JoshChomps/7_DOF_Arm/hardware/bom_order1.csv

board | qty | refs | value | footprint | mpn | lcsc | fit
A | 4 | C1 C2 C6 C7 | 100nF | C_0603_1608Metric | AM03B104K500NT | C20616238 | PCBA
A | 3 | C10 C11 C12 | 47uF | C_1210_3225Metric | HGC1210R5476M250NSVK | C7432791 | PCBA
A | 1 | C3 | 1000uF 35V | CP_Radial_D12.5mm_P5.00mm |  |  | hand
A | 2 | C4 C5 | 4.7uF | C_1206_3216Metric | HHV1206R7475K101NSPJ | C22367839 | PCBA
A | 1 | C8 | 4.7nF | C_0603_1608Metric | CGA0603X7R472K500JT | C7503499 | PCBA
A | 1 | C9 | 47pF | C_0603_1608Metric | CSA0603C0G470J500JT | C18220914 | PCBA
A | 1 | D1 | BZT52C15 15V | D_SOD-123 |  |  | PCBA
A | 2 | D2 D5 | SMCJ26CA | D_SMC |  |  | PCBA
A | 1 | D3 | S1M flyback | D_SMA |  |  | PCBA
A | 1 | D4 | COIL ON yellow | LED_0603_1608Metric | YLED0603Y | C19273152 | PCBA
A | 1 | D6 | MOTOR PWR red | LED_0603_1608Metric | XL-1608SURC-06FJ | C7371900 | PCBA
A | 1 | D7 | B560C | D_SMC |  |  | PCBA
A | 1 | D8 | +5V green | LED_0603_1608Metric | F.0603.00025/P2-0603G1TS2-06T-002 | C7496818 | PCBA
A | 1 | F1 | 2A logic | Fuse_1812_4532Metric |  |  | PCBA
A | 1 | F2 | 1A coil | Fuse_1206_3216Metric |  |  | PCBA
A | 1 | F3 | J1+J2 blade | Fuseholder_Blade_Mini_Keystone_3568 |  |  | hand
A | 1 | F4 | J3+J4 blade | Fuseholder_Blade_Mini_Keystone_3568 |  |  | hand
A | 1 | F5 | J5-J7 blade | Fuseholder_Blade_Mini_Keystone_3568 |  |  | hand
A | 1 | F6 | AUX/tool blade | Fuseholder_Blade_Mini_Keystone_3568 |  |  | hand
A | 1 | J1 | 24V IN XT30 male | AMASS_XT30UPB-M_1x02_P5.0mm_Vertical |  |  | hand
A | 1 | J10 | 5V AUX | JST_XH_B2B-XH-A_1x02_P2.50mm_Vertical |  |  | hand
A | 1 | J2 | E-STOP NC loop | TerminalBlock_Phoenix_MKDS-1,5-2-5.08_1x02_P5.08mm_Horizontal |  |  | hand
A | 1 | J3 | CONTACTOR COIL 24V | TerminalBlock_Phoenix_MKDS-1,5-2-5.08_1x02_P5.08mm_Horizontal |  |  | hand
A | 1 | J4 | CONTACTOR MAIN 1=line 2=load | TerminalBlock_Phoenix_MKDS-3-2-5.08_1x02_P5.08mm_Horizontal |  |  | hand
A | 1 | J5 | MOT J1+J2 XT30 female | AMASS_XT30UPB-F_1x02_P5.0mm_Vertical |  |  | hand
A | 1 | J6 | MOT J3+J4 XT30 female | AMASS_XT30UPB-F_1x02_P5.0mm_Vertical |  |  | hand
A | 1 | J7 | MOT J5-J7 XT30 female | AMASS_XT30UPB-F_1x02_P5.0mm_Vertical |  |  | hand
A | 1 | J8 | AUX/tool XT30 female | AMASS_XT30UPB-F_1x02_P5.0mm_Vertical |  |  | hand
A | 1 | J9 | TO BOARD B | JST_XH_B8B-XH-A_1x08_P2.50mm_Vertical |  |  | hand
A | 1 | L1 | 6.8uH | L_7.3x7.3_H4.5 | ZEMS0730-6R8M | C41415571 | PCBA
A | 2 | Q1 Q2 | AOD4185 | TO-252-2 |  |  | PCBA
A | 1 | Q3 | DMN6075S | SOT-23 |  |  | PCBA
A | 2 | R1 R2 | 10k | R_0603_1608Metric |  |  | PCBA
A | 1 | R10 | 90.9k | R_0603_1608Metric |  |  | PCBA
A | 1 | R11 | 200k | R_0603_1608Metric | ABD03K2003FT | C43720265 | PCBA
A | 1 | R12 | 16.9k | R_0603_1608Metric |  |  | PCBA
A | 1 | R13 | 53.6k | R_0603_1608Metric |  |  | PCBA
A | 1 | R14 | 10.2k | R_0603_1608Metric |  |  | PCBA
A | 1 | R15 | 1k | R_0603_1608Metric |  |  | PCBA
A | 1 | R3 | 100 | R_0603_1608Metric |  |  | PCBA
A | 1 | R4 | 100k | R_0603_1608Metric |  |  | PCBA
A | 1 | R5 | 0R bypass, fitted | R_1206_3216Metric |  |  | PCBA
A | 2 | R6 R8 | 10k | R_1206_3216Metric |  |  | PCBA
A | 1 | R7 | 2m | R_2512_6332Metric |  |  | PCBA
A | 1 | R9 | 442k | R_0603_1608Metric |  |  | PCBA
A | 1 | TP1 | 24V_IN | TestPoint_Pad_D1.5mm |  |  | pad only
A | 1 | TP2 | 24V_PROT | TestPoint_Pad_D1.5mm |  |  | pad only
A | 1 | TP3 | MOTOR_RAIL | TestPoint_Pad_D1.5mm |  |  | pad only
A | 1 | TP4 | +5V | TestPoint_Pad_D1.5mm |  |  | pad only
A | 1 | TP5 | COIL_LOW | TestPoint_Pad_D1.5mm |  |  | pad only
A | 1 | TP6 | GND | TestPoint_Pad_D1.5mm |  |  | pad only
A | 1 | TP7 | 24V_LOGIC | TestPoint_Pad_D1.5mm |  |  | pad only
A | 1 | U1 | TPS54560BDDA | Texas_R-PDSO-G8_EP2.95x4.9mm_Mask2.4x3.1mm_ThermalVias | TPS54560BDDAR |  | PCBA
A | 1 | U2 | INA226 | TSSOP-10_3x3mm_P0.5mm |  |  | PCBA
B | 1 | C3 | 1uF | C_0603_1608Metric | HGC0603R7105K250NTHJ | C33546005 | PCBA
B | 3 | C1 C4 C5 | 10uF | C_0805_2012Metric | HGC0805R5106K250NSLJ | C19103847 | PCBA
B | 4 | C2 C6 C7 C8 | 100nF | C_0603_1608Metric | AM03B104K500NT | C20616238 | PCBA
B | 1 | D1 | WS2812B-2020 status | LED_WS2812B-2020_PLCC4_2.0x2.0mm |  |  | PCBA
B | 2 | D2 D3 | SS14 | D_SMA |  |  | PCBA
B | 1 | D4 | 3V3 green | LED_0603_1608Metric | F.0603.00025/P2-0603G1TS2-06T-002 | C7496818 | PCBA
B | 1 | J1 | USB-C (native USB, CDC) | USB_C_Receptacle_GCT_USB4105-xx-A_16P_TopMnt_Horizontal |  |  | PCBA
B | 1 | J10 | SPARE GPIO | PinHeader_1x14_P2.54mm_Vertical |  |  | hand
B | 1 | J2 | CAN A: H L GND | JST_XH_B3B-XH-A_1x03_P2.50mm_Vertical |  |  | hand
B | 1 | J3 | CAN B: H L GND | JST_XH_B3B-XH-A_1x03_P2.50mm_Vertical |  |  | hand
B | 1 | J4 | E-STOP AUX NC (to GND) | JST_XH_B2B-XH-A_1x02_P2.50mm_Vertical |  |  | hand
B | 1 | J5 | HALL 1: 5V GND OUT | JST_XH_B3B-XH-A_1x03_P2.50mm_Vertical |  |  | hand
B | 1 | J6 | HALL 2: 5V GND OUT | JST_XH_B3B-XH-A_1x03_P2.50mm_Vertical |  |  | hand
B | 1 | J7 | MT6701 SSI: 3V3 GND CSN CLK DO | JST_XH_B5B-XH-A_1x05_P2.50mm_Vertical |  |  | hand
B | 1 | J8 | TO BOARD A | JST_XH_B8B-XH-A_1x08_P2.50mm_Vertical |  |  | hand
B | 1 | J9 | UART0: TX RX GND | PinHeader_1x03_P2.54mm_Vertical |  |  | hand
B | 1 | JP1 | CAN TERM (fit = bus end) | PinHeader_1x02_P2.54mm_Vertical |  |  | hand
B | 8 | R1 R2 R7 R9 R10 R11 R12 R15 | 10k | R_0603_1608Metric |  |  | PCBA
B | 2 | R13 R14 | 4.7k | R_0603_1608Metric |  |  | PCBA
B | 2 | R3 R4 | 5.1k | R_0603_1608Metric |  |  | PCBA
B | 1 | R5 | 0R (Rs: 10k-100k = slope control) | R_0603_1608Metric |  |  | PCBA
B | 1 | R6 | 120 | R_1206_3216Metric |  |  | PCBA
B | 2 | R8 R16 | 1k | R_0603_1608Metric |  |  | PCBA
B | 1 | SW1 | RESET | SW_Push_1P1T_XKB_TS-1187A |  |  | PCBA
B | 1 | SW2 | BOOT | SW_Push_1P1T_XKB_TS-1187A |  |  | PCBA
B | 1 | TP1 | CANH | TestPoint_Pad_D1.5mm |  |  | pad only
B | 1 | TP2 | CANL | TestPoint_Pad_D1.5mm |  |  | pad only
B | 1 | TP3 | CAN_TX | TestPoint_Pad_D1.5mm |  |  | pad only
B | 1 | TP4 | CAN_RX | TestPoint_Pad_D1.5mm |  |  | pad only
B | 1 | TP5 | +3V3 | TestPoint_Pad_D1.5mm |  |  | pad only
B | 1 | TP6 | +5VD | TestPoint_Pad_D1.5mm |  |  | pad only
B | 1 | TP7 | GND | TestPoint_Pad_D1.5mm |  |  | pad only
B | 1 | U1 | ESP32-S3-WROOM-1-N8 | ESP32-S3-WROOM-1 |  |  | PCBA
B | 1 | U2 | USBLC6-2SC6 | SOT-23-6 |  |  | PCBA
B | 1 | U3 | SN65HVD230 | SOIC-8_3.9x4.9mm_P1.27mm |  |  | PCBA
B | 1 | U4 | AP2112K-3.3 | SOT-23-5 | AP2112K-3.3TRG1 |  | PCBA
C | 1 | C1 | 1uF | C_0603_1608Metric | HGC0603R7105K250NTHJ | C33546005 | PCBA
C | 5 | C2 C6 C7 C11 C12 | 10uF | C_0805_2012Metric | HGC0805R5106K250NSLJ | C19103847 | PCBA
C | 5 | C3 C4 C5 C9 C10 | 100nF | C_0603_1608Metric | AM03B104K500NT | C20616238 | PCBA
C | 1 | C8 | 4.7uF 100V | C_1206_3216Metric | HHV1206R7475K101NSPJ | C22367839 | PCBA
C | 2 | D1 D3 | SS16 | D_SMA |  |  | PCBA
C | 1 | D2 | SMAJ36A | D_SMA |  |  | PCBA
C | 2 | D4 D5 | SS14 | D_SMA |  |  | PCBA
C | 2 | D6 D7 | green (status / 3V3) | LED_0603_1608Metric | F.0603.00025/P2-0603G1TS2-06T-002 | C7496818 | PCBA
C | 1 | J1 | 24V IN: 24V GND | JST_XH_B2B-XH-A_1x02_P2.50mm_Vertical |  |  | hand
C | 1 | J2 | CAN IN: H L GND | JST_XH_B3B-XH-A_1x03_P2.50mm_Vertical |  |  | hand
C | 1 | J3 | CAN OUT: H L GND | JST_XH_B3B-XH-A_1x03_P2.50mm_Vertical |  |  | hand
C | 1 | J4 | USB-C (programming) | USB_C_Receptacle_GCT_USB4105-xx-A_16P_TopMnt_Horizontal |  |  | PCBA
C | 1 | J5 | AUX: 3V3 IO0 IO1 TXD RXD GND | PinHeader_1x06_P2.54mm_Vertical |  |  | hand (optional)
C | 1 | JP1 | CAN TERM (open = mid-bus) | PinHeader_1x02_P2.54mm_Vertical |  |  | hand
C | 1 | L1 | 10uH | L_APV_ANR4030 | ANR4030T100M | C6808095 | PCBA
C | 7 | R1 R2 R3 R4 R10 R11 R12 | 10k | R_0603_1608Metric |  |  | PCBA
C | 2 | R5 R14 | 1k | R_0603_1608Metric |  |  | PCBA
C | 2 | R6 R7 | 5.1k | R_0603_1608Metric |  |  | PCBA
C | 1 | R8 | 0R (Rs: 10k-100k = slope control) | R_0603_1608Metric |  |  | PCBA
C | 1 | R9 | 120 | R_1206_3216Metric |  |  | PCBA
C | 1 | R13 | 100k | R_0603_1608Metric |  |  | PCBA
C | 1 | SW1 | RESET | SW_Push_1P1T_XKB_TS-1187A |  |  | PCBA
C | 1 | SW2 | BOOT | SW_Push_1P1T_XKB_TS-1187A |  |  | PCBA
C | 11 | TP1-TP11 | VIN_C +5V +3V3 GND CANH CANL CAN_TX CAN_RX ENC_CSN ENC_CLK ENC_DO | TestPoint_Pad_D1.5mm |  |  | pad only
C | 1 | U1 | ESP32-C3-WROOM-02-N4 | ESP32-C3-WROOM-02 |  |  | PCBA
C | 1 | U2 | USBLC6-2SC6 | SOT-23-6 |  |  | PCBA
C | 1 | U3 | SN65HVD230 | SOIC-8_3.9x4.9mm_P1.27mm |  |  | PCBA
C | 1 | U4 | AP2112K-3.3 | SOT-23-5 | AP2112K-3.3TRG1 |  | PCBA
C | 1 | U5 | LMR16006YQ5 (TI; DDC package) | TSOT-23-6 | LMR16006YQ5 |  | PCBA
C | 1 | U6 | MT6701CT-STD | SOIC-8_3.9x4.9mm_P1.27mm | MT6701CT-STD |  | PCBA
