JoshChomps/7_DOF_Arm/cad/bench/planetary_5to1_sun.stl

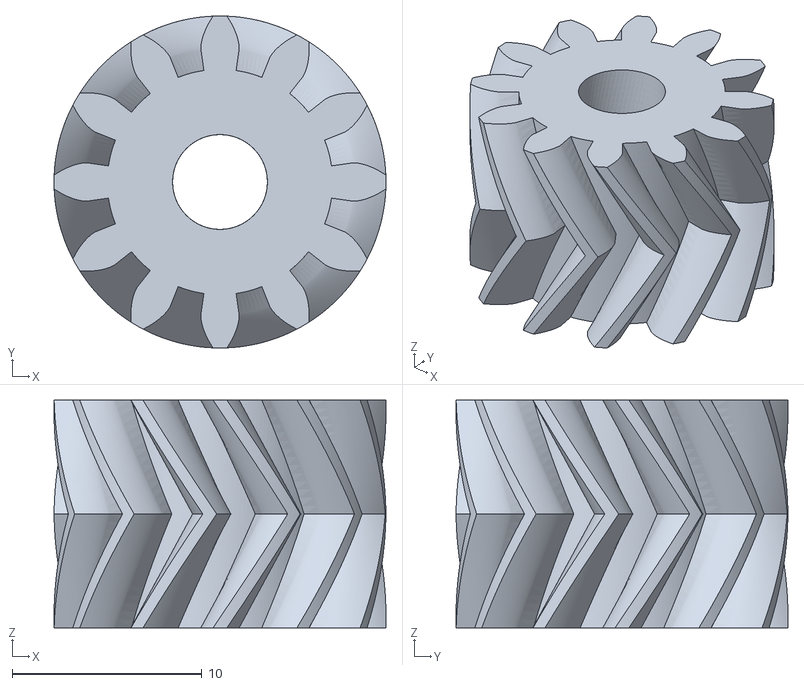
[picture p17: CAD file, 2026-10-28]
cad/bench/planetary_5to1_sun.stl
17.5 x 17.5 x 12.0
