JoshChomps/7_DOF_Arm/cad/cycloid_j1.dxf

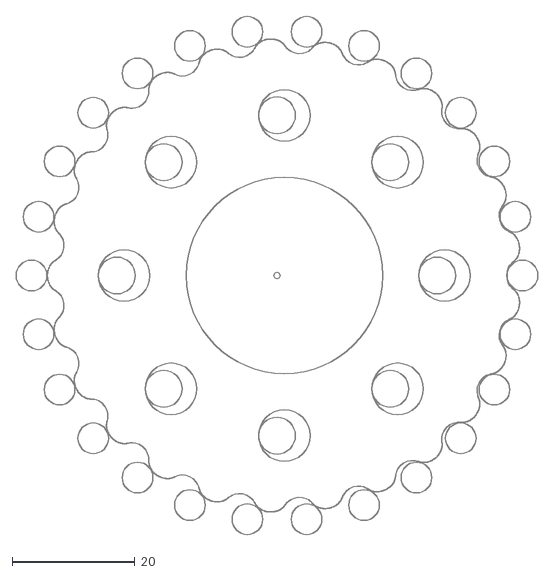
[picture p18: CAD file, 2026-10-28]
cad/cycloid_j1.dxf
85.0 x 84.4
