JoshChomps/7_DOF_Arm/software/deskarm/data/meshes/4_motor.stl

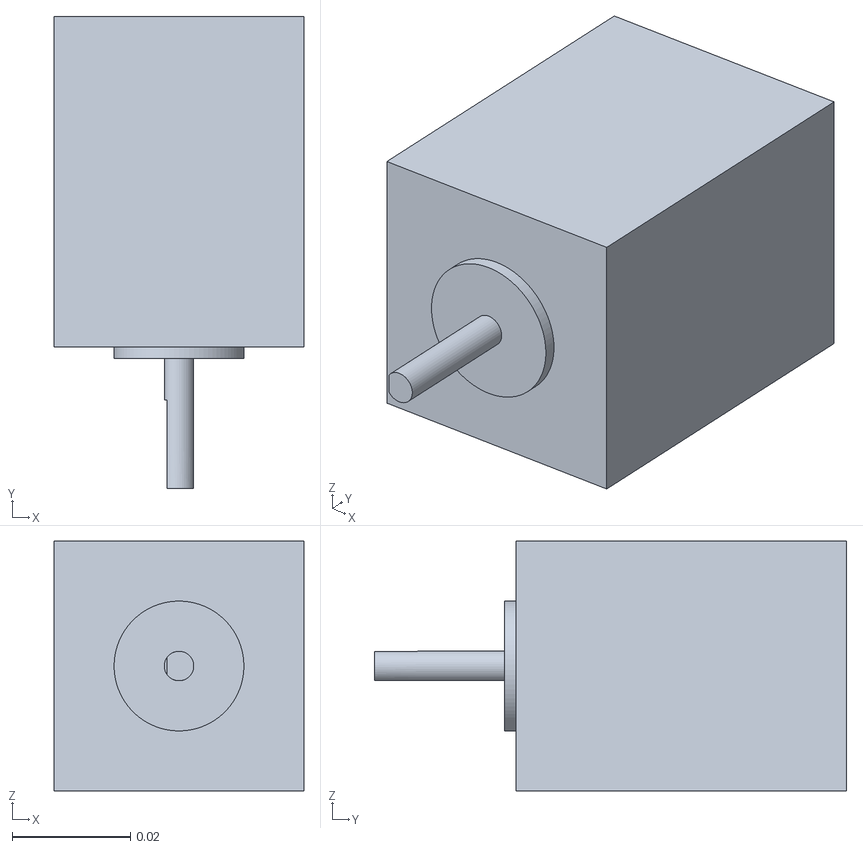
[picture p19: CAD file, 2026-10-28]
software/deskarm/data/meshes/4_motor.stl
0.0423 x 0.08 x 0.0423
