JoshChomps/7_DOF_Arm/stl/bench/C2_Lever.stl

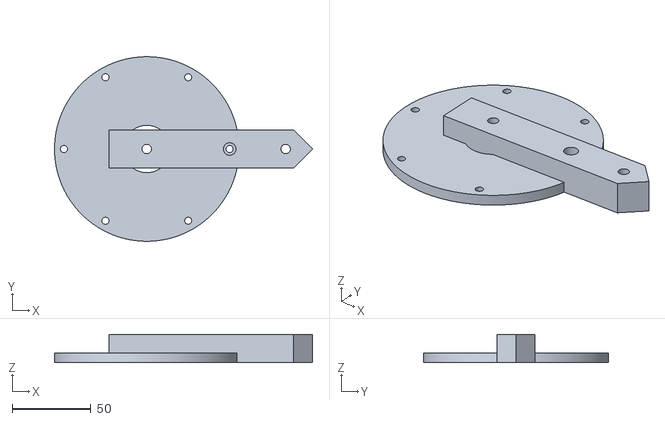
[picture p20: CAD file, 2026-10-28]
stl/bench/C2_Lever.stl
163.5 x 117.0 x 18.0
