JoshChomps/7_DOF_Arm/stl/coupons/rings_6810.stl

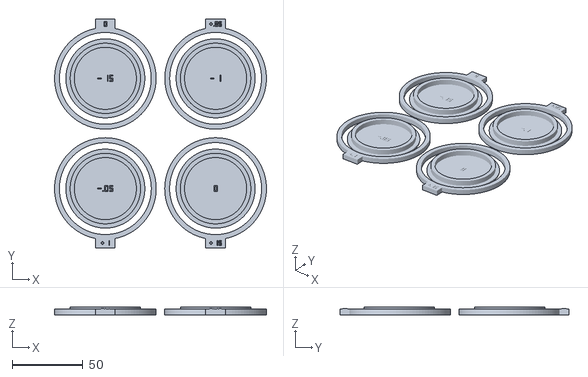
[picture p21: CAD file, 2026-10-28]
stl/coupons/rings_6810.stl
150.3 x 162.2 x 5.50
