JoshChomps/7_DOF_Arm/stl/da/DA_G_Pads.stl

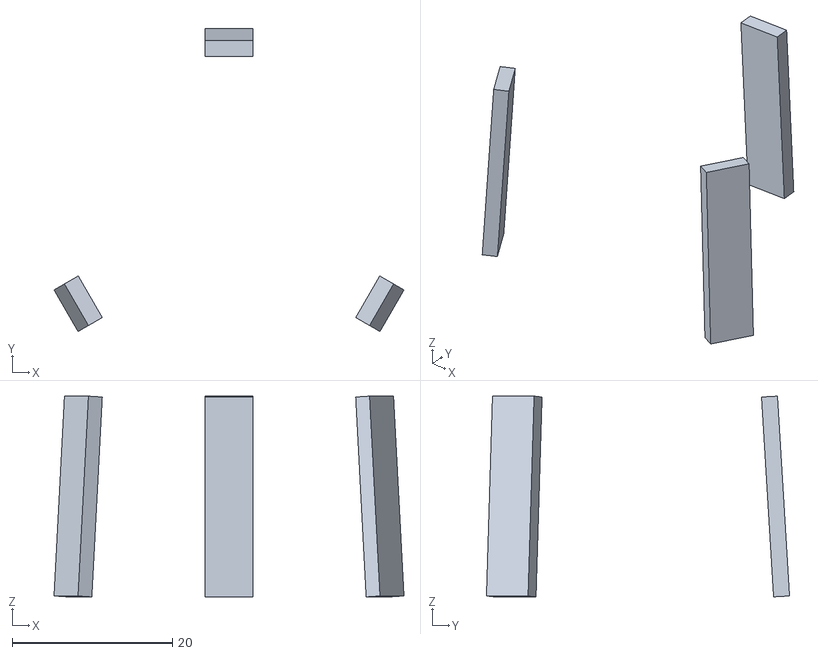
[picture p22: CAD file, 2026-10-28]
stl/da/DA_G_Pads.stl
43.7 x 37.9 x 25.1
