JoshChomps/7_DOF_Arm/stl/j1/J1_base.stl

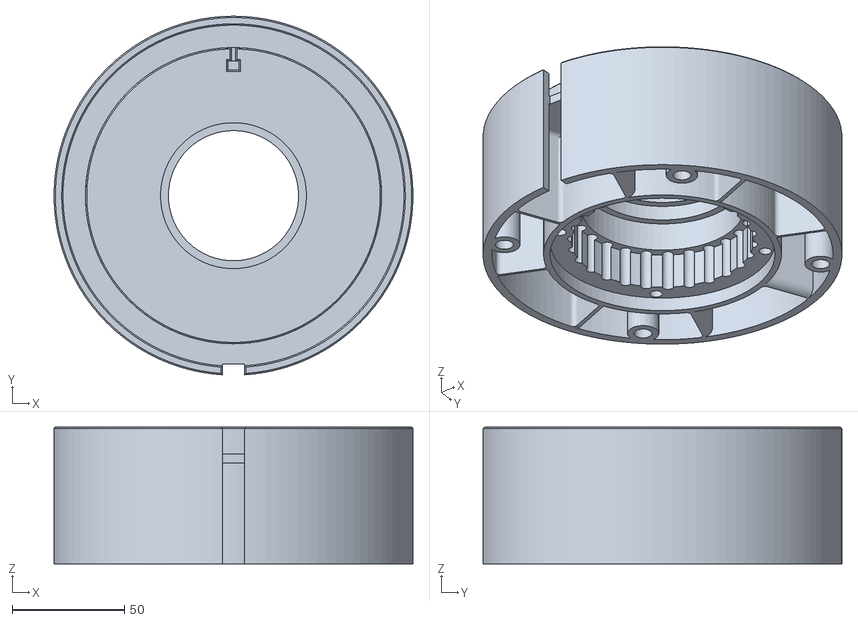
[picture p23: CAD file, 2026-10-28]
stl/j1/J1_base.stl
160.0 x 159.8 x 61.0
