JoshChomps/7_DOF_Arm/stl/plates/bench/plate_2.3mf

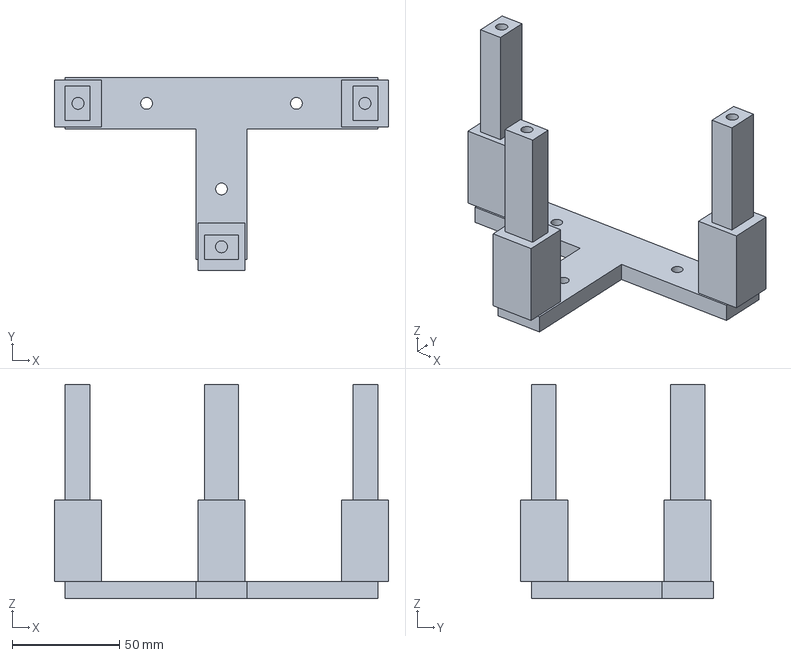
[picture p24: CAD file, 2026-10-28]
stl/plates/bench/plate_2.3mf
156.0 x 90.0 x 100.0 mm
