JoshChomps/7_DOF_Arm/stl/plates/c2/plate_6.3mf

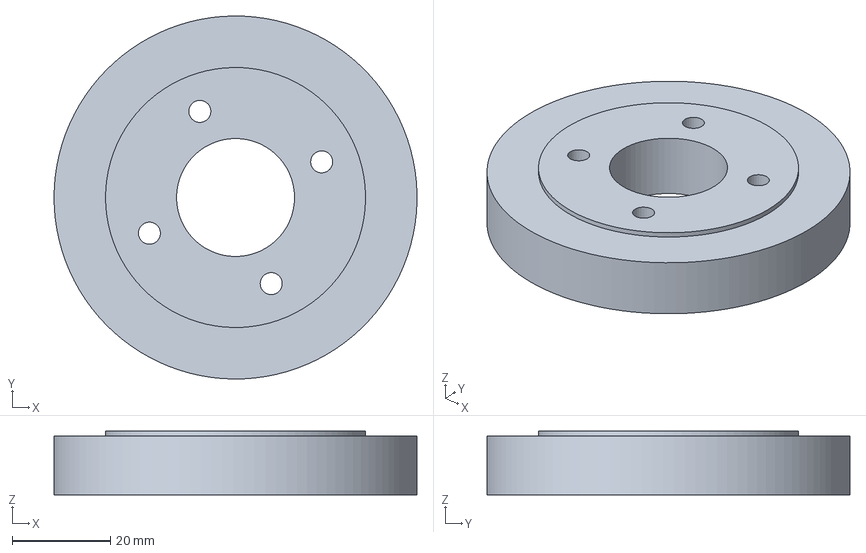
[picture p25: CAD file, 2026-10-28]
stl/plates/c2/plate_6.3mf
74.0 x 74.0 x 13.0 mm
