JoshChomps/7_DOF_Arm/stl/plates/coupons/plate_1.3mf

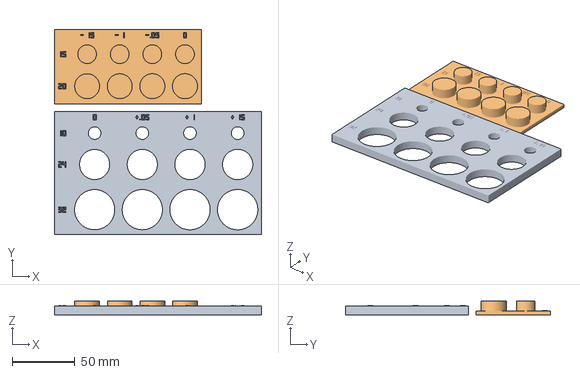
[picture p26: CAD file, 2026-10-28]
stl/plates/coupons/plate_1.3mf
165.0 x 163.8 x 11.0 mm
bearings.stl
pegs.stl
