JoshChomps/7_DOF_Arm/cad/bench/planetary_5to1_planet.stl

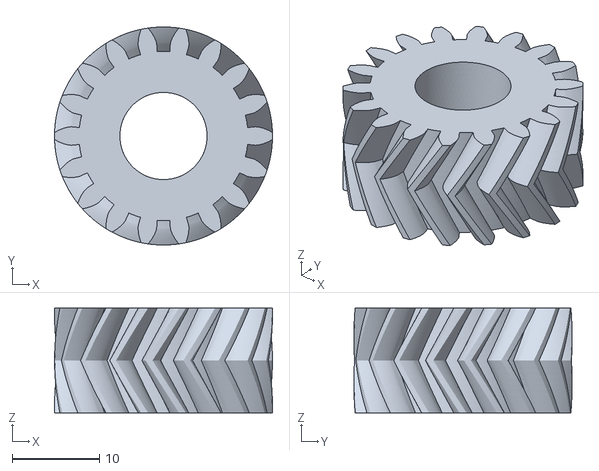
[picture p27: CAD file, 2026-10-28]
cad/bench/planetary_5to1_planet.stl
25.0 x 25.0 x 12.0
