JoshChomps/7_DOF_Arm/cad/cycloid_disc.dxf

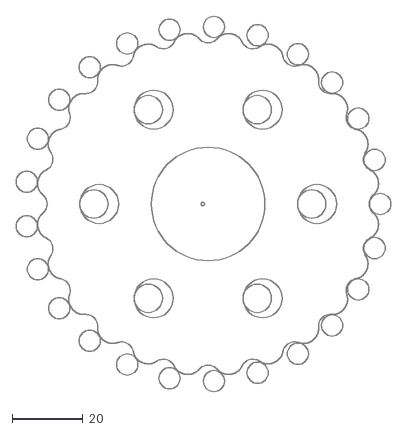
[picture p28: CAD file, 2026-10-28]
cad/cycloid_disc.dxf
105.6 x 105.8
