JoshChomps/7_DOF_Arm/software/deskarm/data/meshes/3_metal.stl

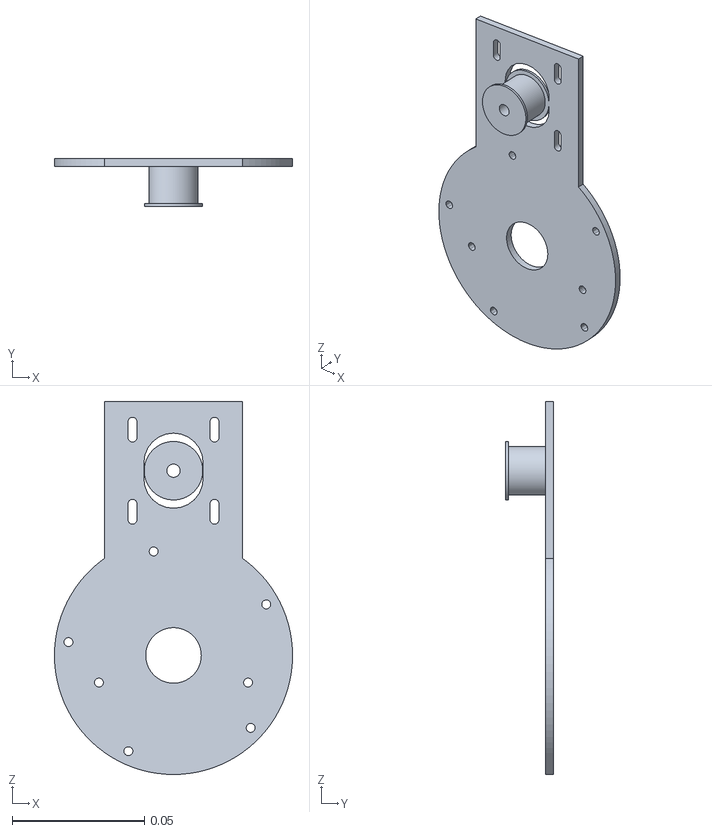
[picture p29: CAD file, 2026-10-28]
software/deskarm/data/meshes/3_metal.stl
0.09 x 0.018 x 0.141
