JoshChomps/7_DOF_Arm/stl/bench/C34_motor_plate.dxf

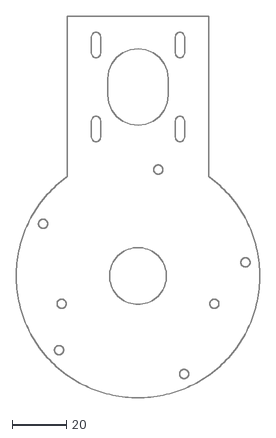
[picture p30: CAD file, 2026-10-28]
stl/bench/C34_motor_plate.dxf
90.0 x 140.9
