JoshChomps/7_DOF_Arm/stl/coupons/inserts.stl

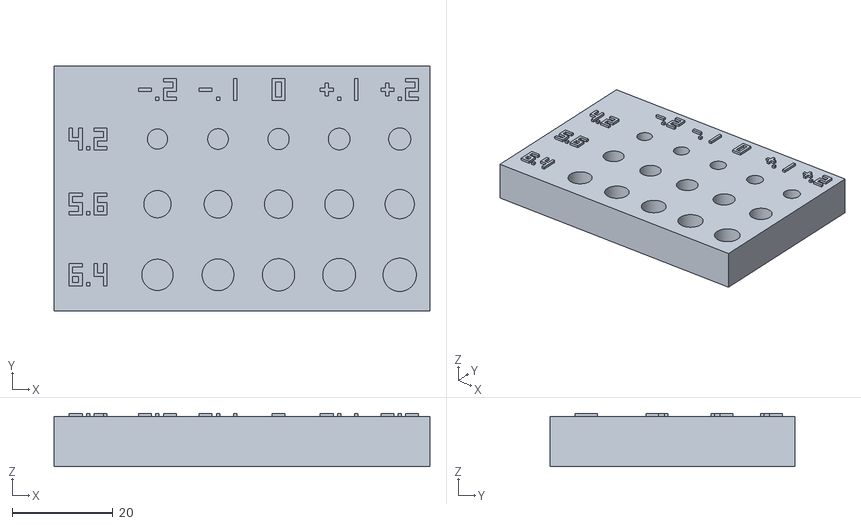
[picture p31: CAD file, 2026-10-28]
stl/coupons/inserts.stl
74.5 x 48.6 x 10.6
