JoshChomps/7_DOF_Arm/stl/da/DA_C34_Flange.stl

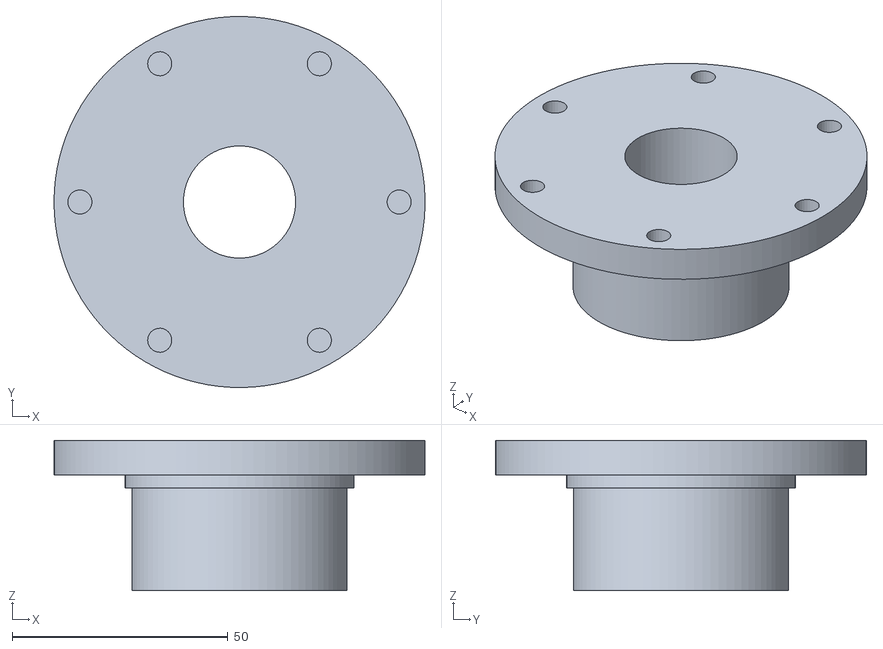
[picture p32: CAD file, 2026-10-28]
stl/da/DA_C34_Flange.stl
86.0 x 86.0 x 34.8
