JoshChomps/7_DOF_Arm/stl/j1/J1_disc.stl

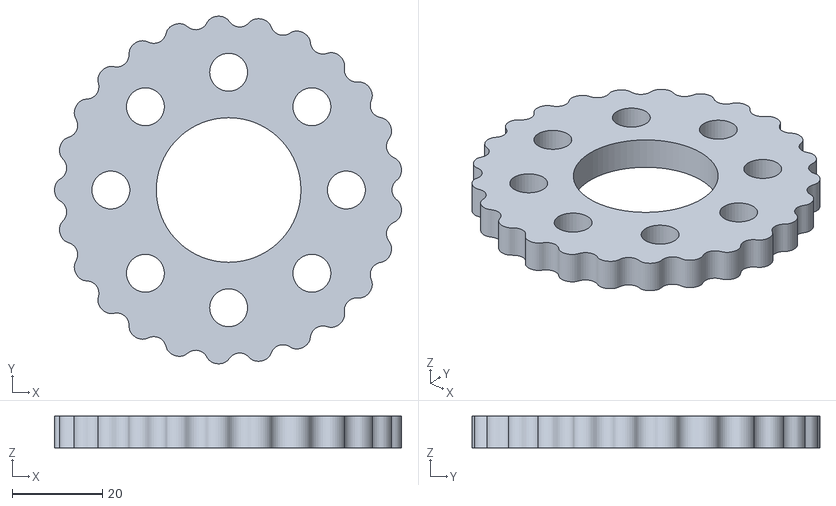
[picture p33: CAD file, 2026-10-28]
stl/j1/J1_disc.stl
76.9 x 77.1 x 7.00
