JoshChomps/7_DOF_Arm/stl/plates/c2/plate_5.3mf

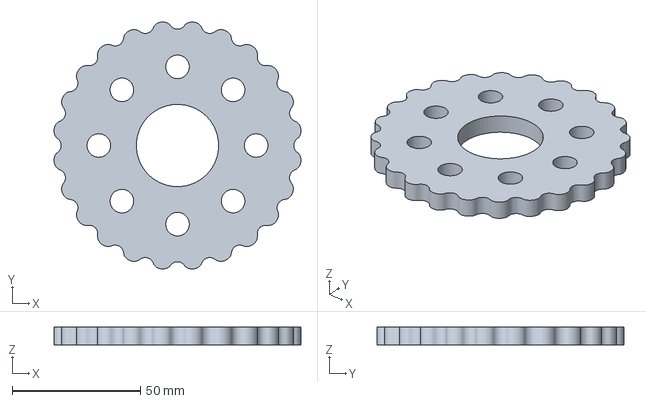
[picture p34: CAD file, 2026-10-28]
stl/plates/c2/plate_5.3mf
96.2 x 96.2 x 7.00 mm
