JoshChomps/7_DOF_Arm/stl/plates/coupons/plate_2.3mf

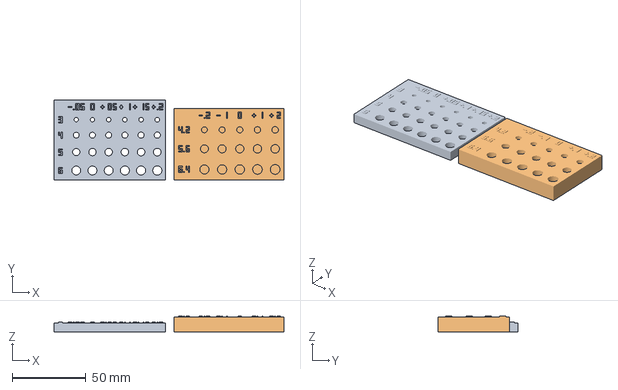
[picture p35: CAD file, 2026-10-28]
stl/plates/coupons/plate_2.3mf
156.1 x 54.4 x 10.6 mm
pins.stl
inserts.stl
