JoshChomps/7_DOF_Arm/stl/plates/rings/plate_2.3mf

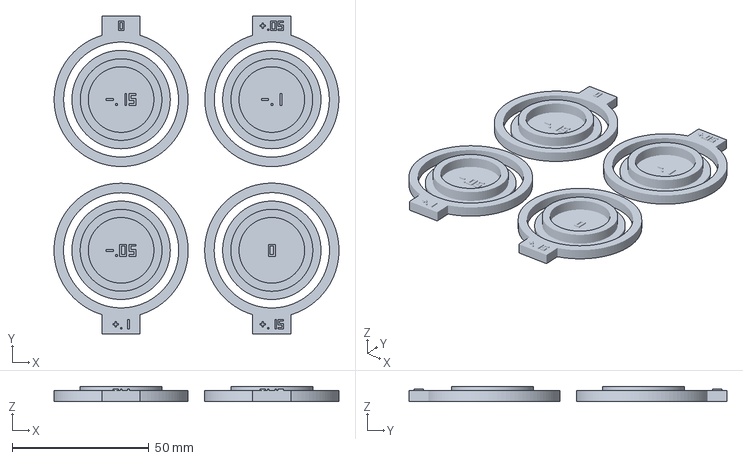
[picture p36: CAD file, 2026-10-28]
stl/plates/rings/plate_2.3mf
104.3 x 116.2 x 5.50 mm
