JoshChomps/7_DOF_Arm/cad/bench/cycloid_j2_24to1.dxf

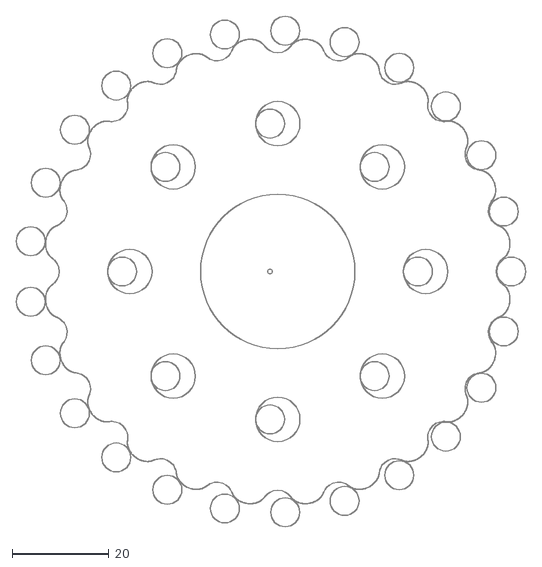
[picture p37: CAD file, 2026-10-28]
cad/bench/cycloid_j2_24to1.dxf
105.6 x 105.8
