JoshChomps/7_DOF_Arm/software/deskarm/data/meshes/2_printed.stl

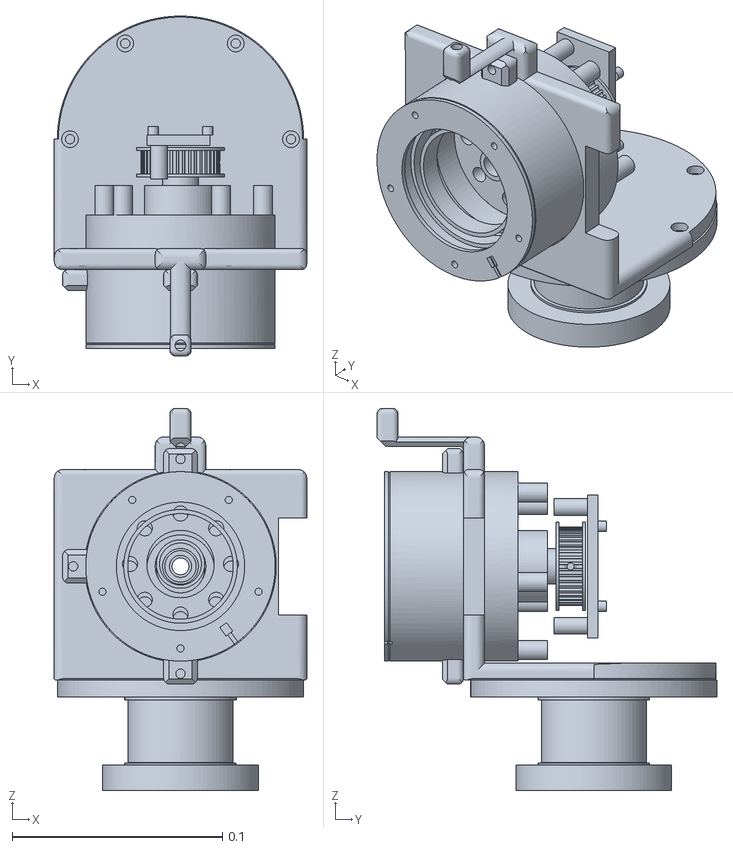
[picture p38: CAD file, 2026-10-28]
software/deskarm/data/meshes/2_printed.stl
0.12 x 0.161 x 0.182
