JoshChomps/7_DOF_Arm/stl/coupons/pins.stl

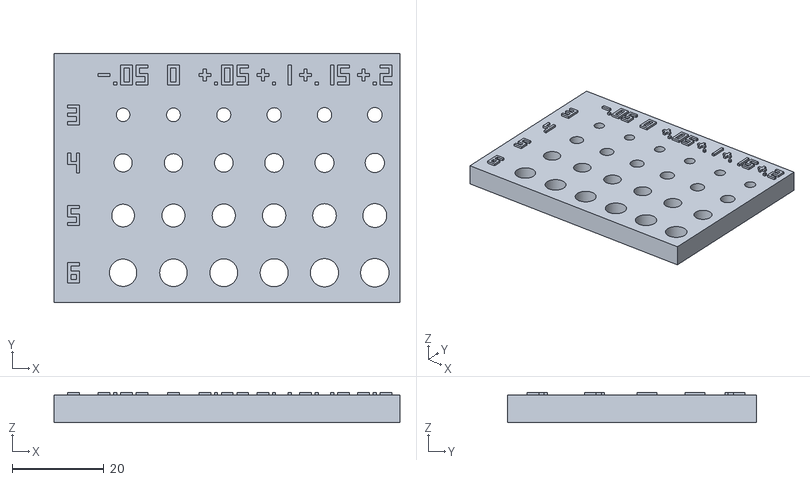
[picture p39: CAD file, 2026-10-28]
stl/coupons/pins.stl
75.6 x 54.4 x 6.60
