JoshChomps/7_DOF_Arm/stl/da/DA_P56_Housing.stl

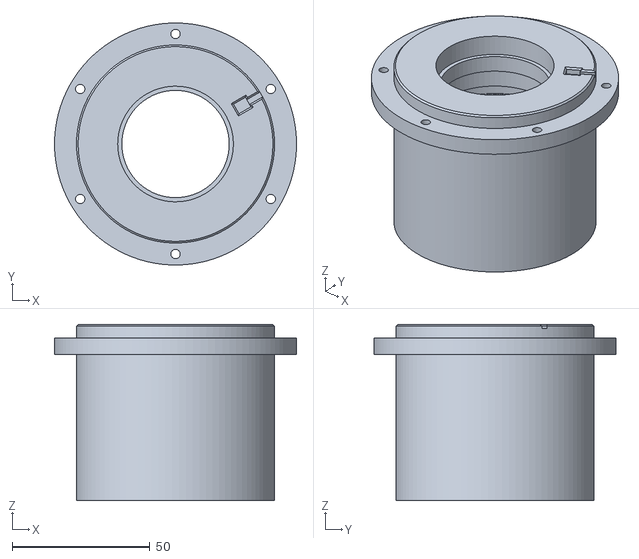
[picture p40: CAD file, 2026-10-28]
stl/da/DA_P56_Housing.stl
88.0 x 88.0 x 64.0
