JoshChomps/7_DOF_Arm/stl/j1/J1_turntable.stl

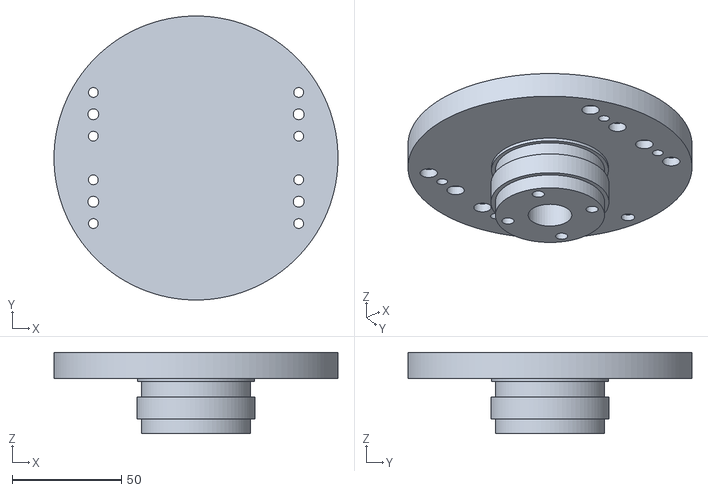
[picture p41: CAD file, 2026-10-28]
stl/j1/J1_turntable.stl
130.0 x 130.0 x 37.3
