JoshChomps/7_DOF_Arm/stl/plates/c2/plate_1.3mf

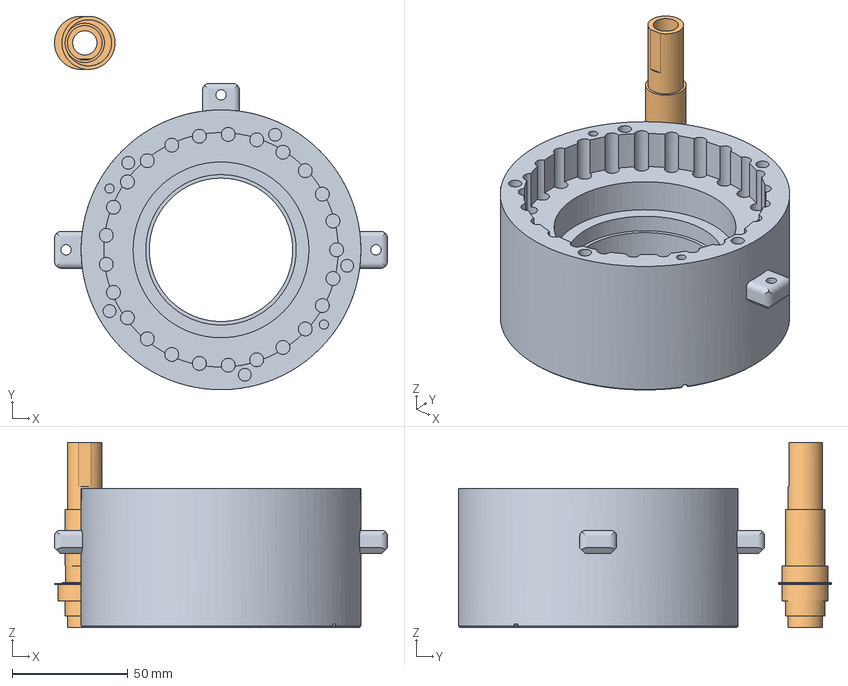
[picture p42: CAD file, 2026-10-28]
stl/plates/c2/plate_1.3mf
144.0 x 161.5 x 80.0 mm
DA_C2_Housing.stl
DA_C2_Shaft.stl
