JoshChomps/7_DOF_Arm/cad/bench/cycloid_j2_30to1.dxf

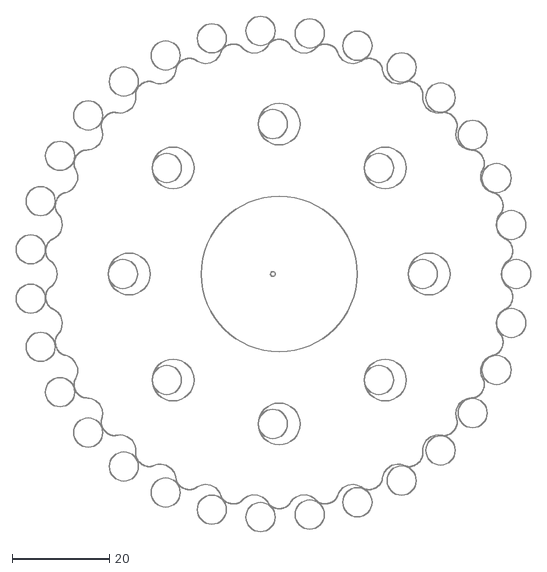
[picture p43: CAD file, 2026-10-28]
cad/bench/cycloid_j2_30to1.dxf
105.7 x 105.9
