JoshChomps/7_DOF_Arm/software/deskarm/data/meshes/1_belt.stl

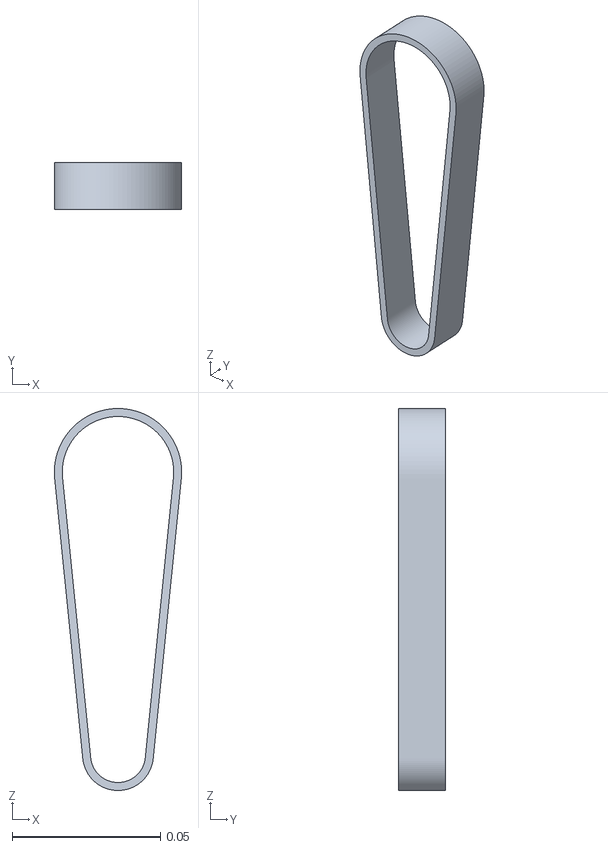
[picture p44: CAD file, 2026-10-28]
software/deskarm/data/meshes/1_belt.stl
0.043 x 0.016 x 0.129
