JoshChomps/7_DOF_Arm/stl/bench/C2_motor_plate.dxf

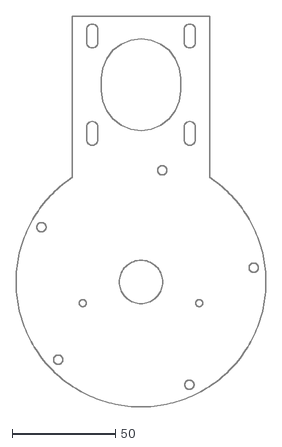
[picture p45: CAD file, 2026-10-28]
stl/bench/C2_motor_plate.dxf
121.0 x 189.2
