JoshChomps/7_DOF_Arm/stl/coupons/bearings.stl

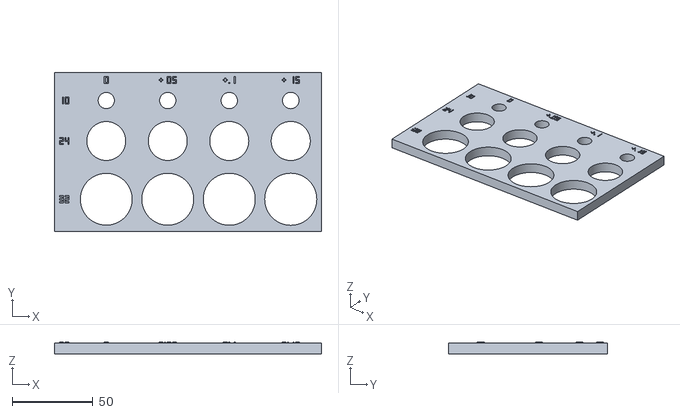
[picture p46: CAD file, 2026-10-28]
stl/coupons/bearings.stl
165.0 x 98.4 x 7.60
