JoshChomps/7_DOF_Arm/stl/da/DA_P7_Carrier.stl

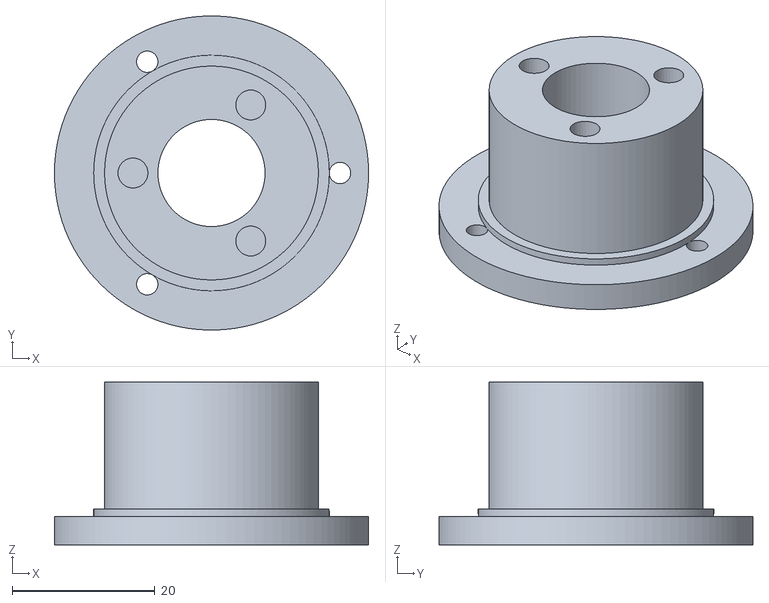
[picture p47: CAD file, 2026-10-28]
stl/da/DA_P7_Carrier.stl
44.0 x 44.0 x 22.8
