JoshChomps/7_DOF_Arm/stl/j1/J1_plate.stl

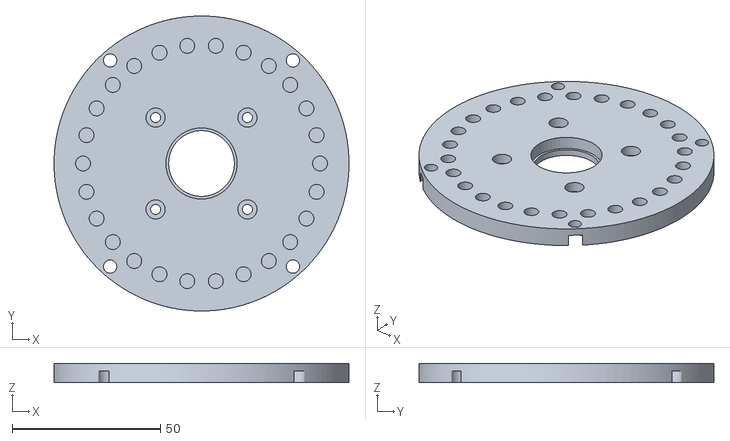
[picture p48: CAD file, 2026-10-28]
stl/j1/J1_plate.stl
99.6 x 99.6 x 6.50
