JoshChomps/7_DOF_Arm/stl/plates/c2/plate_3.3mf

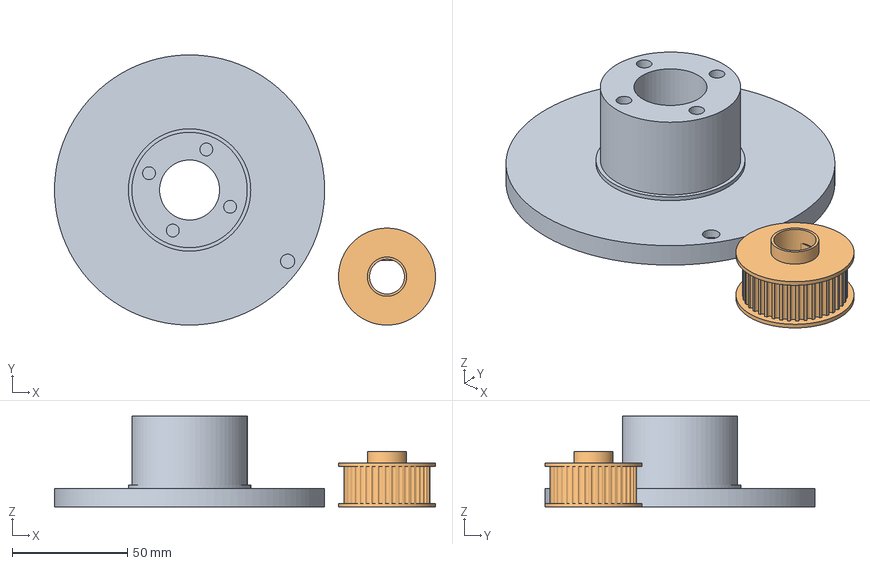
[picture p49: CAD file, 2026-10-28]
stl/plates/c2/plate_3.3mf
165.0 x 117.0 x 39.3 mm
DA_C2_Flange.stl
DA_C2_Pulley40.stl
