JoshChomps/7_DOF_Arm/cad/bench/planetary_5to1_ring.stl

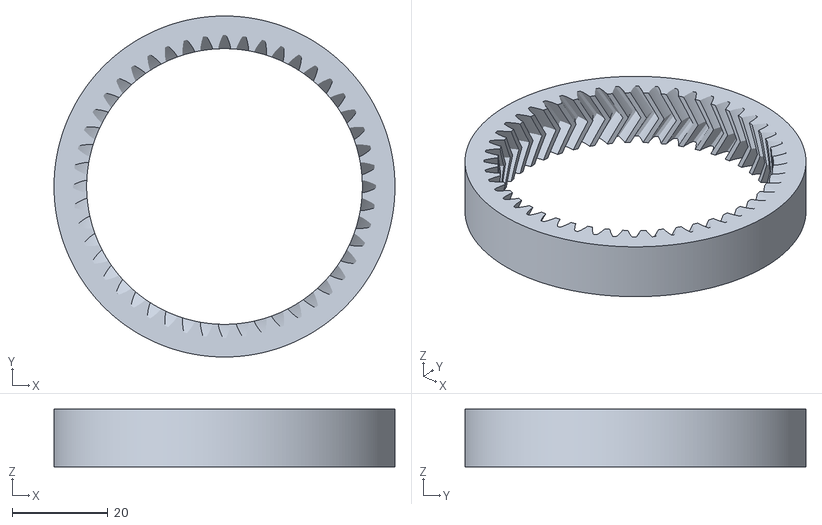
[picture p50: CAD file, 2026-10-28]
cad/bench/planetary_5to1_ring.stl
71.1 x 71.1 x 12.0
