JoshChomps/7_DOF_Arm/software/deskarm/data/meshes/4_printed.stl

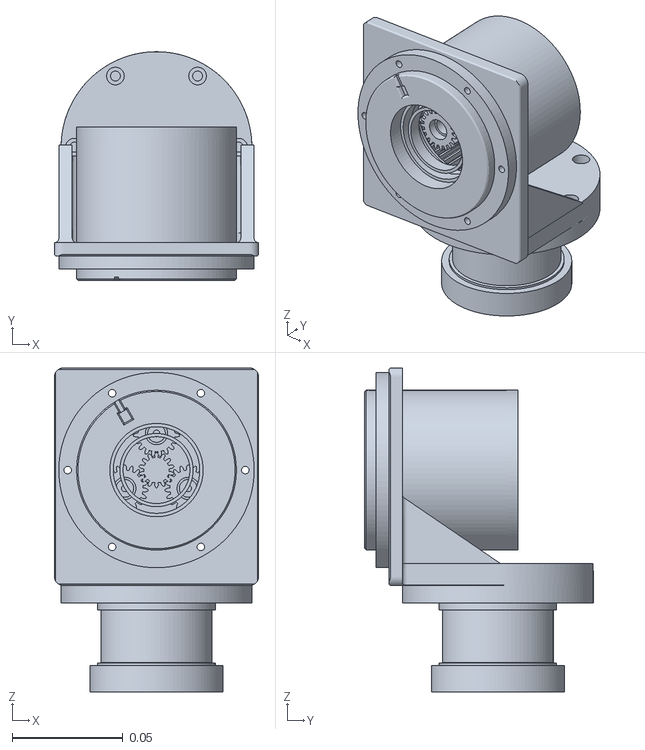
[picture p51: CAD file, 2026-10-28]
software/deskarm/data/meshes/4_printed.stl
0.092 x 0.103 x 0.146
