JoshChomps/7_DOF_Arm/stl/da/DA_P56_Flange.stl

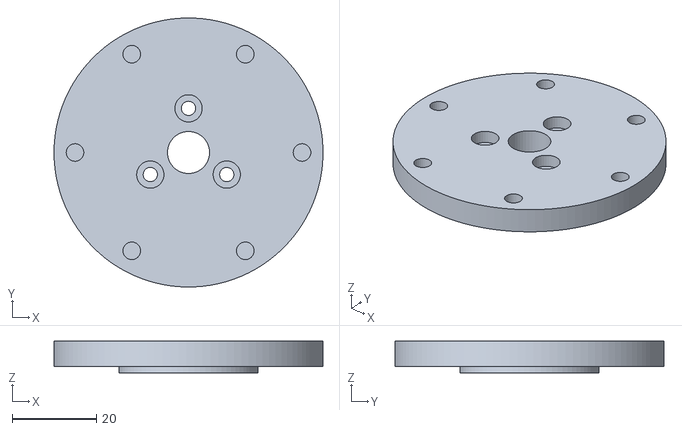
[picture p52: CAD file, 2026-10-28]
stl/da/DA_P56_Flange.stl
64.0 x 64.0 x 7.50
