JoshChomps/7_DOF_Arm/stl/j1/J1_cam.stl

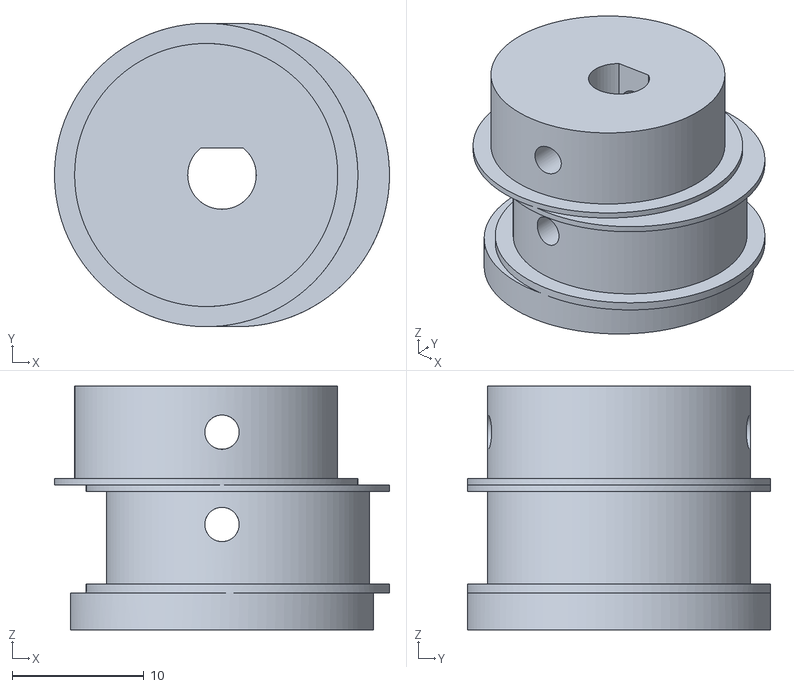
[picture p53: CAD file, 2026-10-28]
stl/j1/J1_cam.stl
25.4 x 23.0 x 18.5
