JoshChomps/7_DOF_Arm/stl/plates/c2/plate_2.3mf

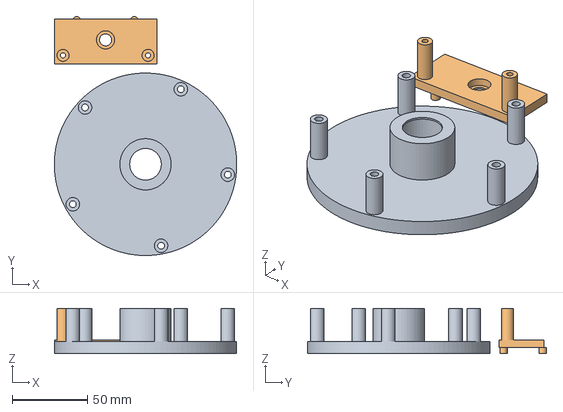
[picture p54: CAD file, 2026-10-28]
stl/plates/c2/plate_2.3mf
121.0 x 158.5 x 30.0 mm
DA_C2_Cover.stl
DA_C2_Enccap.stl
