JoshChomps/7_DOF_Arm/cad/bench/planetary_5to1_layout.dxf

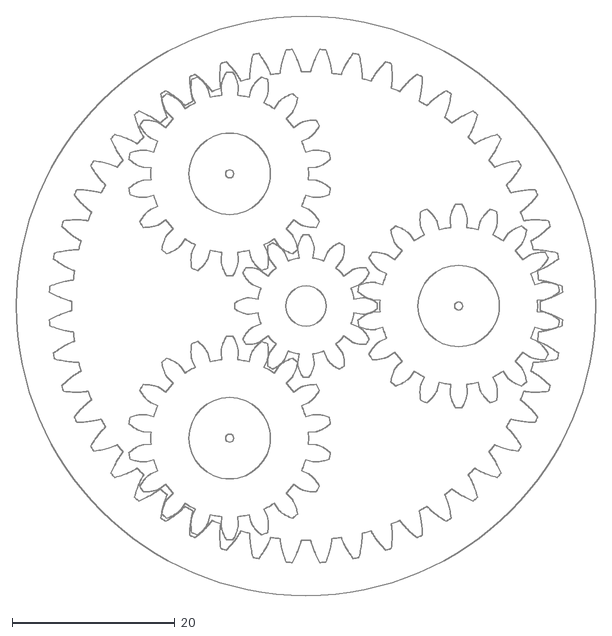
[picture p55: CAD file, 2026-10-28]
cad/bench/planetary_5to1_layout.dxf
71.1 x 71.1
