JoshChomps/7_DOF_Arm/software/deskarm/data/meshes/1_motor.stl

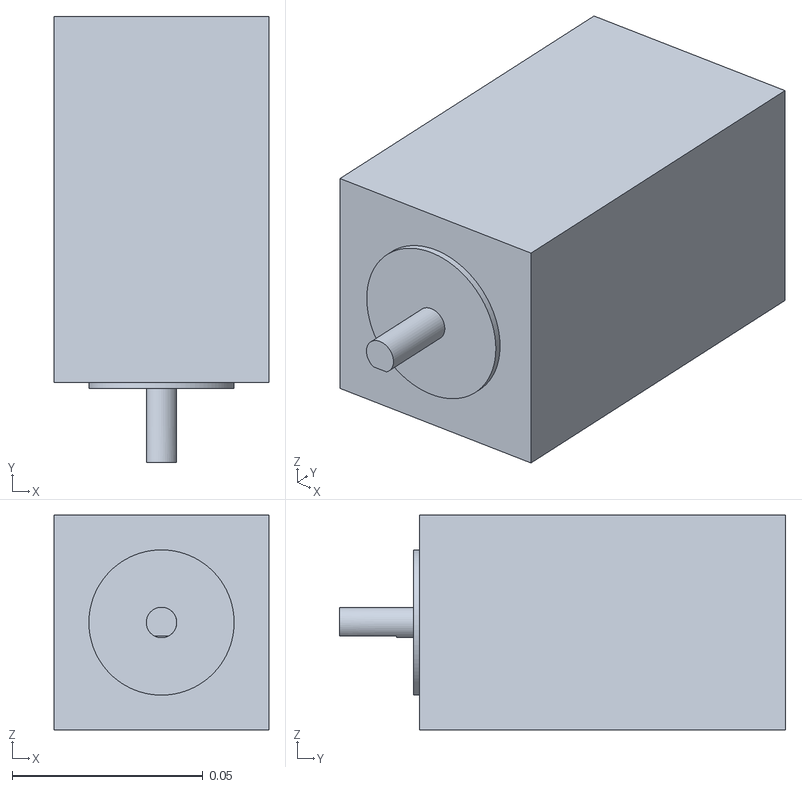
[picture p56: CAD file, 2026-10-28]
software/deskarm/data/meshes/1_motor.stl
0.0564 x 0.117 x 0.0564
