JoshChomps/7_DOF_Arm/stl/coupons/pegs.stl

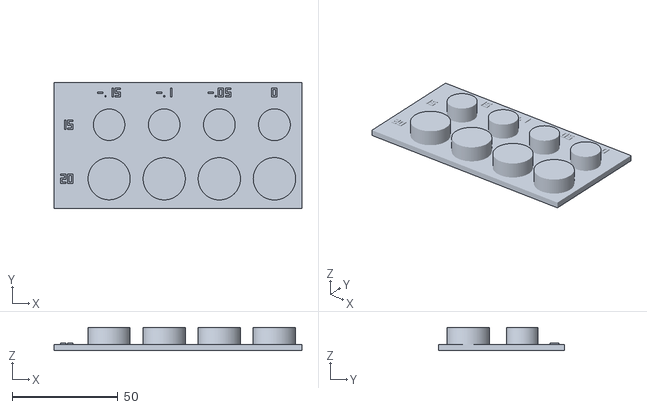
[picture p57: CAD file, 2026-10-28]
stl/coupons/pegs.stl
117.0 x 59.4 x 11.0
