JoshChomps/7_DOF_Arm/stl/da/DA_P7_Sliptube.stl

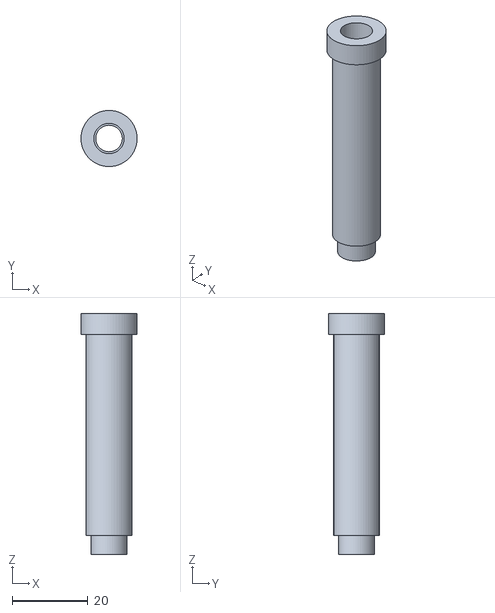
[picture p58: CAD file, 2026-10-28]
stl/da/DA_P7_Sliptube.stl
14.8 x 14.8 x 63.5
