JoshChomps/7_DOF_Arm/stl/j1/J1_carrier.stl

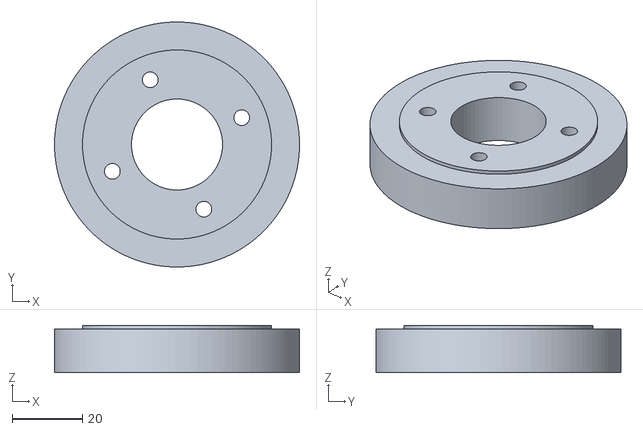
[picture p59: CAD file, 2026-10-28]
stl/j1/J1_carrier.stl
70.0 x 70.0 x 13.5
