JoshChomps/7_DOF_Arm/stl/plates/c2/plate_4.3mf

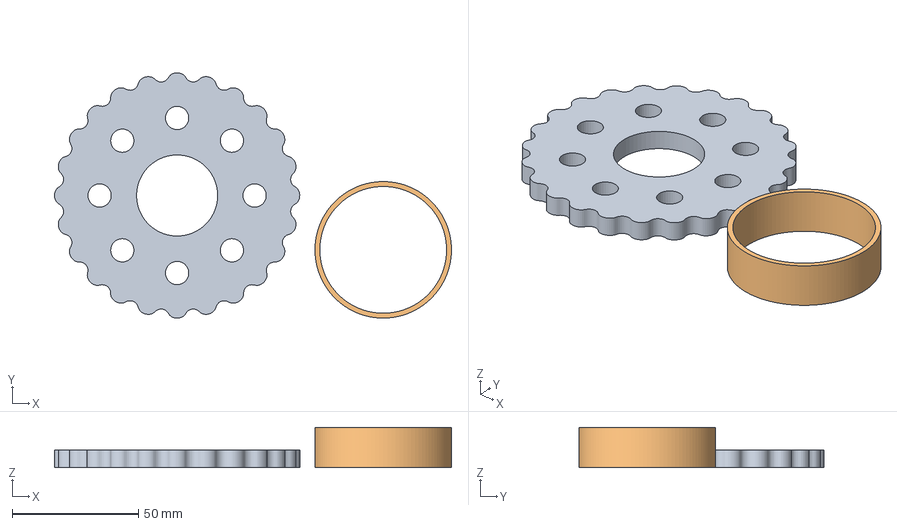
[picture p60: CAD file, 2026-10-28]
stl/plates/c2/plate_4.3mf
157.0 x 97.0 x 16.0 mm
DA_C2_Discb.stl
DA_C2_Spacers.stl
