JoshChomps/7_DOF_Arm/software/deskarm/data/meshes/5_printed.stl

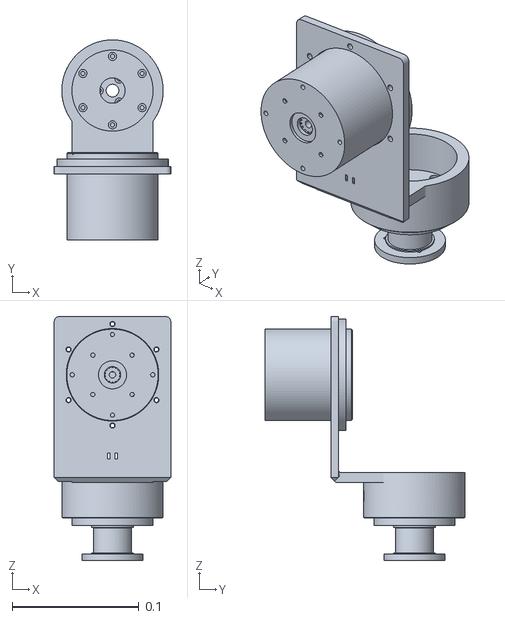
[picture p61: CAD file, 2026-10-28]
software/deskarm/data/meshes/5_printed.stl
0.092 x 0.158 x 0.192
