JoshChomps/7_DOF_Arm/stl/da/DA_L_Link6.stl

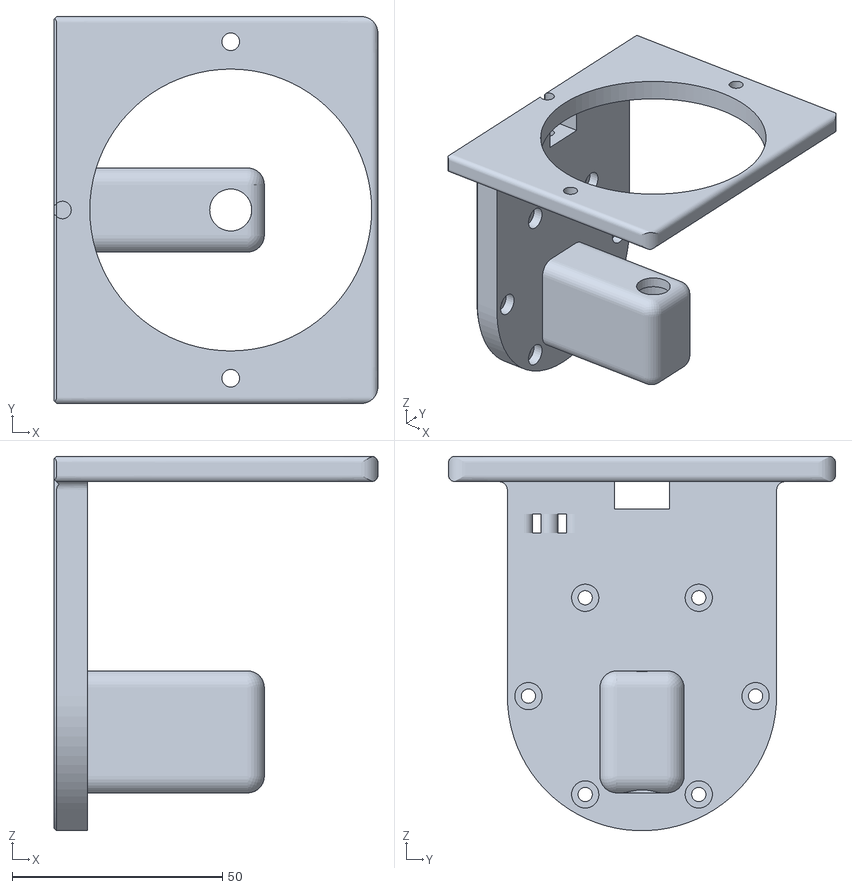
[picture p62: CAD file, 2026-10-28]
stl/da/DA_L_Link6.stl
77.0 x 92.0 x 89.0
