JoshChomps/7_DOF_Arm/software/deskarm/data/meshes/6_printed.stl

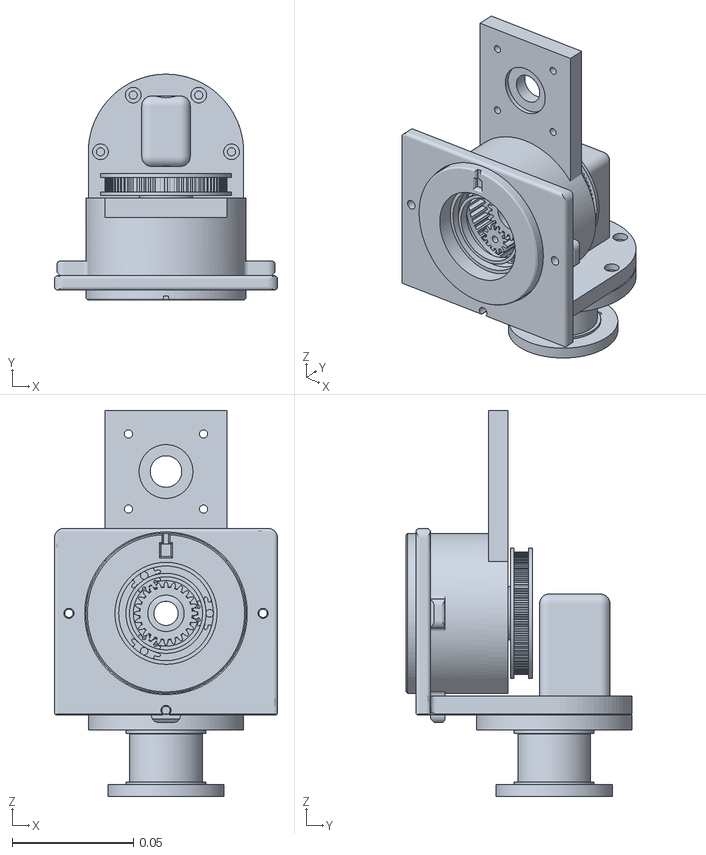
[picture p63: CAD file, 2026-10-28]
software/deskarm/data/meshes/6_printed.stl
0.092 x 0.093 x 0.159
