JoshChomps/7_DOF_Arm/stl/da/DA_C2_Flange.stl

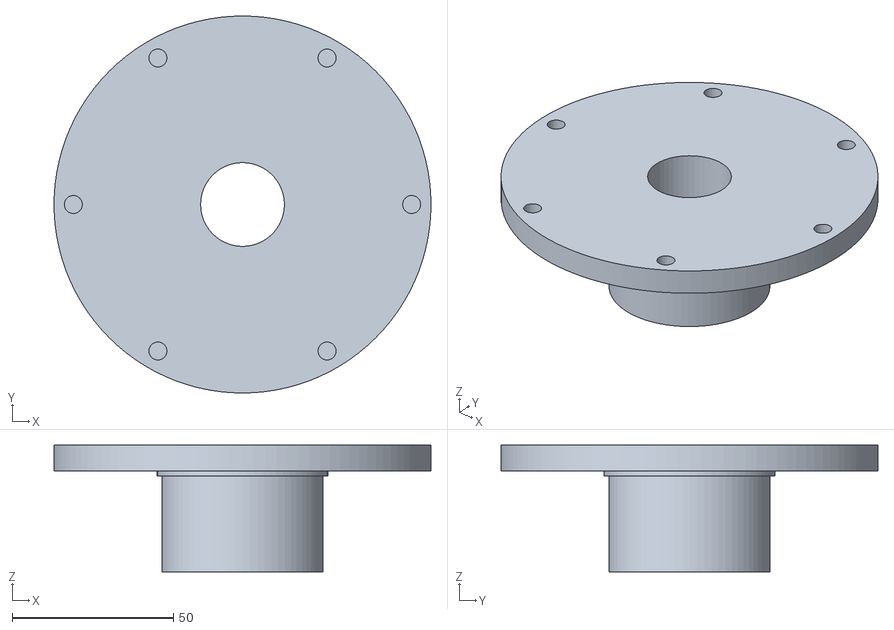
[picture p64: CAD file, 2026-10-28]
stl/da/DA_C2_Flange.stl
117.0 x 117.0 x 39.3
