JoshChomps/7_DOF_Arm/software/deskarm/data/meshes/0_motor.stl

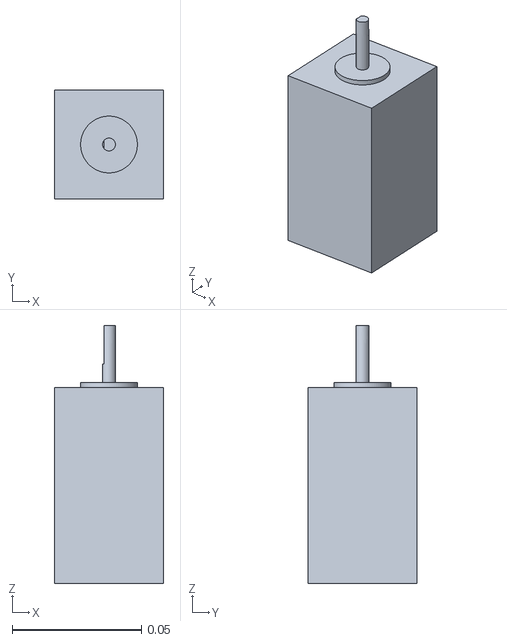
[picture p66: CAD file, 2026-10-28]
software/deskarm/data/meshes/0_motor.stl
0.0423 x 0.0423 x 0.1
