JoshChomps/7_DOF_Arm/stl/da/DA_C2_Enccap.stl

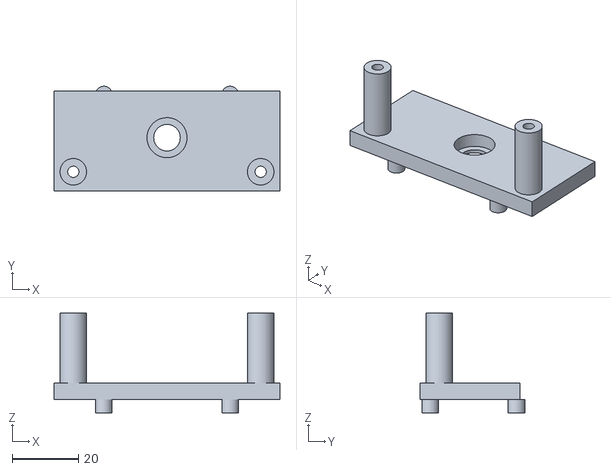
[picture p67: CAD file, 2026-10-28]
stl/da/DA_C2_Enccap.stl
68.0 x 31.5 x 30.0
