JoshChomps/7_DOF_Arm/software/deskarm/data/meshes/3_printed.stl

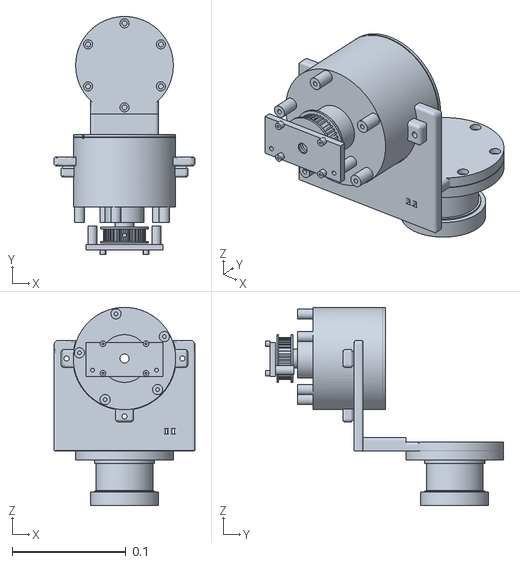
[picture p68: CAD file, 2026-10-28]
software/deskarm/data/meshes/3_printed.stl
0.124 x 0.21 x 0.174
