JoshChomps/7_DOF_Arm/stl/da/DA_P7_Planet.stl

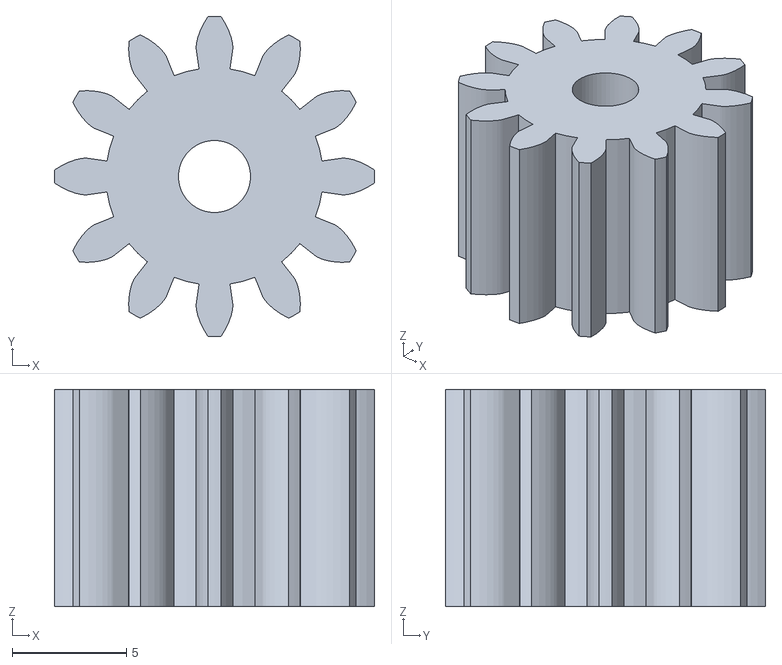
[picture p69: CAD file, 2026-10-28]
stl/da/DA_P7_Planet.stl
14.0 x 14.0 x 9.50
