JoshChomps/7_DOF_Arm/stl/da/DA_P7_Pulley80.stl

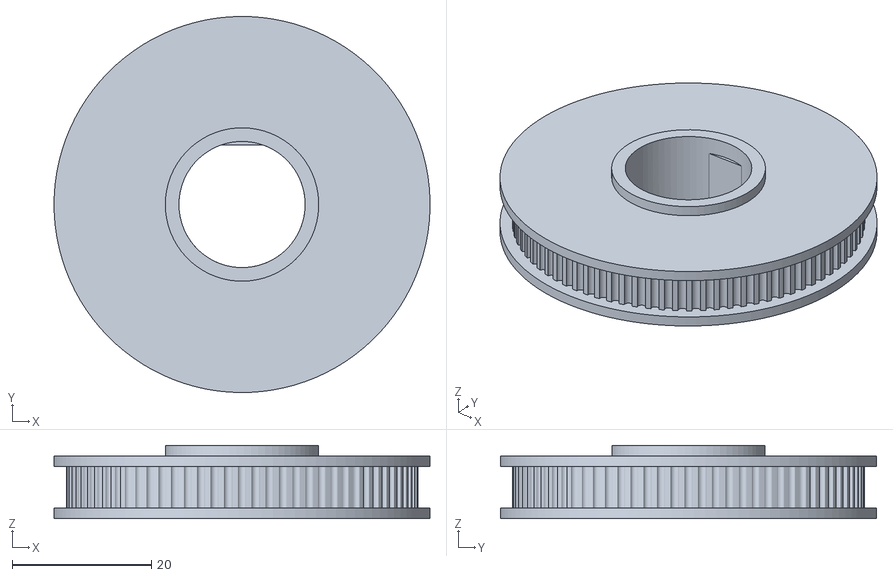
[picture p70: CAD file, 2026-10-28]
stl/da/DA_P7_Pulley80.stl
53.9 x 53.9 x 10.5
