JoshChomps/7_DOF_Arm/software/deskarm/data/meshes/2_belt.stl

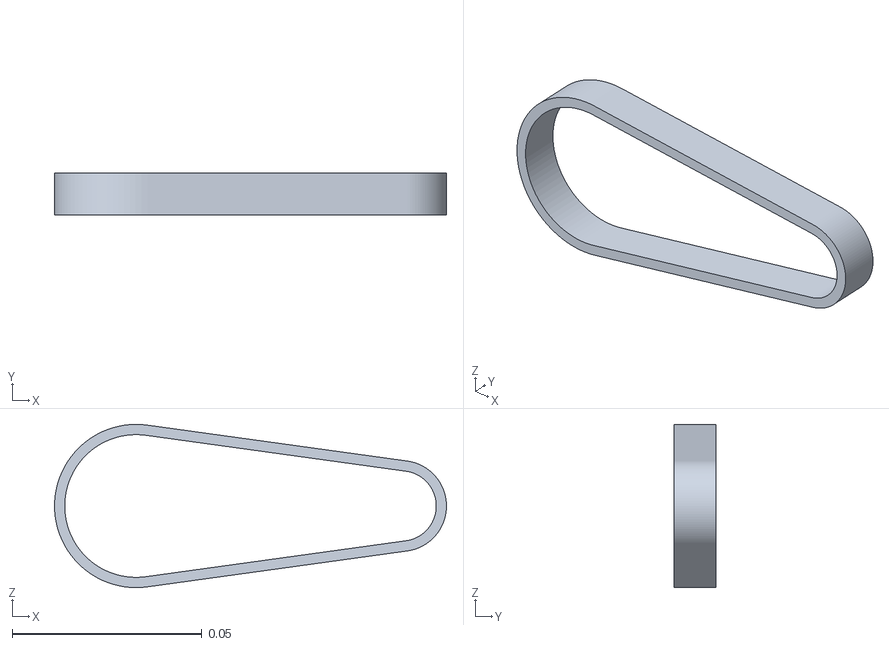
[picture p71: CAD file, 2026-10-28]
software/deskarm/data/meshes/2_belt.stl
0.103 x 0.011 x 0.043
