JoshChomps/7_DOF_Arm/software/deskarm/data/meshes/6_steel.stl

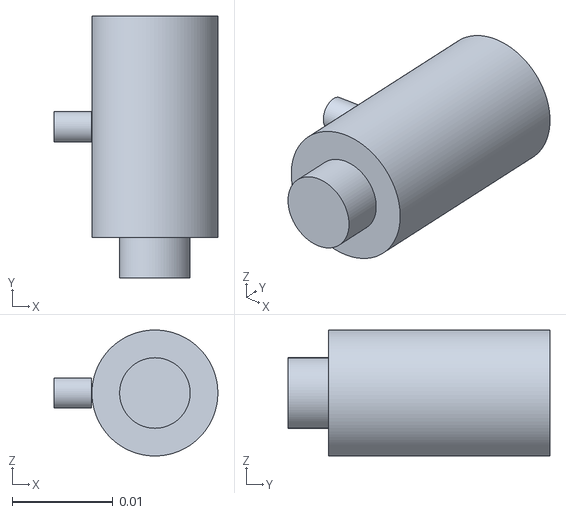
[picture p72: CAD file, 2026-10-28]
software/deskarm/data/meshes/6_steel.stl
0.0162 x 0.026 x 0.0125
