JoshChomps/7_DOF_Arm/stl/da/DA_C34_Carrier.stl

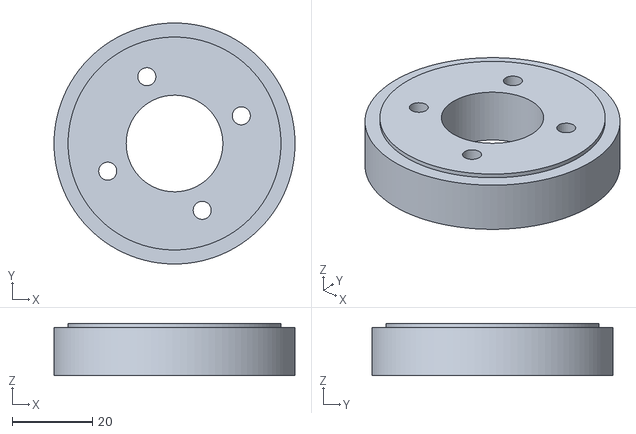
[picture p73: CAD file, 2026-10-28]
stl/da/DA_C34_Carrier.stl
60.0 x 60.0 x 13.0
