JoshChomps/7_DOF_Arm/software/deskarm/data/meshes/2_pcb.stl

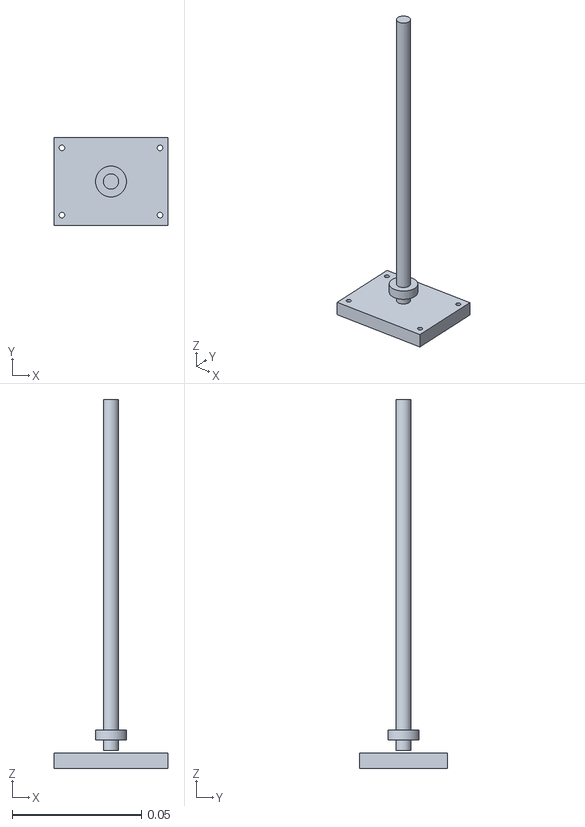
[picture p74: CAD file, 2026-10-28]
software/deskarm/data/meshes/2_pcb.stl
0.044 x 0.034 x 0.143
