JoshChomps/7_DOF_Arm/stl/da/DA_C34_Housing.stl

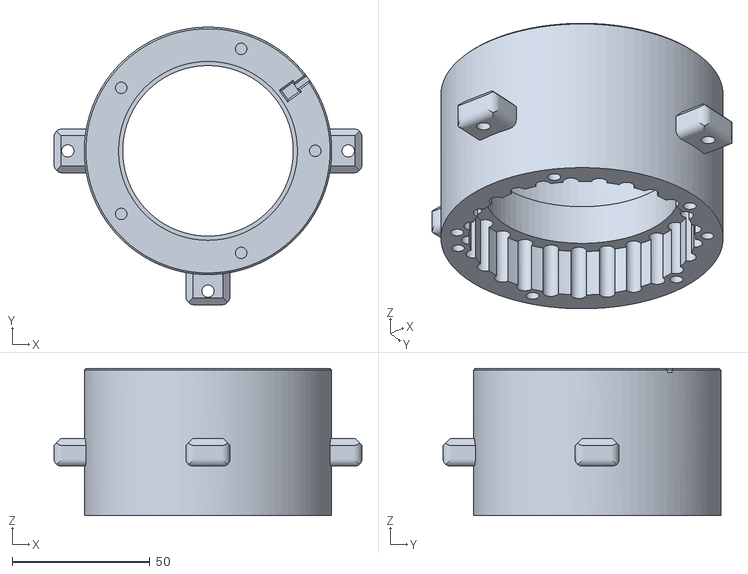
[picture p75: CAD file, 2026-10-28]
stl/da/DA_C34_Housing.stl
112.0 x 101.0 x 53.5
