JoshChomps/7_DOF_Arm/software/deskarm/data/meshes/1_metal.stl

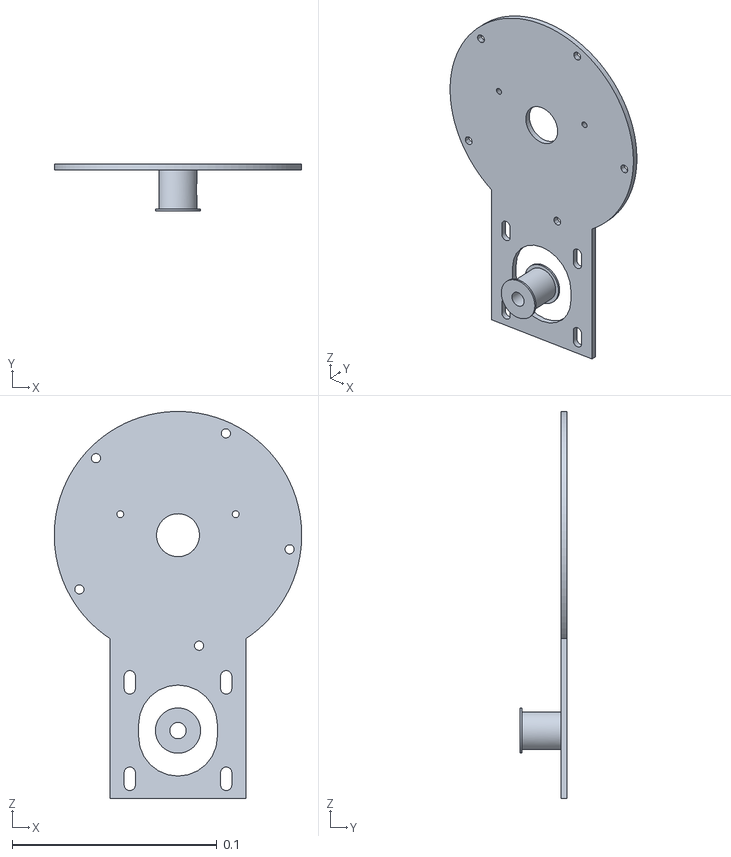
[picture p76: CAD file, 2026-10-28]
software/deskarm/data/meshes/1_metal.stl
0.121 x 0.023 x 0.189
