JoshChomps/7_DOF_Arm/stl/da/DA_C34_Cover.stl

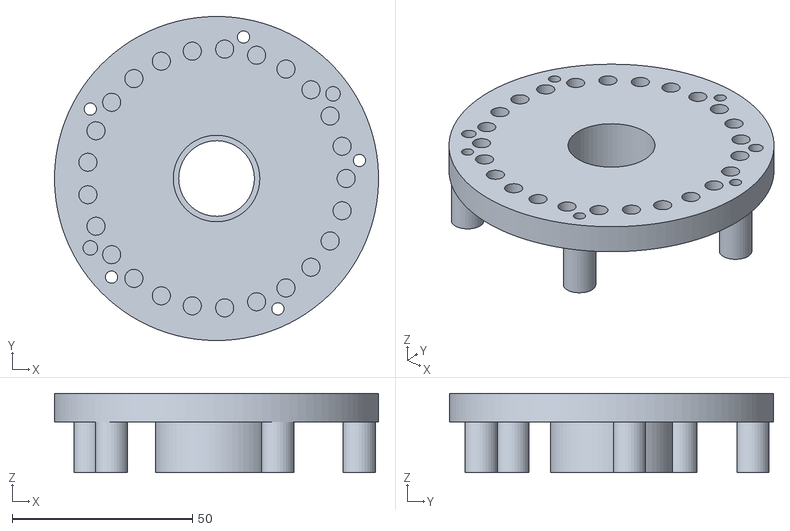
[picture p77: CAD file, 2026-10-28]
stl/da/DA_C34_Cover.stl
90.0 x 90.0 x 22.0
