JoshChomps/7_DOF_Arm/stl/da/DA_T_Receiver.stl

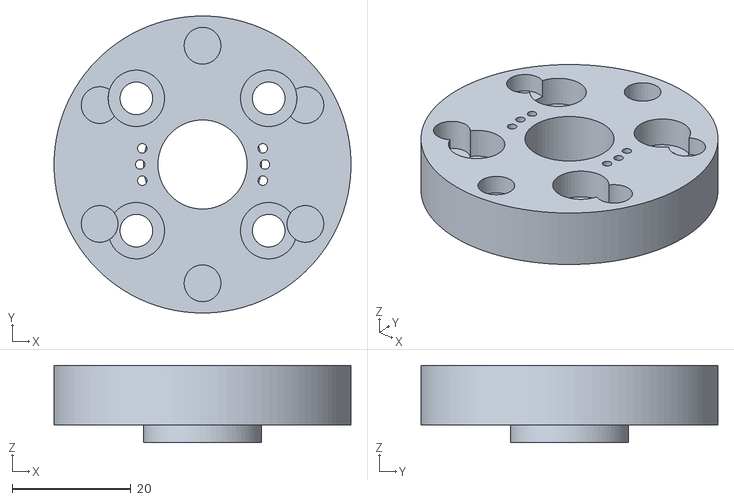
[picture p78: CAD file, 2026-10-28]
stl/da/DA_T_Receiver.stl
50.0 x 50.0 x 13.0
