JoshChomps/7_DOF_Arm/software/deskarm/data/meshes/6_belt.stl

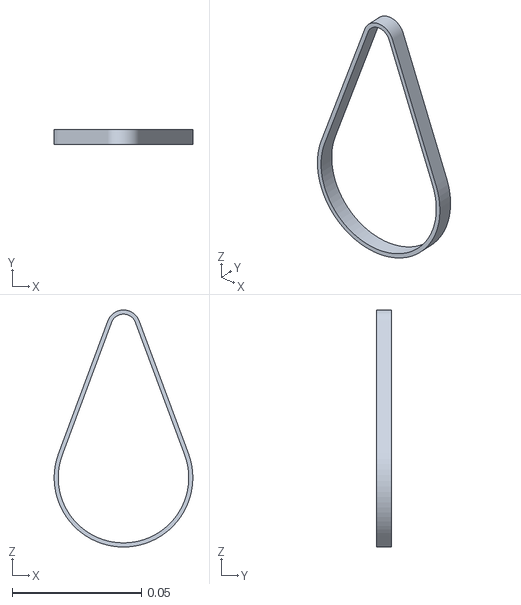
[picture p79: CAD file, 2026-10-28]
software/deskarm/data/meshes/6_belt.stl
0.0537 x 0.006 x 0.0918
