JoshChomps/7_DOF_Arm/stl/da/DA_P7_Sunshaft.stl

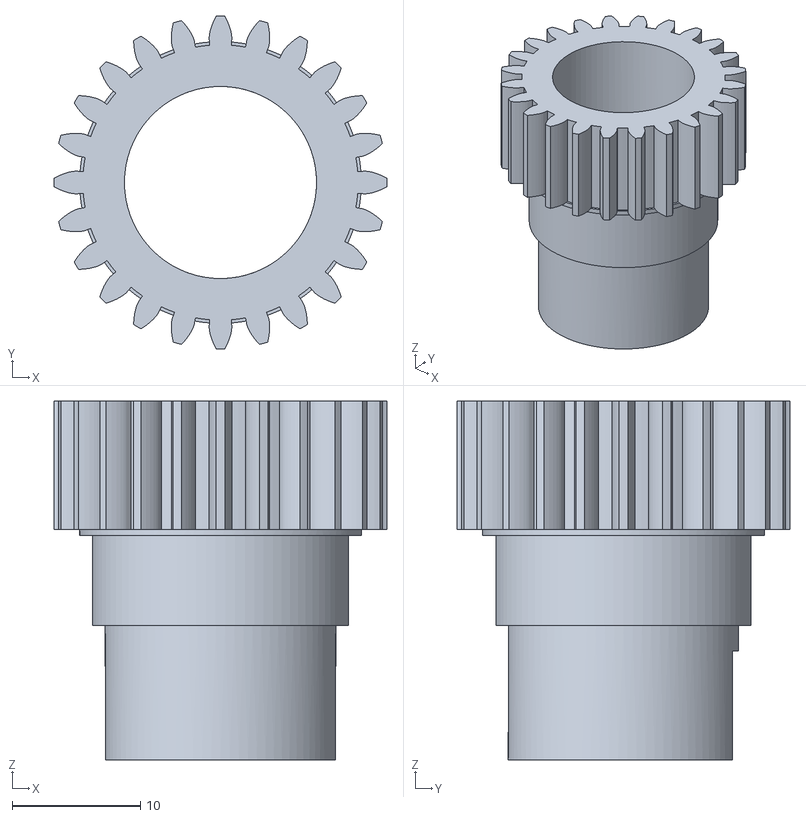
[picture p80: CAD file, 2026-10-28]
stl/da/DA_P7_Sunshaft.stl
26.0 x 26.0 x 28.0
