JoshChomps/7_DOF_Arm/software/deskarm/data/meshes/7_tpu.stl

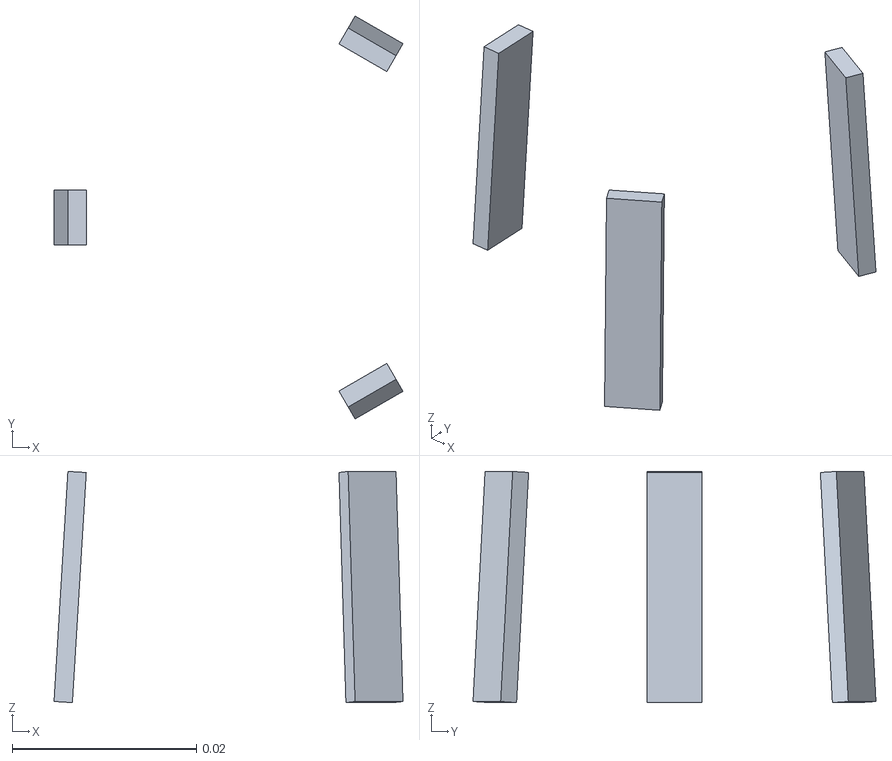
[picture p81: CAD file, 2026-10-28]
software/deskarm/data/meshes/7_tpu.stl
0.0379 x 0.0437 x 0.0251
