JoshChomps/7_DOF_Arm/stl/da/DA_C34_Enccap.stl

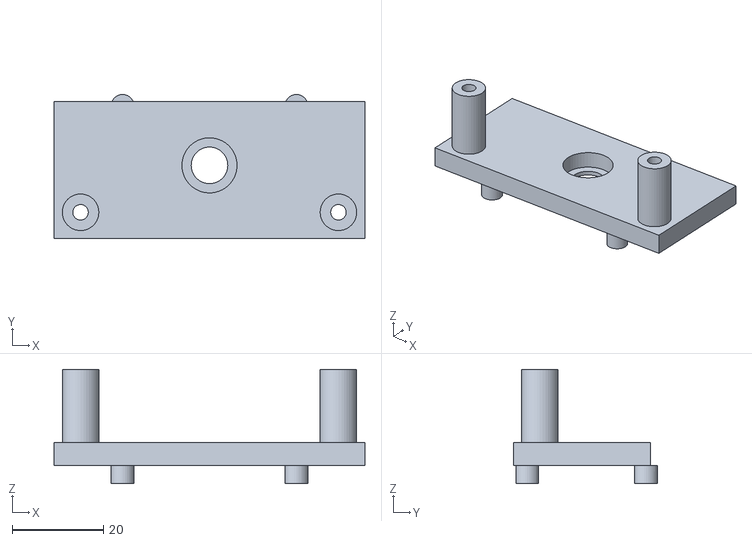
[picture p82: CAD file, 2026-10-28]
stl/da/DA_C34_Enccap.stl
68.0 x 31.5 x 25.0
