JoshChomps/7_DOF_Arm/stl/da/DA_G_Fingers.stl

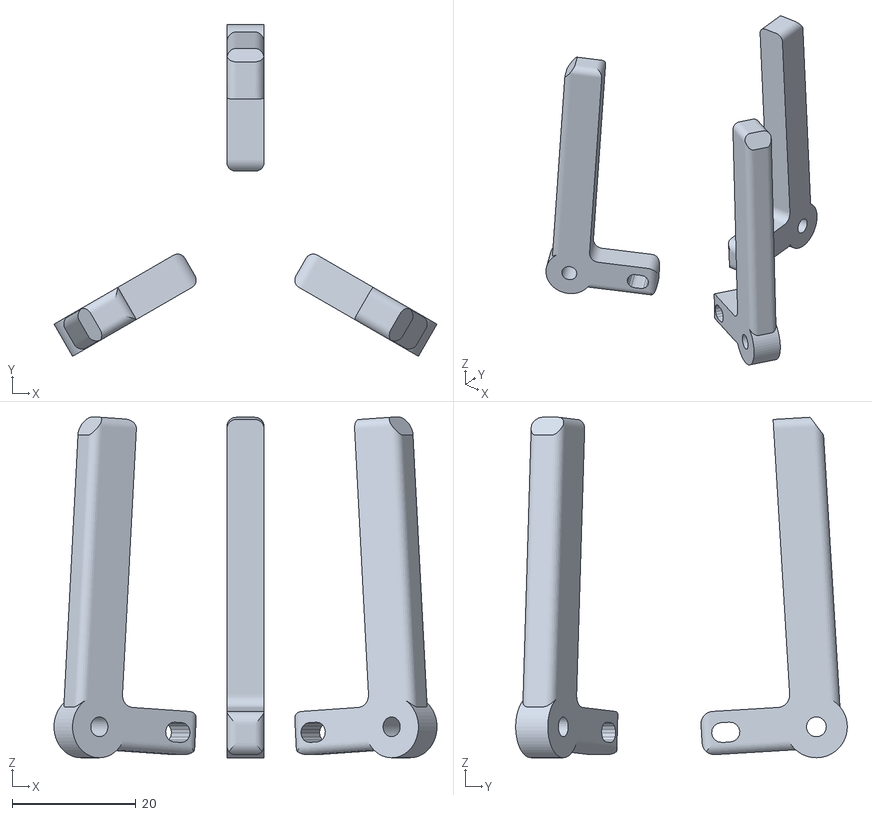
[picture p83: CAD file, 2026-10-28]
stl/da/DA_G_Fingers.stl
61.9 x 53.6 x 55.0
