JoshChomps/7_DOF_Arm/software/deskarm/data/meshes/7_printed.stl

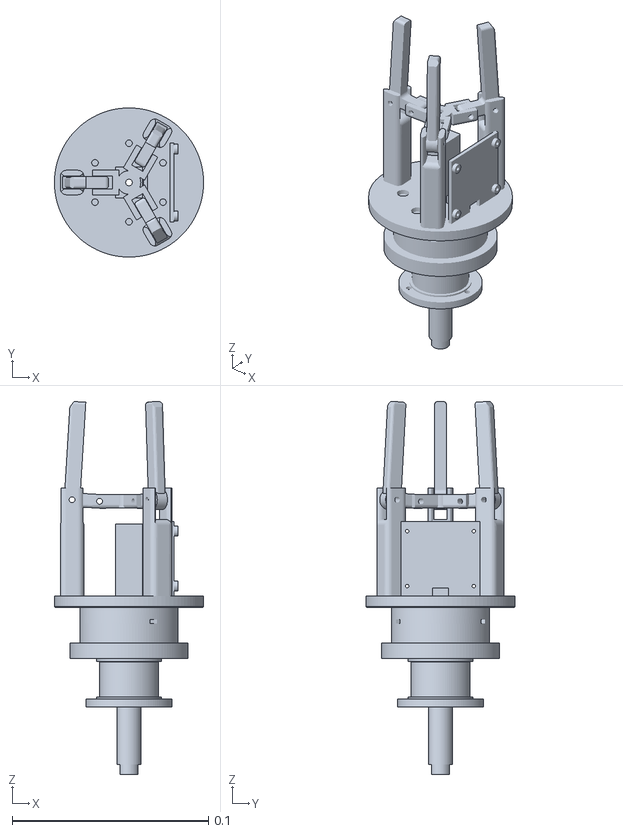
[picture p84: CAD file, 2026-10-28]
software/deskarm/data/meshes/7_printed.stl
0.076 x 0.076 x 0.19
