JoshChomps/7_DOF_Arm/software/deskarm/data/meshes/6_metal.stl

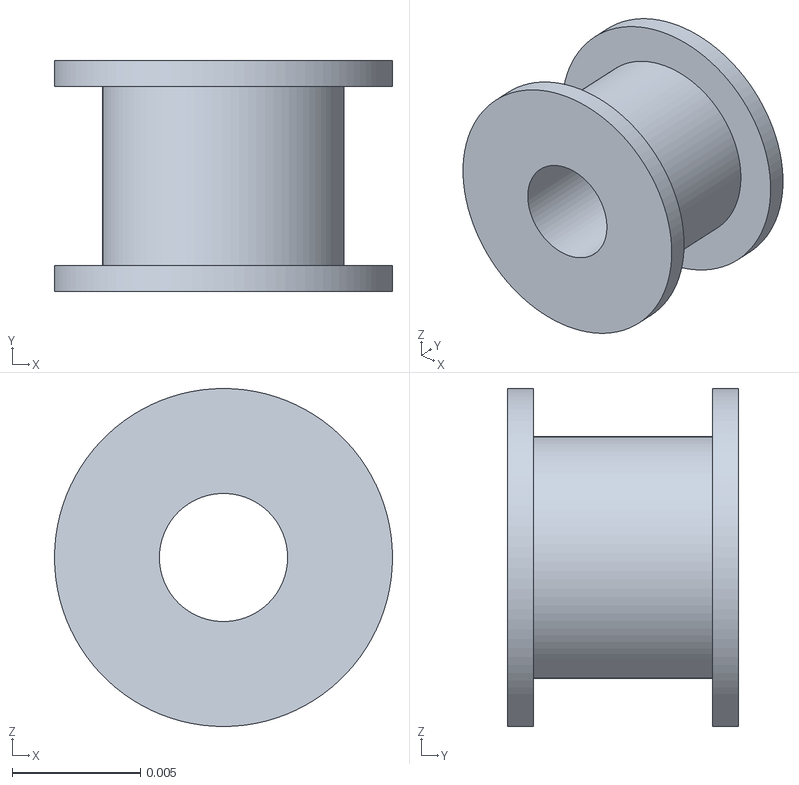
[picture p87: CAD file, 2026-10-28]
software/deskarm/data/meshes/6_metal.stl
0.0132 x 0.009 x 0.0132
