JoshChomps/7_DOF_Arm/stl/da/DA_L_StandLeft.stl

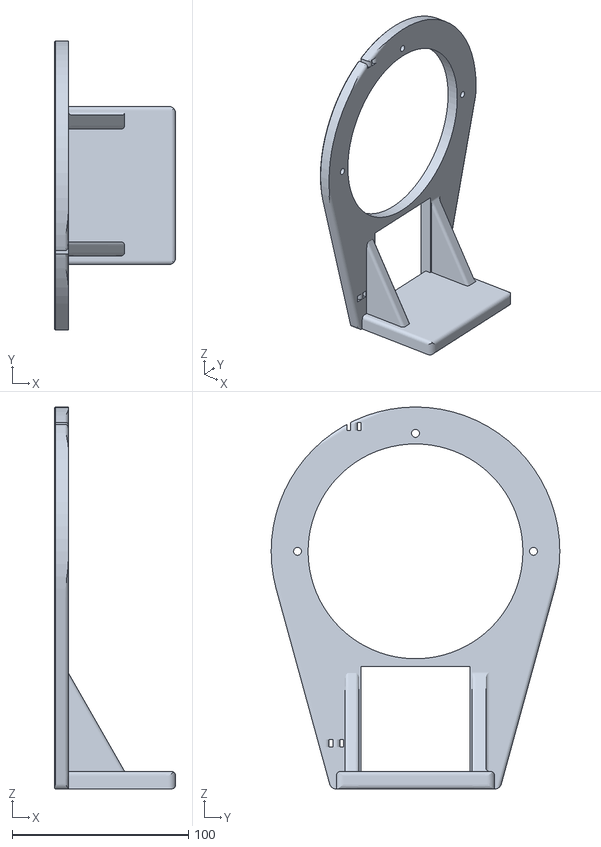
[picture p88: CAD file, 2026-10-28]
stl/da/DA_L_StandLeft.stl
69.0 x 164.0 x 217.0
