JoshChomps/7_DOF_Arm/software/deskarm/data/meshes/0_printed.stl

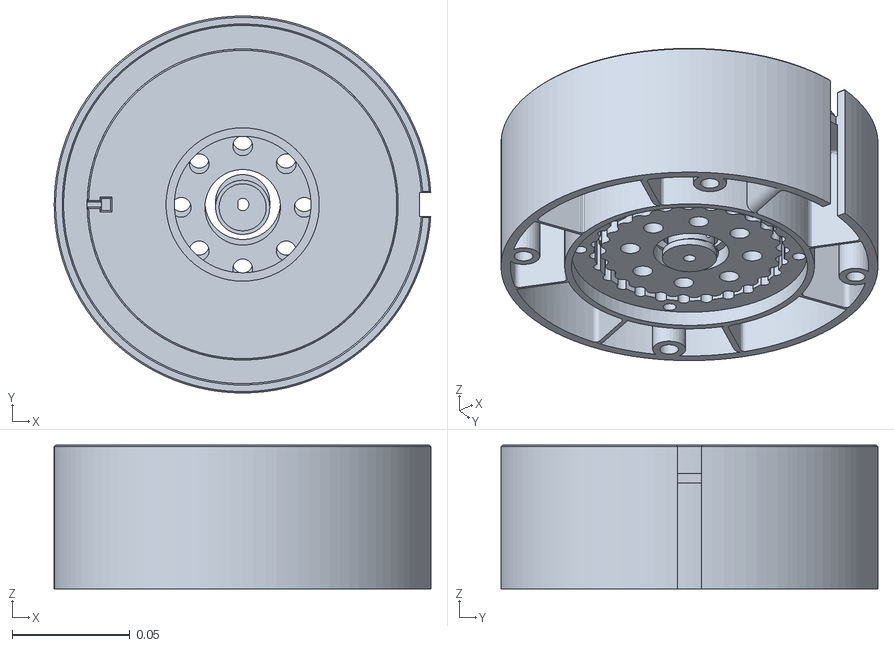
[picture p89: CAD file, 2026-10-28]
software/deskarm/data/meshes/0_printed.stl
0.16 x 0.16 x 0.061
