JoshChomps/7_DOF_Arm/stl/da/DA_L_Link2.stl

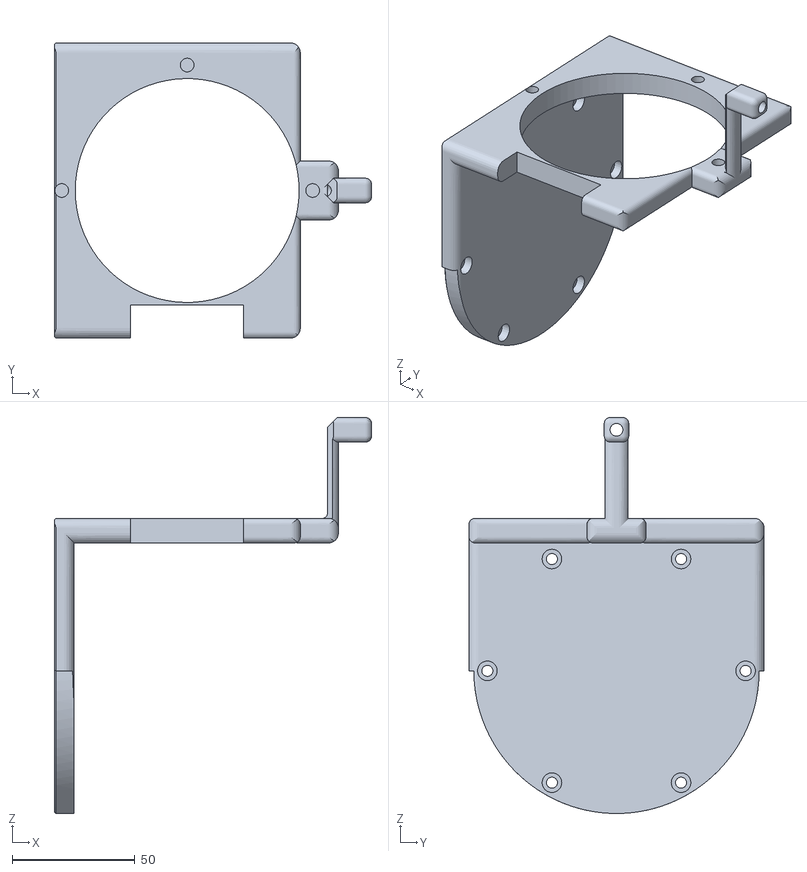
[picture p90: CAD file, 2026-10-28]
stl/da/DA_L_Link2.stl
129.0 x 120.0 x 161.0
