JoshChomps/7_DOF_Arm/software/deskarm/data/meshes/1_printed.stl

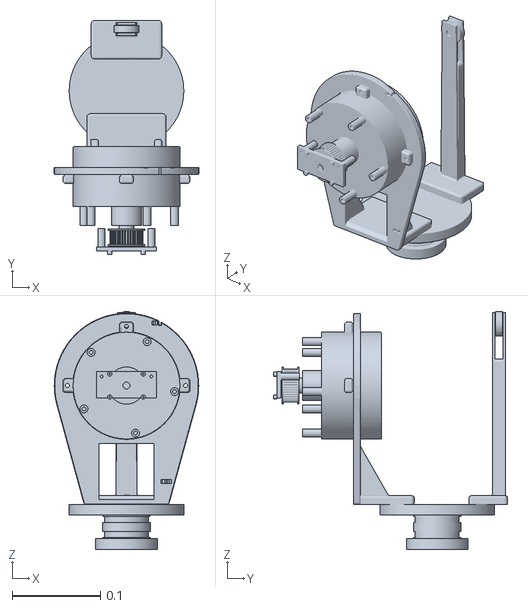
[picture p91: CAD file, 2026-10-28]
software/deskarm/data/meshes/1_printed.stl
0.164 x 0.266 x 0.27
