JoshChomps/7_DOF_Arm/stl/da/DA_C2_Shaft.stl

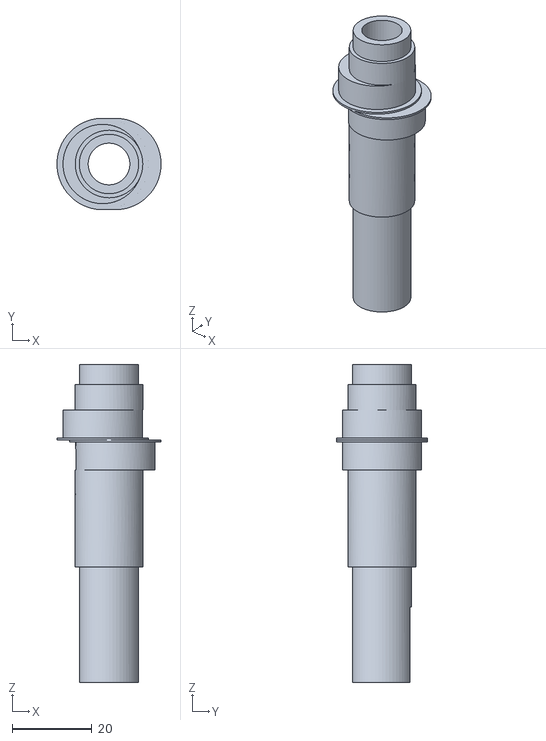
[picture p92: CAD file, 2026-10-28]
stl/da/DA_C2_Shaft.stl
26.2 x 23.0 x 80.0
