JoshChomps/7_DOF_Arm/stl/da/DA_P56_Carrier1.stl

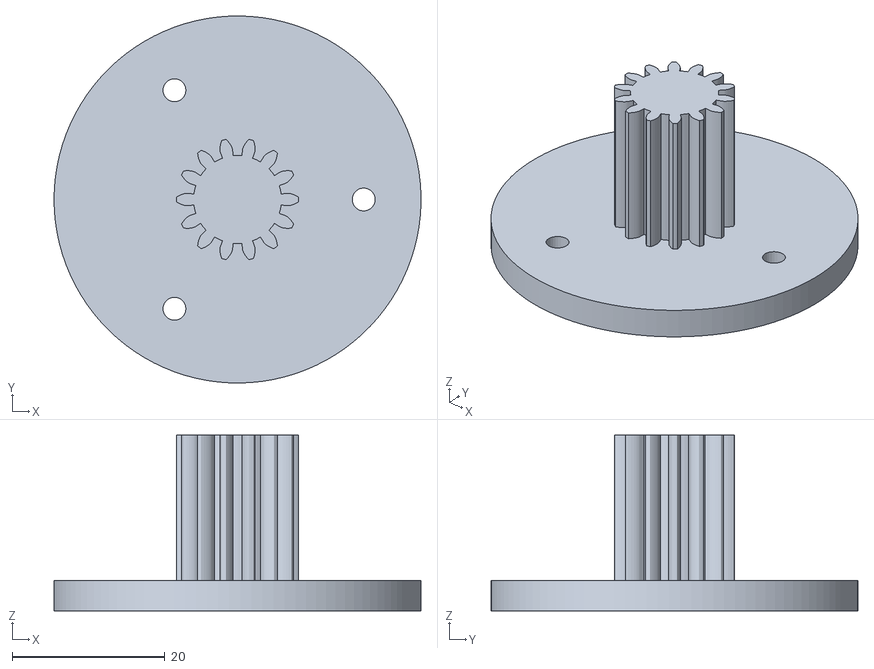
[picture p93: CAD file, 2026-10-28]
stl/da/DA_P56_Carrier1.stl
48.0 x 48.0 x 23.0
