JoshChomps/7_DOF_Arm/software/deskarm/data/meshes/7_steel.stl

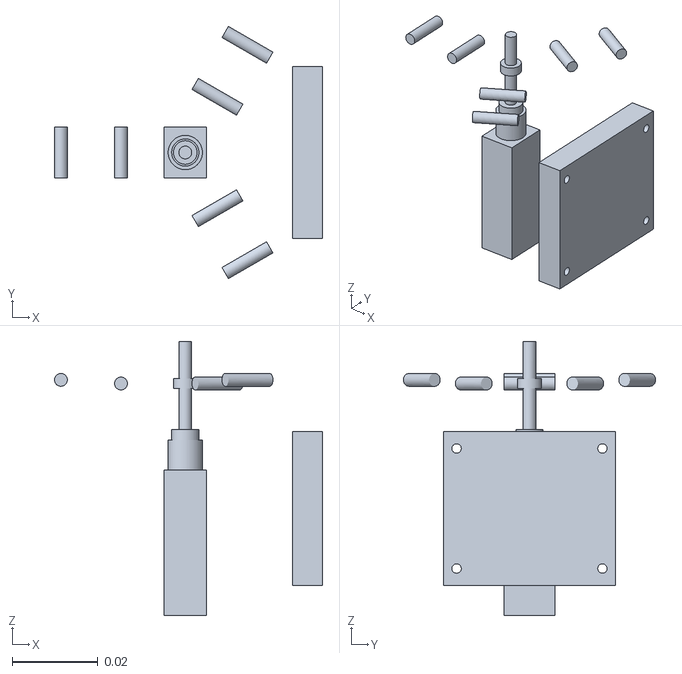
[picture p94: CAD file, 2026-10-28]
software/deskarm/data/meshes/7_steel.stl
0.0625 x 0.0588 x 0.064
