JoshChomps/7_DOF_Arm/stl/da/DA_P7_Base.stl

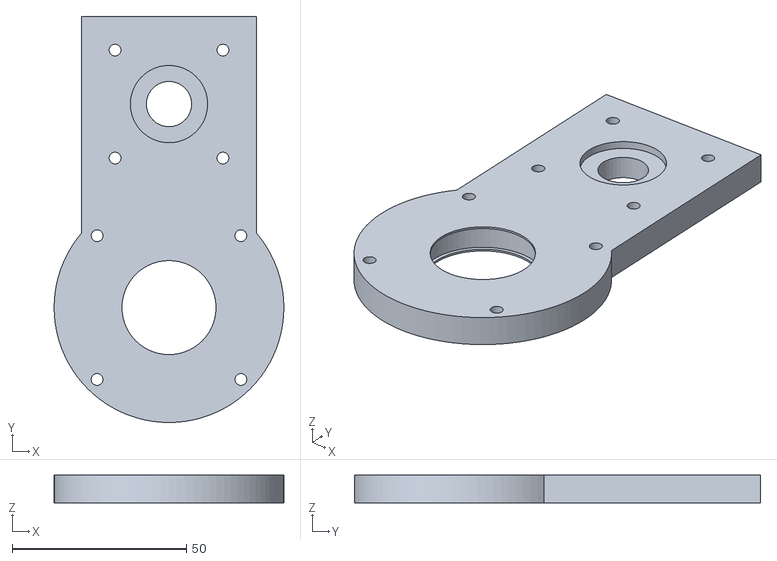
[picture p95: CAD file, 2026-10-28]
stl/da/DA_P7_Base.stl
66.0 x 116.6 x 8.00
