JoshChomps/7_DOF_Arm/stl/da/DA_L_Forearm.stl

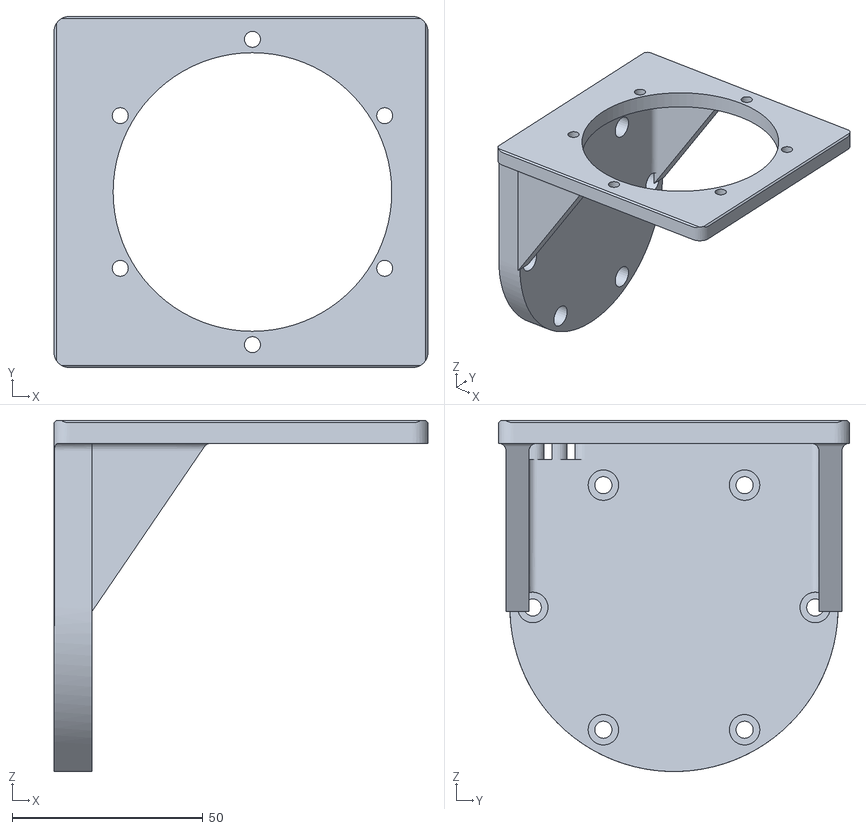
[picture p96: CAD file, 2026-10-28]
stl/da/DA_L_Forearm.stl
98.0 x 92.0 x 92.0
