JoshChomps/7_DOF_Arm/software/deskarm/data/meshes/0_metal.stl

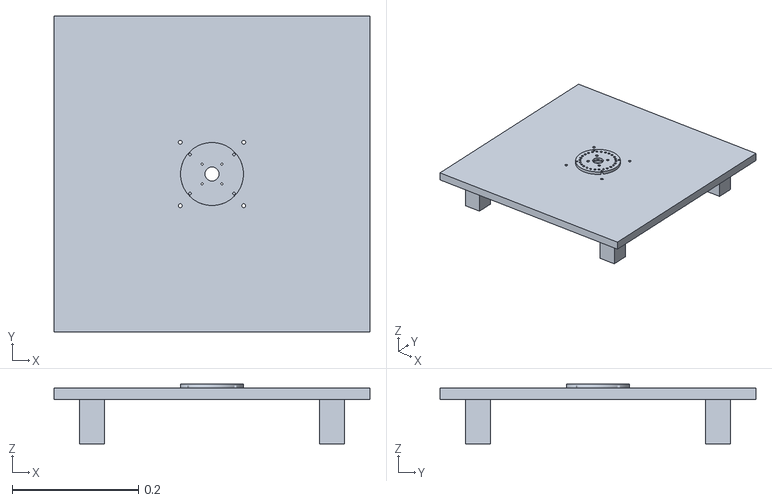
[picture p97: CAD file, 2026-10-28]
software/deskarm/data/meshes/0_metal.stl
0.5 x 0.5 x 0.0945
