JoshChomps/7_DOF_Arm/stl/da/DA_C2_Spacers.stl

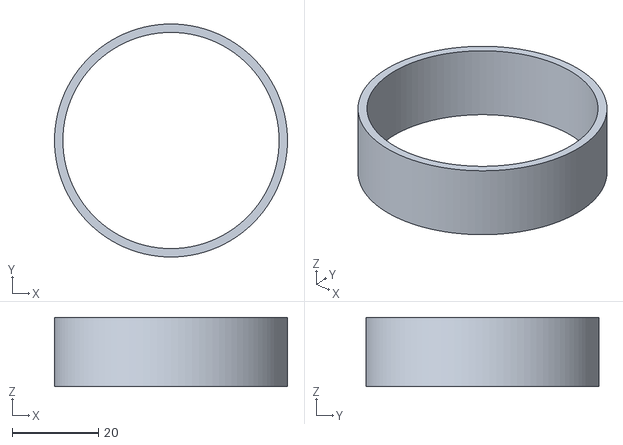
[picture p98: CAD file, 2026-10-28]
stl/da/DA_C2_Spacers.stl
54.0 x 54.0 x 16.0
