JoshChomps/7_DOF_Arm/software/deskarm/data/meshes/6_motor.stl

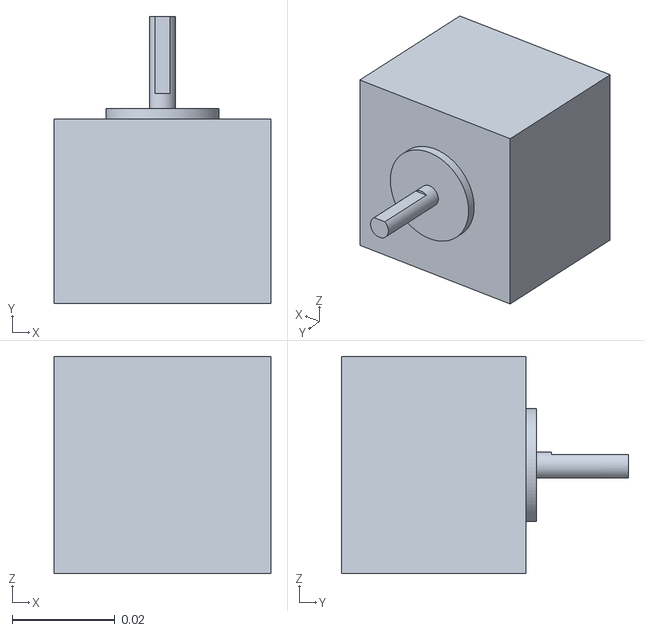
[picture p99: CAD file, 2026-10-28]
software/deskarm/data/meshes/6_motor.stl
0.0423 x 0.056 x 0.0423
