JoshChomps/7_DOF_Arm/stl/da/DA_C2_Housing.stl

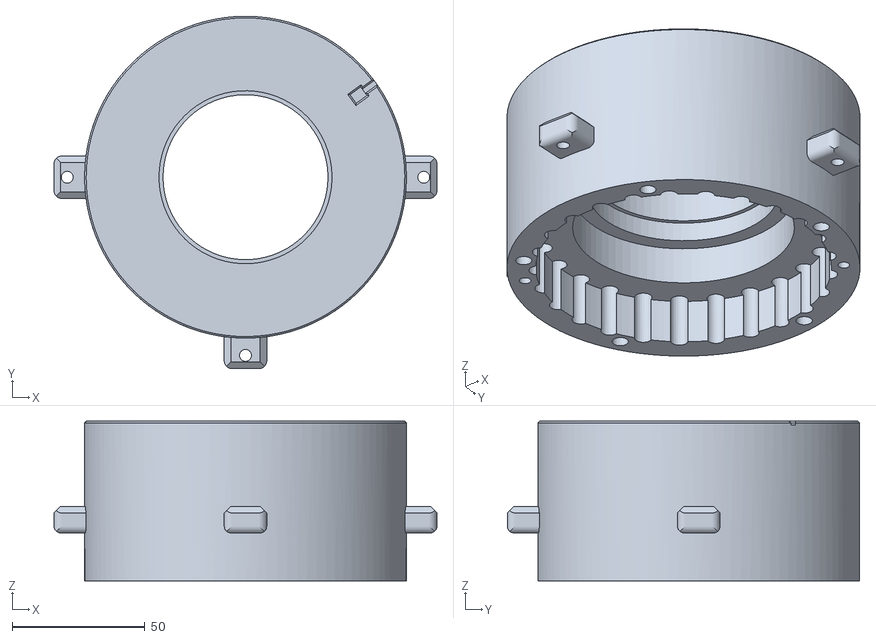
[picture p100: CAD file, 2026-10-28]
stl/da/DA_C2_Housing.stl
144.0 x 132.5 x 60.0
