JoshChomps/7_DOF_Arm/stl/da/DA_P56_Base.stl

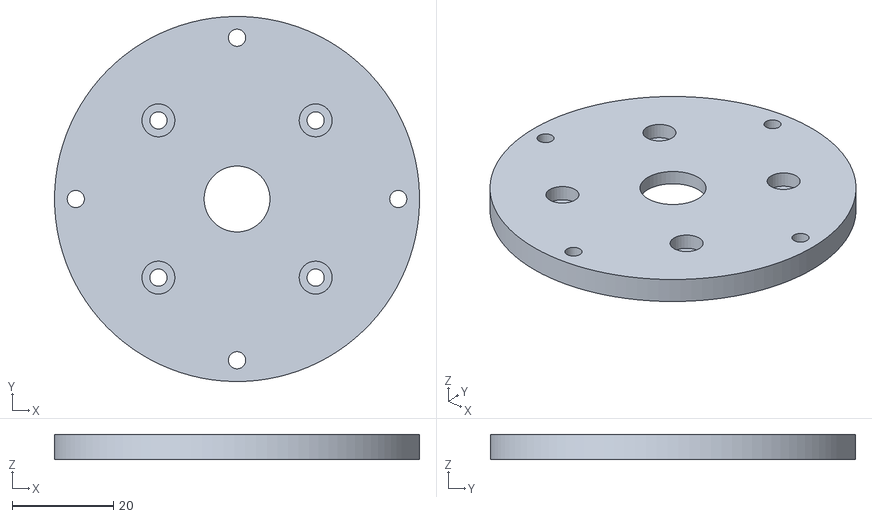
[picture p101: CAD file, 2026-10-28]
stl/da/DA_P56_Base.stl
72.0 x 72.0 x 5.00
