JoshChomps/7_DOF_Arm/stl/da/DA_C2_Cover.stl

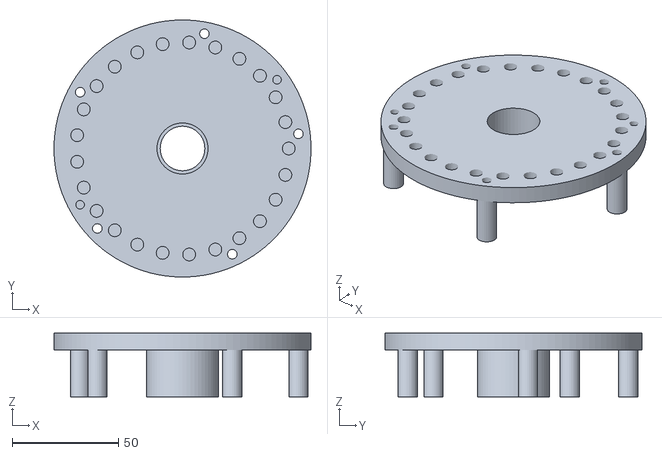
[picture p102: CAD file, 2026-10-28]
stl/da/DA_C2_Cover.stl
121.0 x 121.0 x 30.0
