JoshChomps/7_DOF_Arm/stl/da/DA_C34_Pulley40.stl

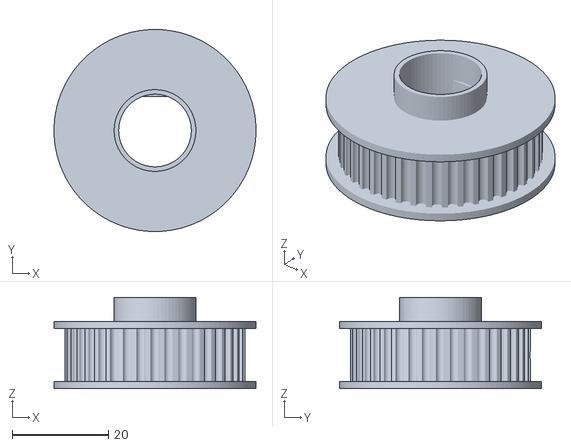
[picture p103: CAD file, 2026-10-28]
stl/da/DA_C34_Pulley40.stl
42.0 x 42.0 x 19.0
