JoshChomps/7_DOF_Arm/stl/da/DA_P56_Planet1.stl

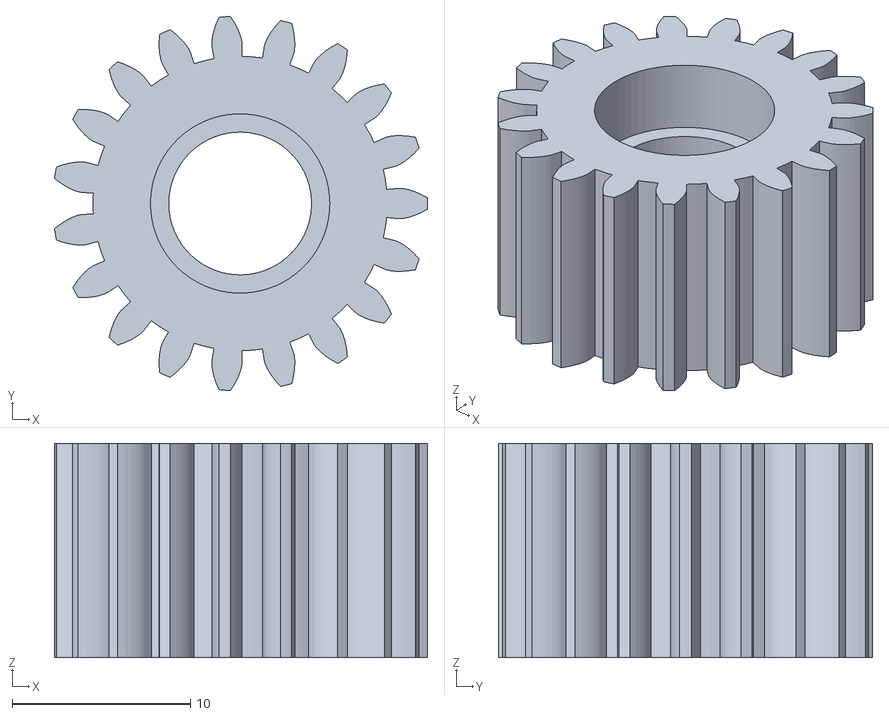
[picture p104: CAD file, 2026-10-28]
stl/da/DA_P56_Planet1.stl
20.9 x 21.0 x 12.0
