JoshChomps/7_DOF_Arm/stl/da/DA_P56_Sun1.stl

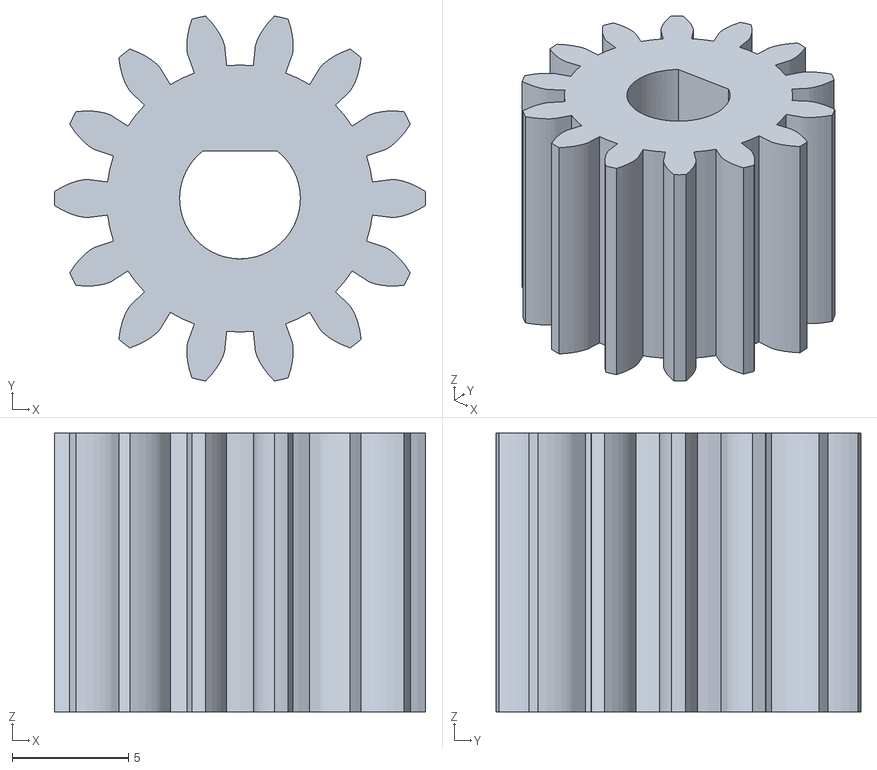
[picture p105: CAD file, 2026-10-28]
stl/da/DA_P56_Sun1.stl
16.0 x 15.7 x 12.0
