JoshChomps/7_DOF_Arm/stl/da/DA_C34_Shaft.stl

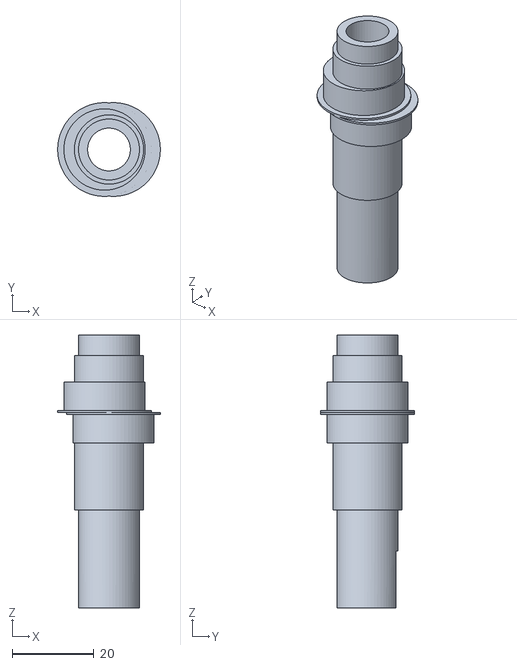
[picture p106: CAD file, 2026-10-28]
stl/da/DA_C34_Shaft.stl
25.2 x 23.0 x 67.0
