JoshChomps/7_DOF_Arm/stl/da/DA_G_Carrier.stl

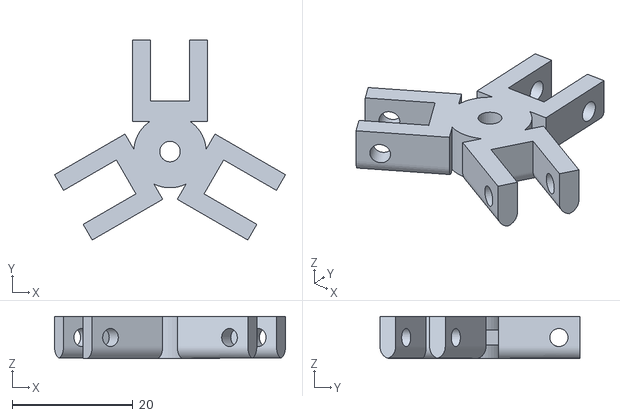
[picture p107: CAD file, 2026-10-28]
stl/da/DA_G_Carrier.stl
38.3 x 33.2 x 7.00
