JoshChomps/7_DOF_Arm/stl/da/DA_T_ToolPlate.stl

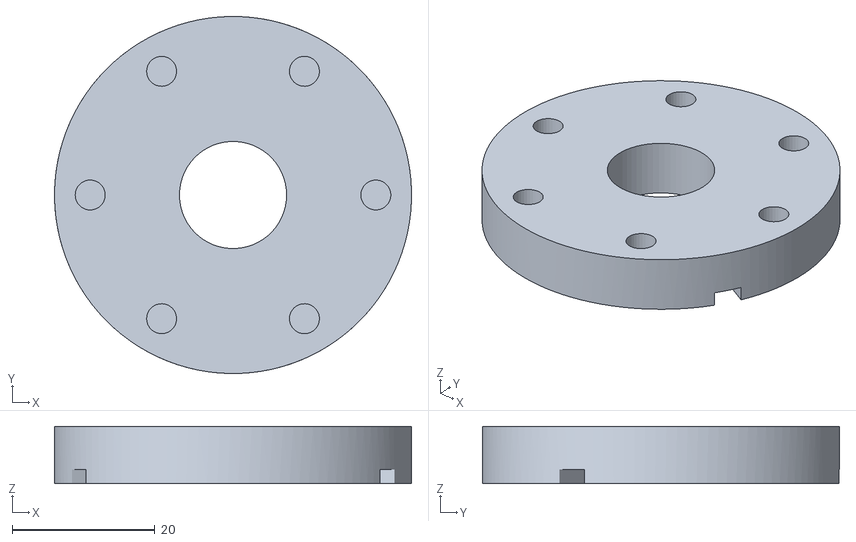
[picture p109: CAD file, 2026-10-28]
stl/da/DA_T_ToolPlate.stl
50.0 x 50.0 x 8.00
