JoshChomps/7_DOF_Arm/stl/da/DA_L_Link5.stl

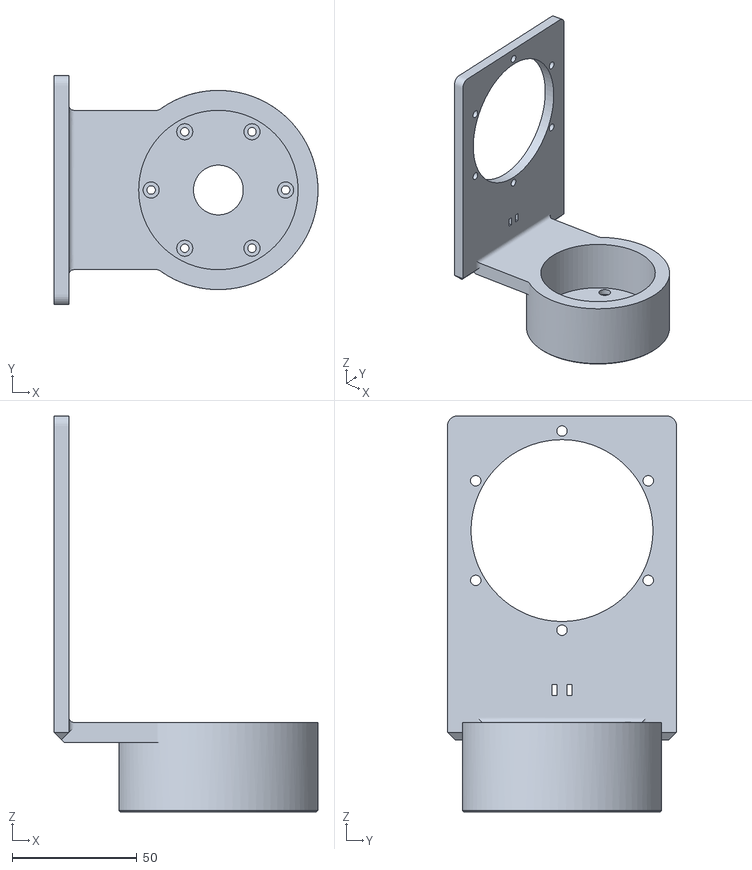
[picture p110: CAD file, 2026-10-28]
stl/da/DA_L_Link5.stl
106.0 x 92.0 x 159.0
