JoshChomps/7_DOF_Arm/stl/da/DA_G_Body.stl

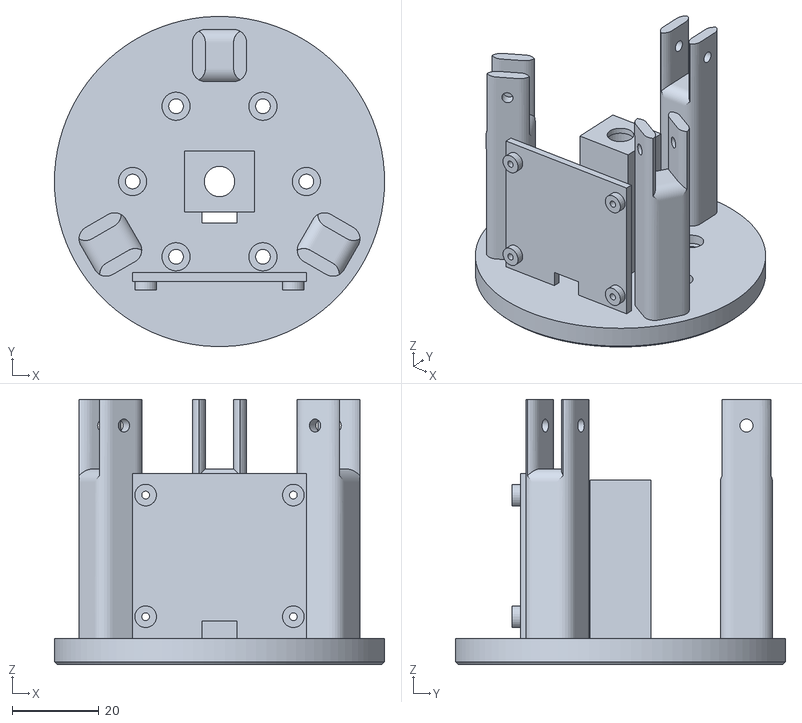
[picture p111: CAD file, 2026-10-28]
stl/da/DA_G_Body.stl
76.0 x 76.0 x 61.0
