JoshChomps/7_DOF_Arm/stl/da/DA_P56_Spacer.stl

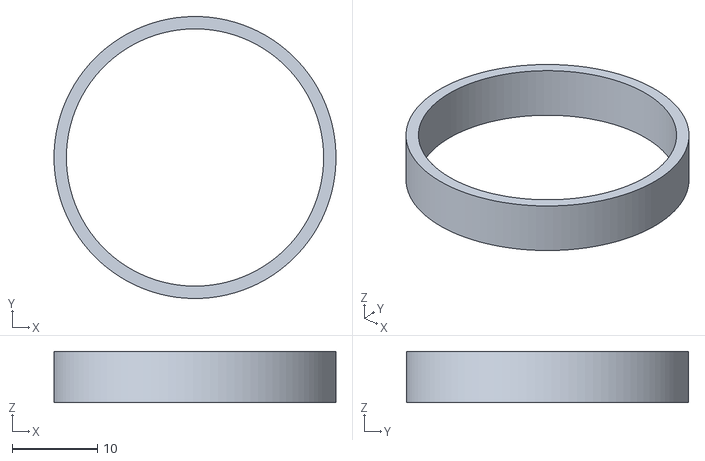
[picture p112: CAD file, 2026-10-28]
stl/da/DA_P56_Spacer.stl
33.0 x 33.0 x 6.00
