JoshChomps/7_DOF_Arm/stl/da/DA_C34_Discb.stl

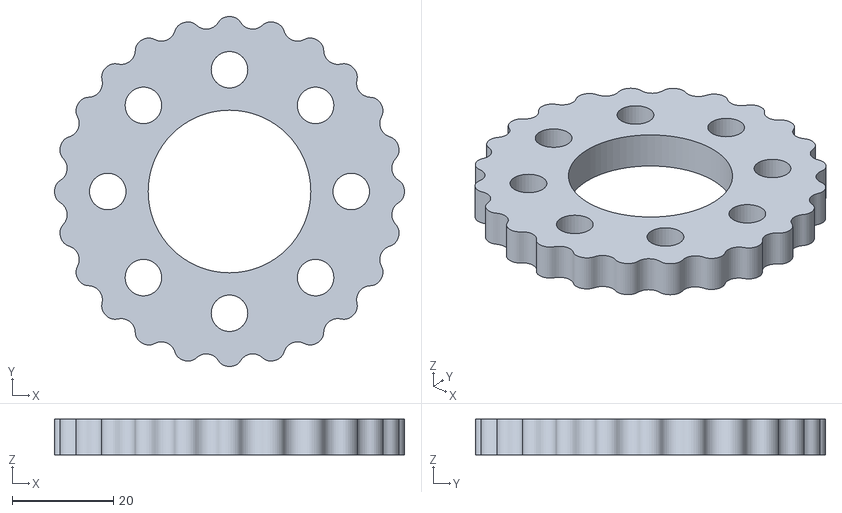
[picture p113: CAD file, 2026-10-28]
stl/da/DA_C34_Discb.stl
69.0 x 69.0 x 7.00
