JoshChomps/7_DOF_Arm/stl/da/DA_L_Link3.stl

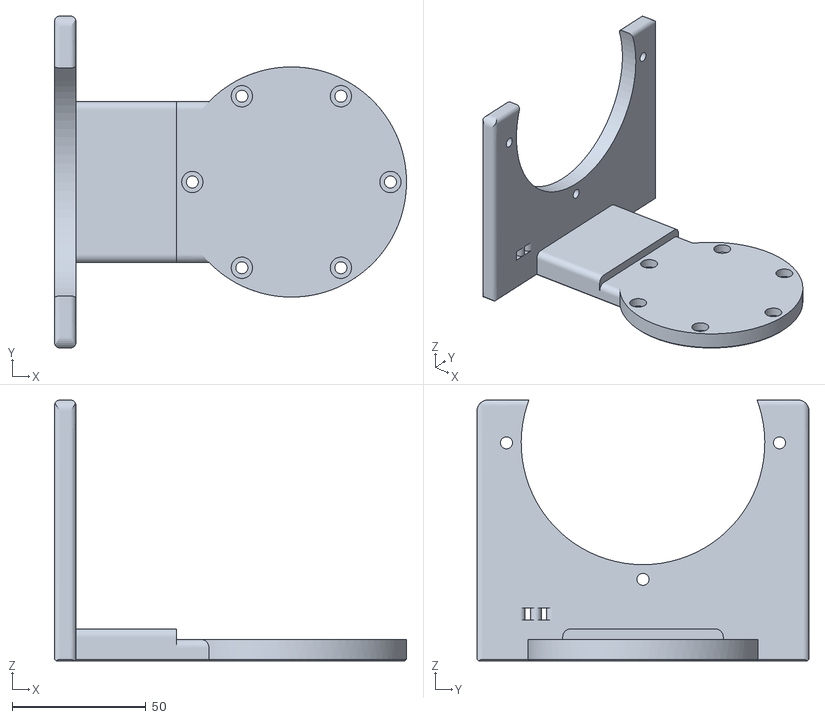
[picture p114: CAD file, 2026-10-28]
stl/da/DA_L_Link3.stl
131.5 x 124.0 x 97.5
