JoshChomps/7_DOF_Arm/stl/da/DA_C34_Spacers.stl

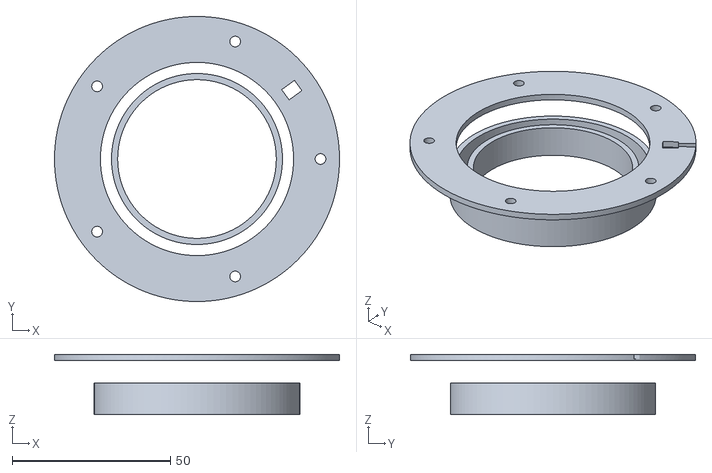
[picture p115: CAD file, 2026-10-28]
stl/da/DA_C34_Spacers.stl
90.0 x 90.0 x 19.0
