JoshChomps/7_DOF_Arm/stl/da/DA_L_CBPulley.stl

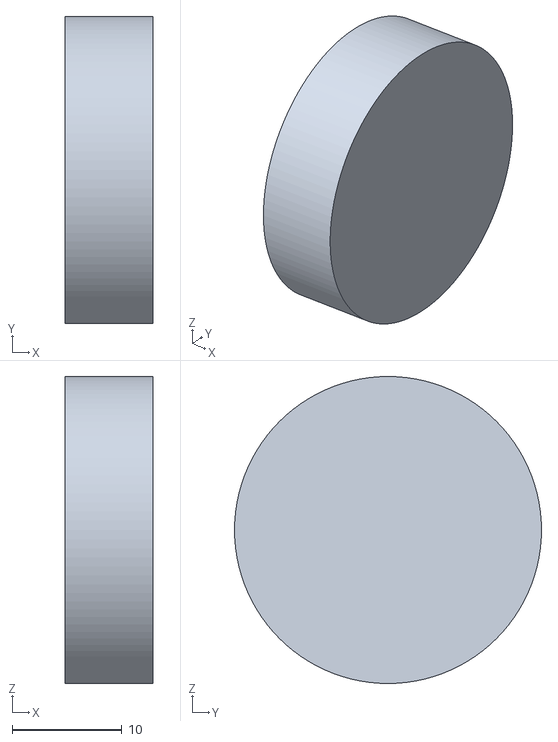
[picture p116: CAD file, 2026-10-28]
stl/da/DA_L_CBPulley.stl
8.00 x 28.0 x 28.0
