JoshChomps/7_DOF_Arm/stl/da/DA_P7_Housing.stl

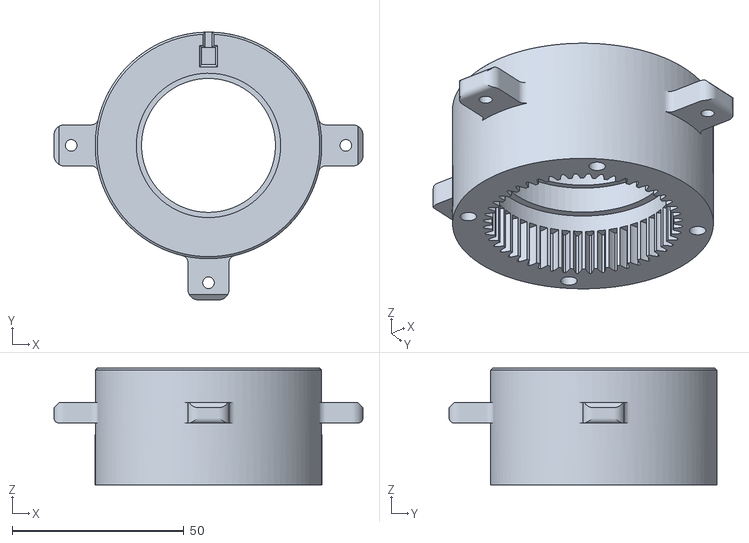
[picture p117: CAD file, 2026-10-28]
stl/da/DA_P7_Housing.stl
90.0 x 78.0 x 34.0
