JoshChomps/7_DOF_Arm/stl/da/DA_C2_Discb.stl

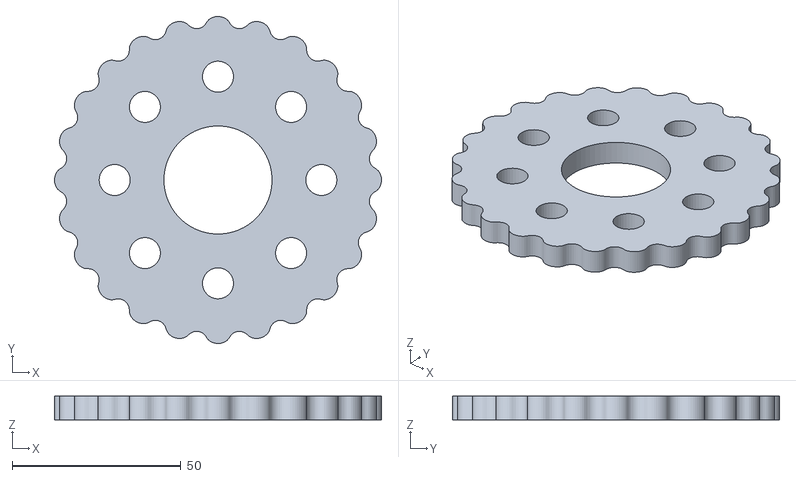
[picture p118: CAD file, 2026-10-28]
stl/da/DA_C2_Discb.stl
97.0 x 97.0 x 7.00
