JoshChomps/7_DOF_Arm/stl/da/DA_L_TowerRight.stl

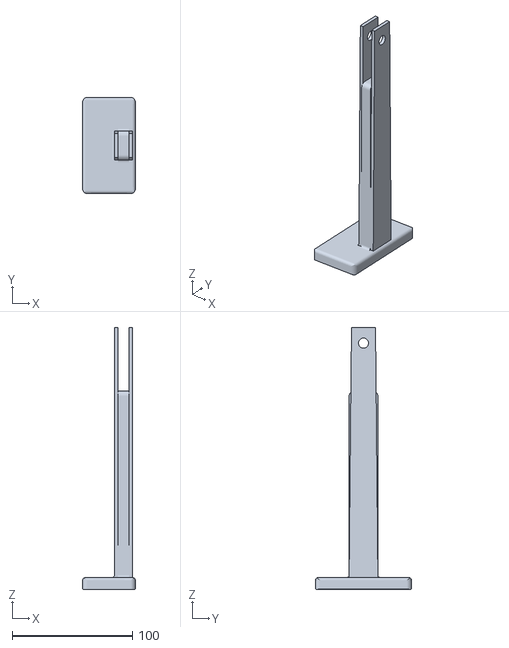
[picture p119: CAD file, 2026-10-28]
stl/da/DA_L_TowerRight.stl
44.0 x 80.0 x 218.0
