JoshChomps/7_DOF_Arm/stl/da/DA_P56_Carrier2.stl

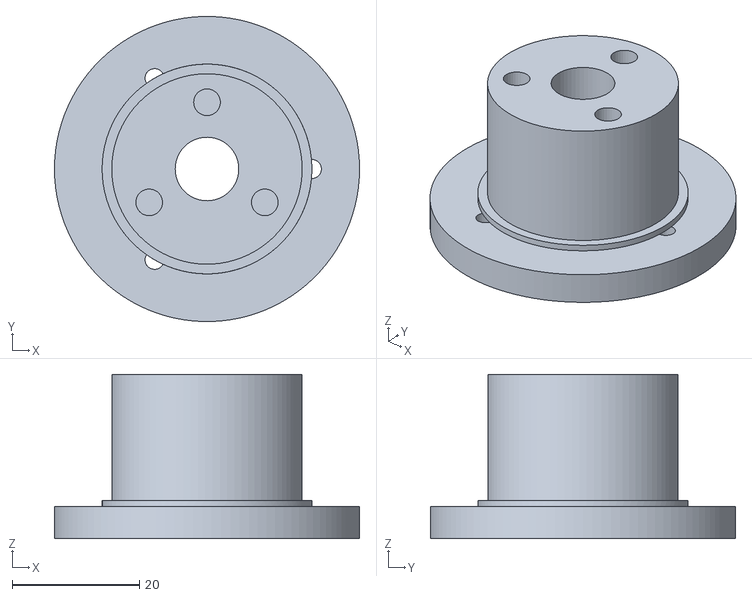
[picture p120: CAD file, 2026-10-28]
stl/da/DA_P56_Carrier2.stl
48.0 x 48.0 x 25.8
