JoshChomps/7_DOF_Arm/stl/da/DA_C34_Disc.stl

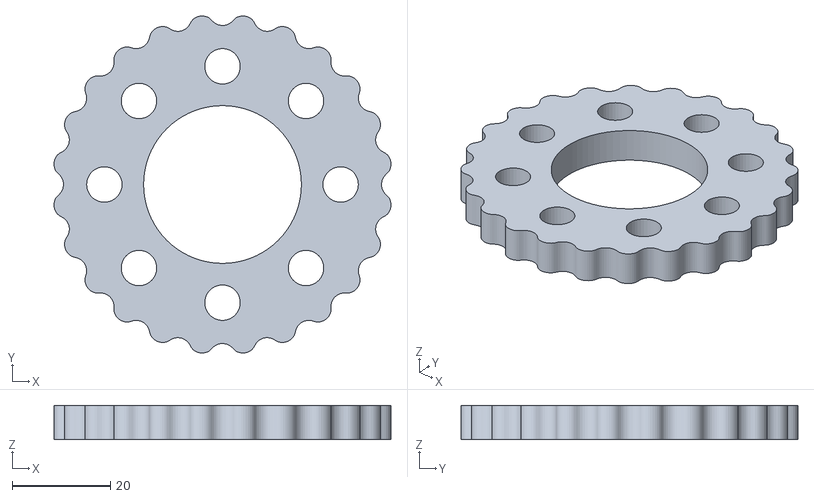
[picture p121: CAD file, 2026-10-28]
stl/da/DA_C34_Disc.stl
68.5 x 68.5 x 7.00
