JoshChomps/7_DOF_Arm/stl/da/DA_P7_Flange.stl

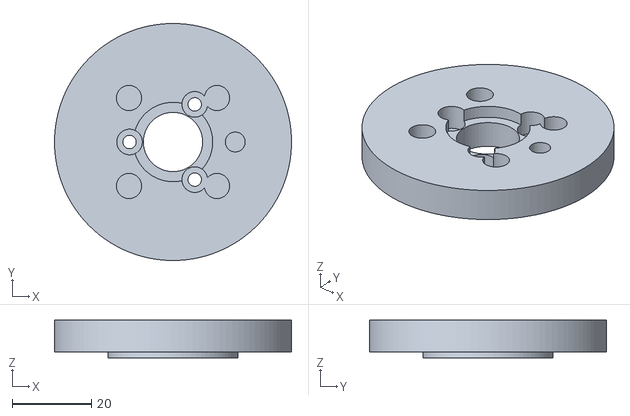
[picture p122: CAD file, 2026-10-28]
stl/da/DA_P7_Flange.stl
60.0 x 60.0 x 9.50
