JoshChomps/7_DOF_Arm/(list of files, cad)

Other CAD files:
stl/plates/rings/plate_1.3mf
stl/plates/bench/plate_1.3mf
stl/bench/C2_Stand.stl
stl/coupons/rings_6806.stl
stl/da/DA_C2_Carrier.stl
software/deskarm/data/meshes/5_motor.stl
stl/da/DA_C2_Disc.stl
software/deskarm/data/meshes/3_pcb.stl
software/deskarm/data/meshes/3_belt.stl
software/deskarm/data/meshes/2_motor.stl
software/deskarm/data/meshes/3_motor.stl
software/deskarm/data/meshes/2_metal.stl
