JoshChomps/7_DOF_Arm/hardware/renders/board_a.pdf

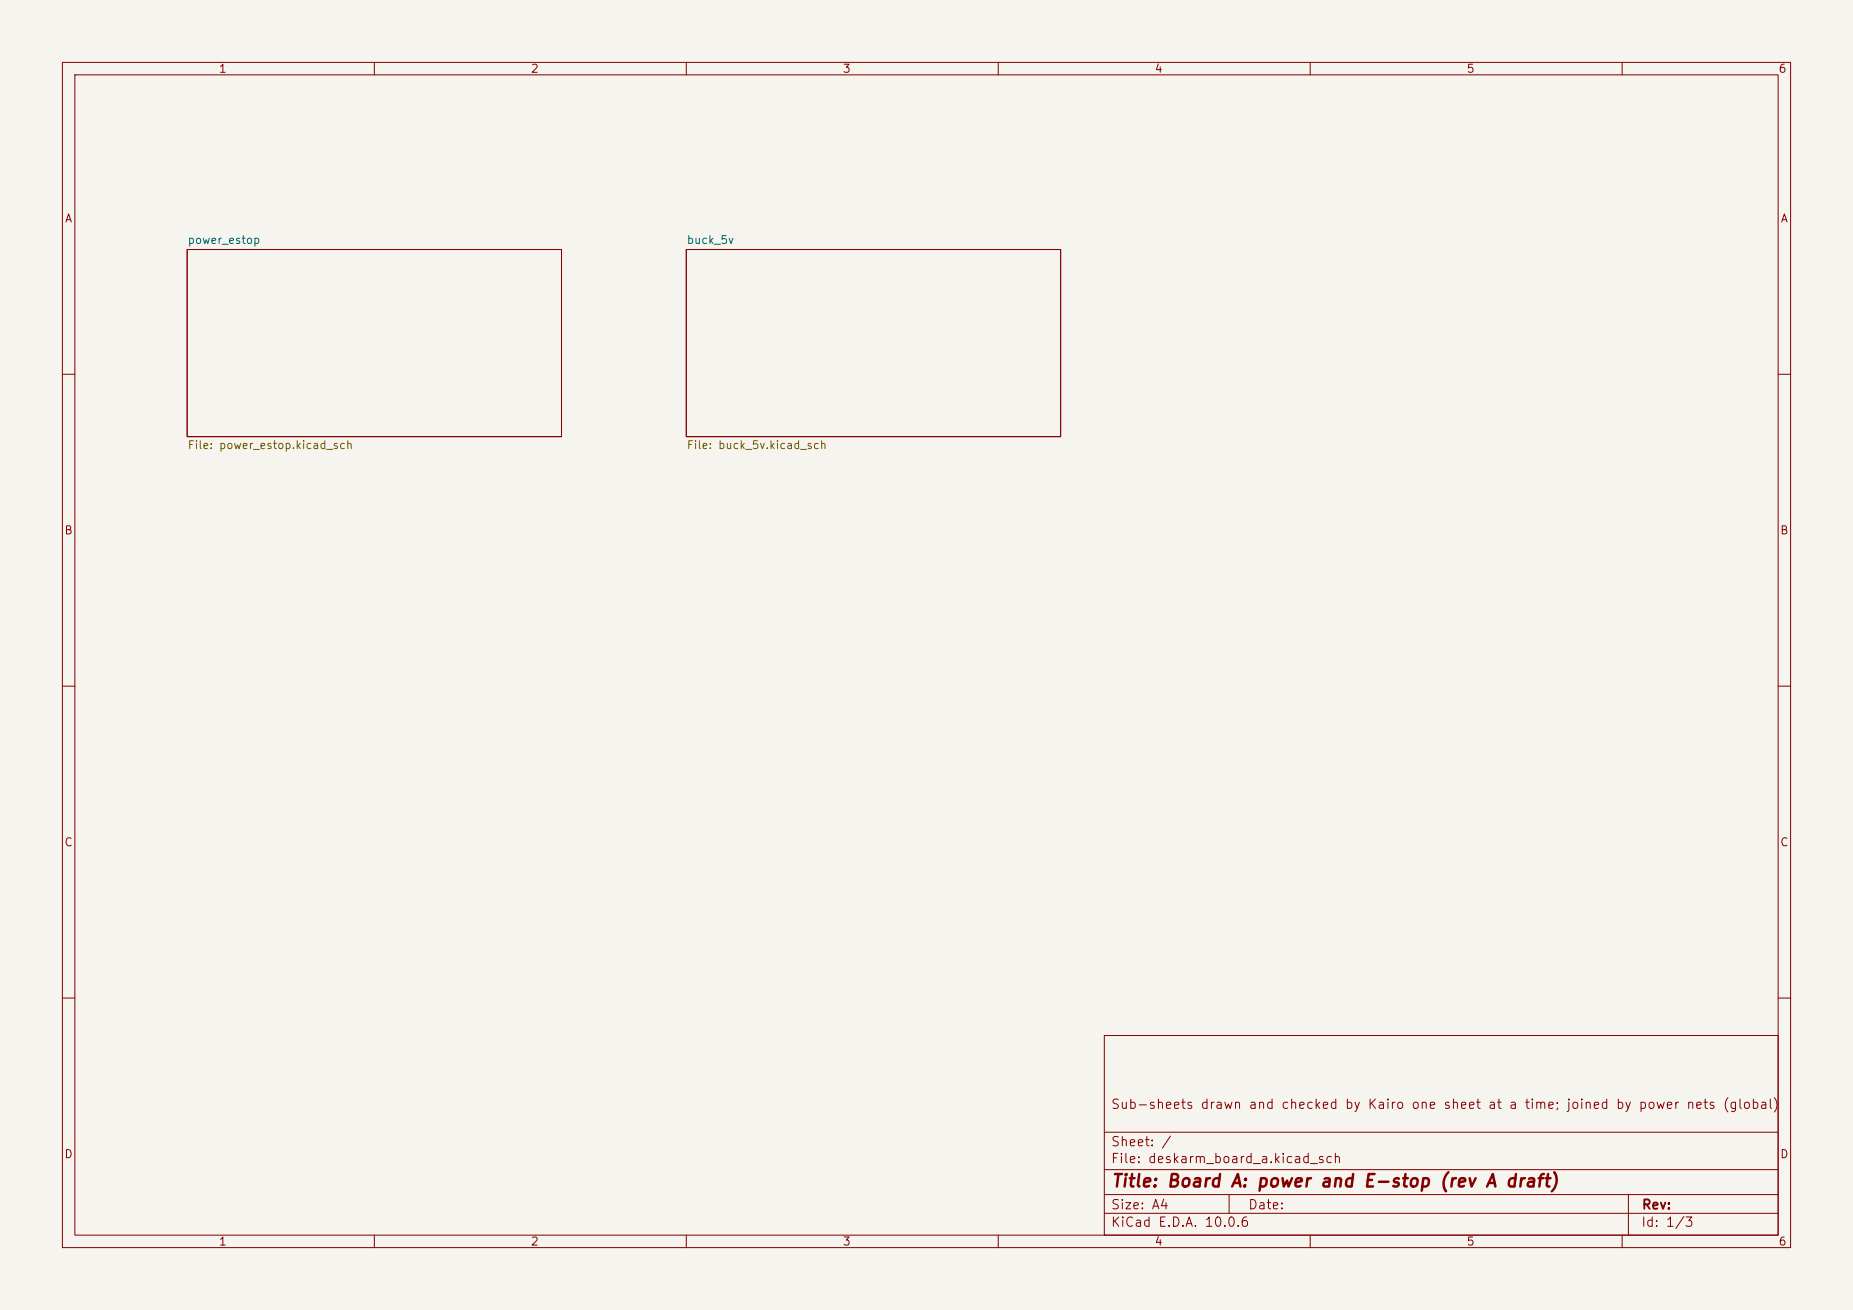
[picture p123: page 1]

Sub-sheets drawn and checked by Kairo one sheet at a time; joined by power nets (global)

Sheet: /
File: deskarm_board_a.kicad_sch
Title: Board A: power and E-stop (rev A draft)

Size: A4 | Rev:
KiCad E.D.A. 10.0.6 | Id: 1/3

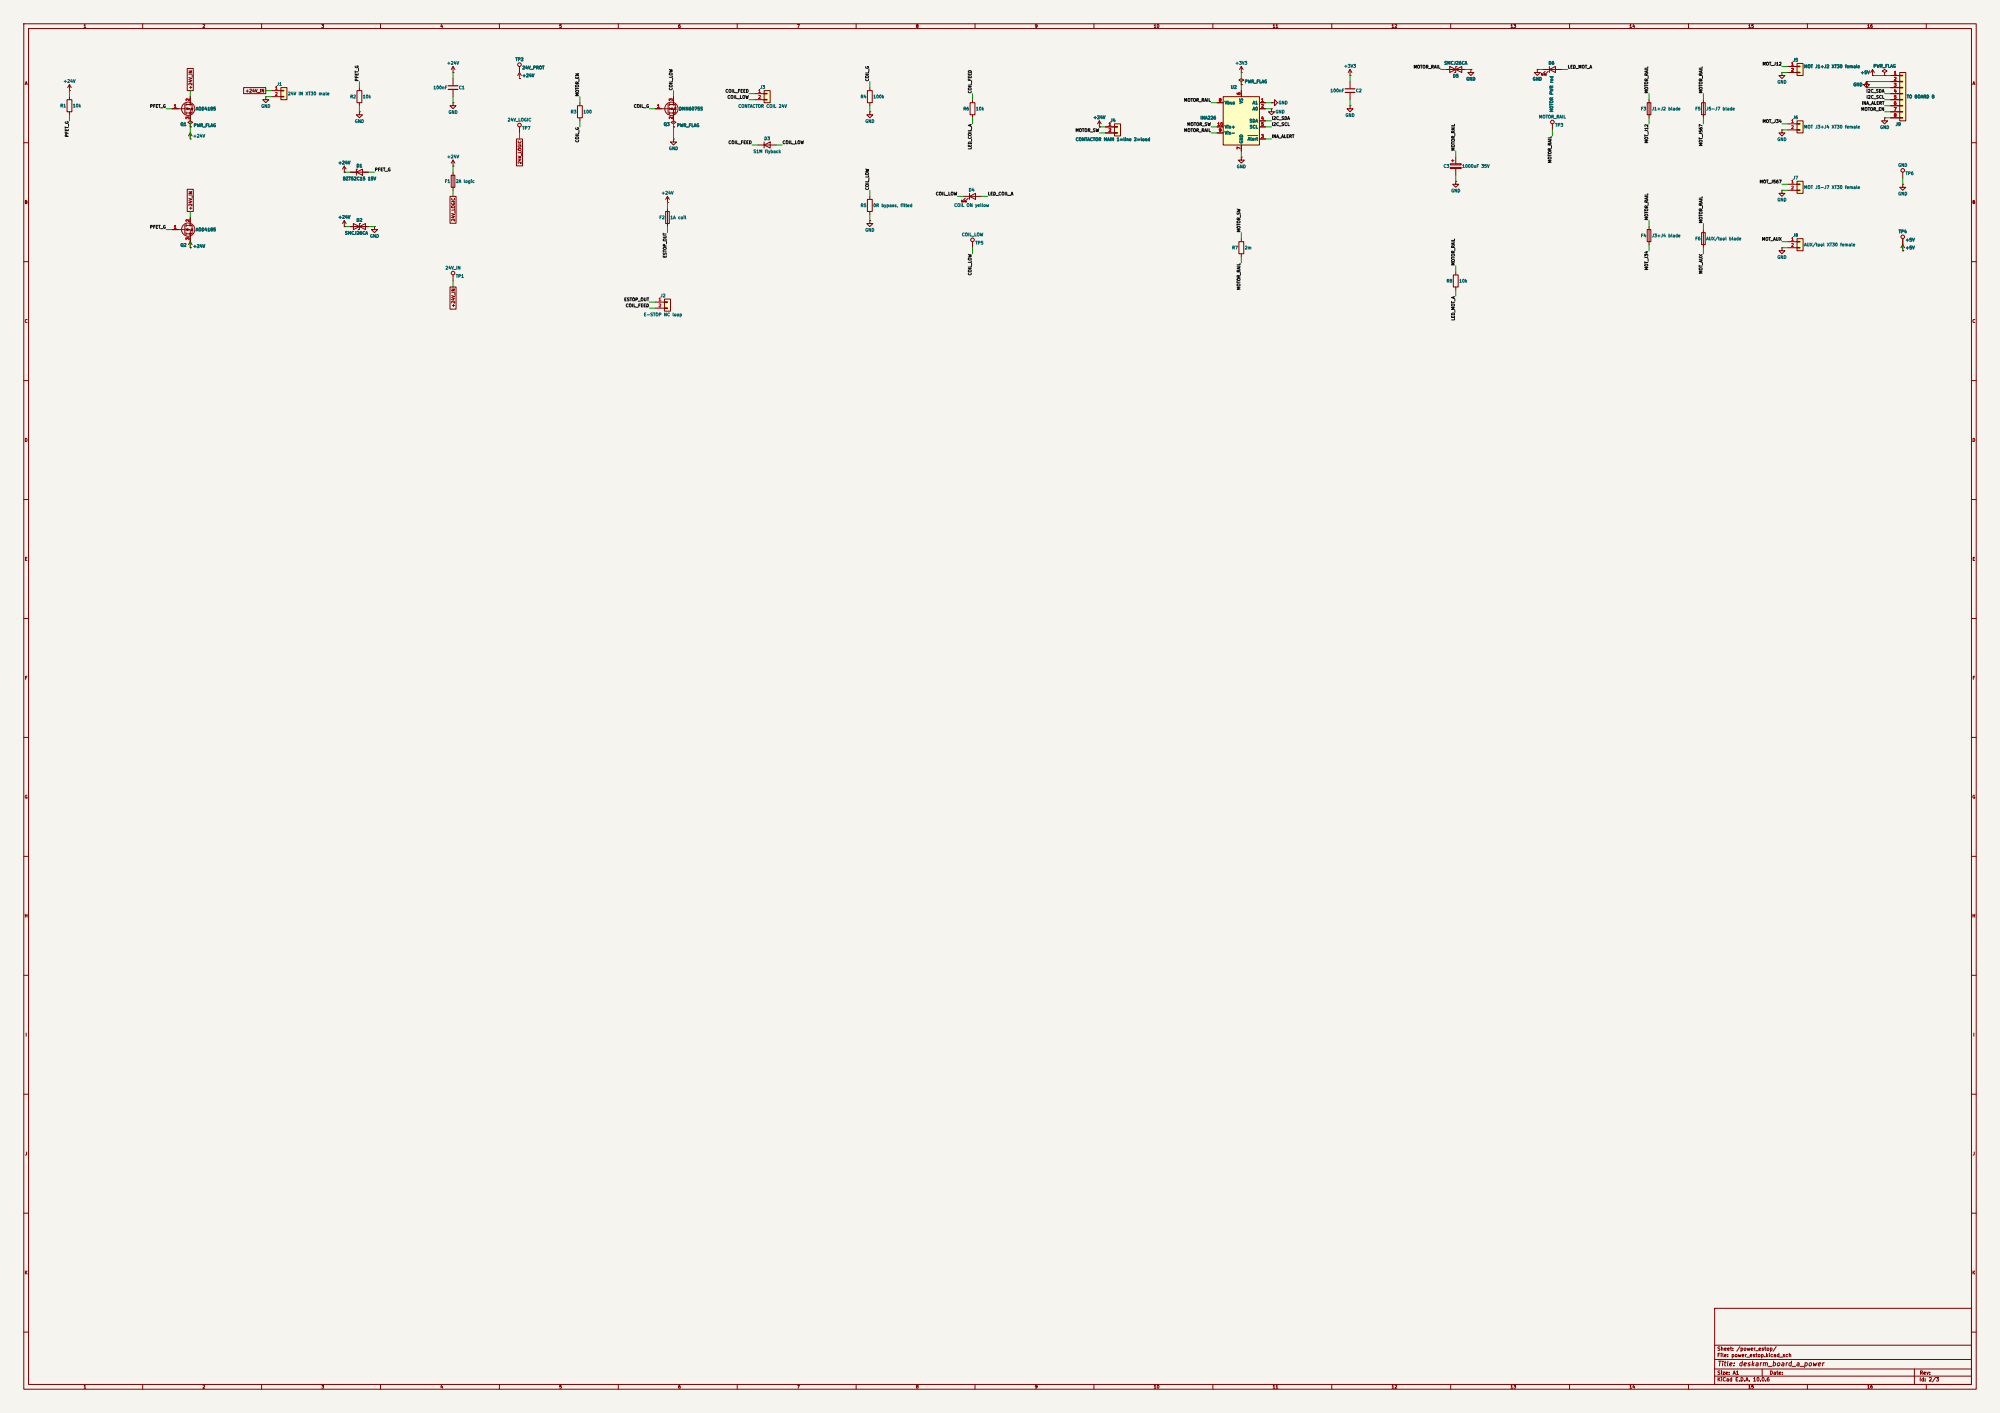
[picture p124: page 2]

AUX/tool XT30 female GND

J4 CONTACTOR MAIN 1=line 2=load 1

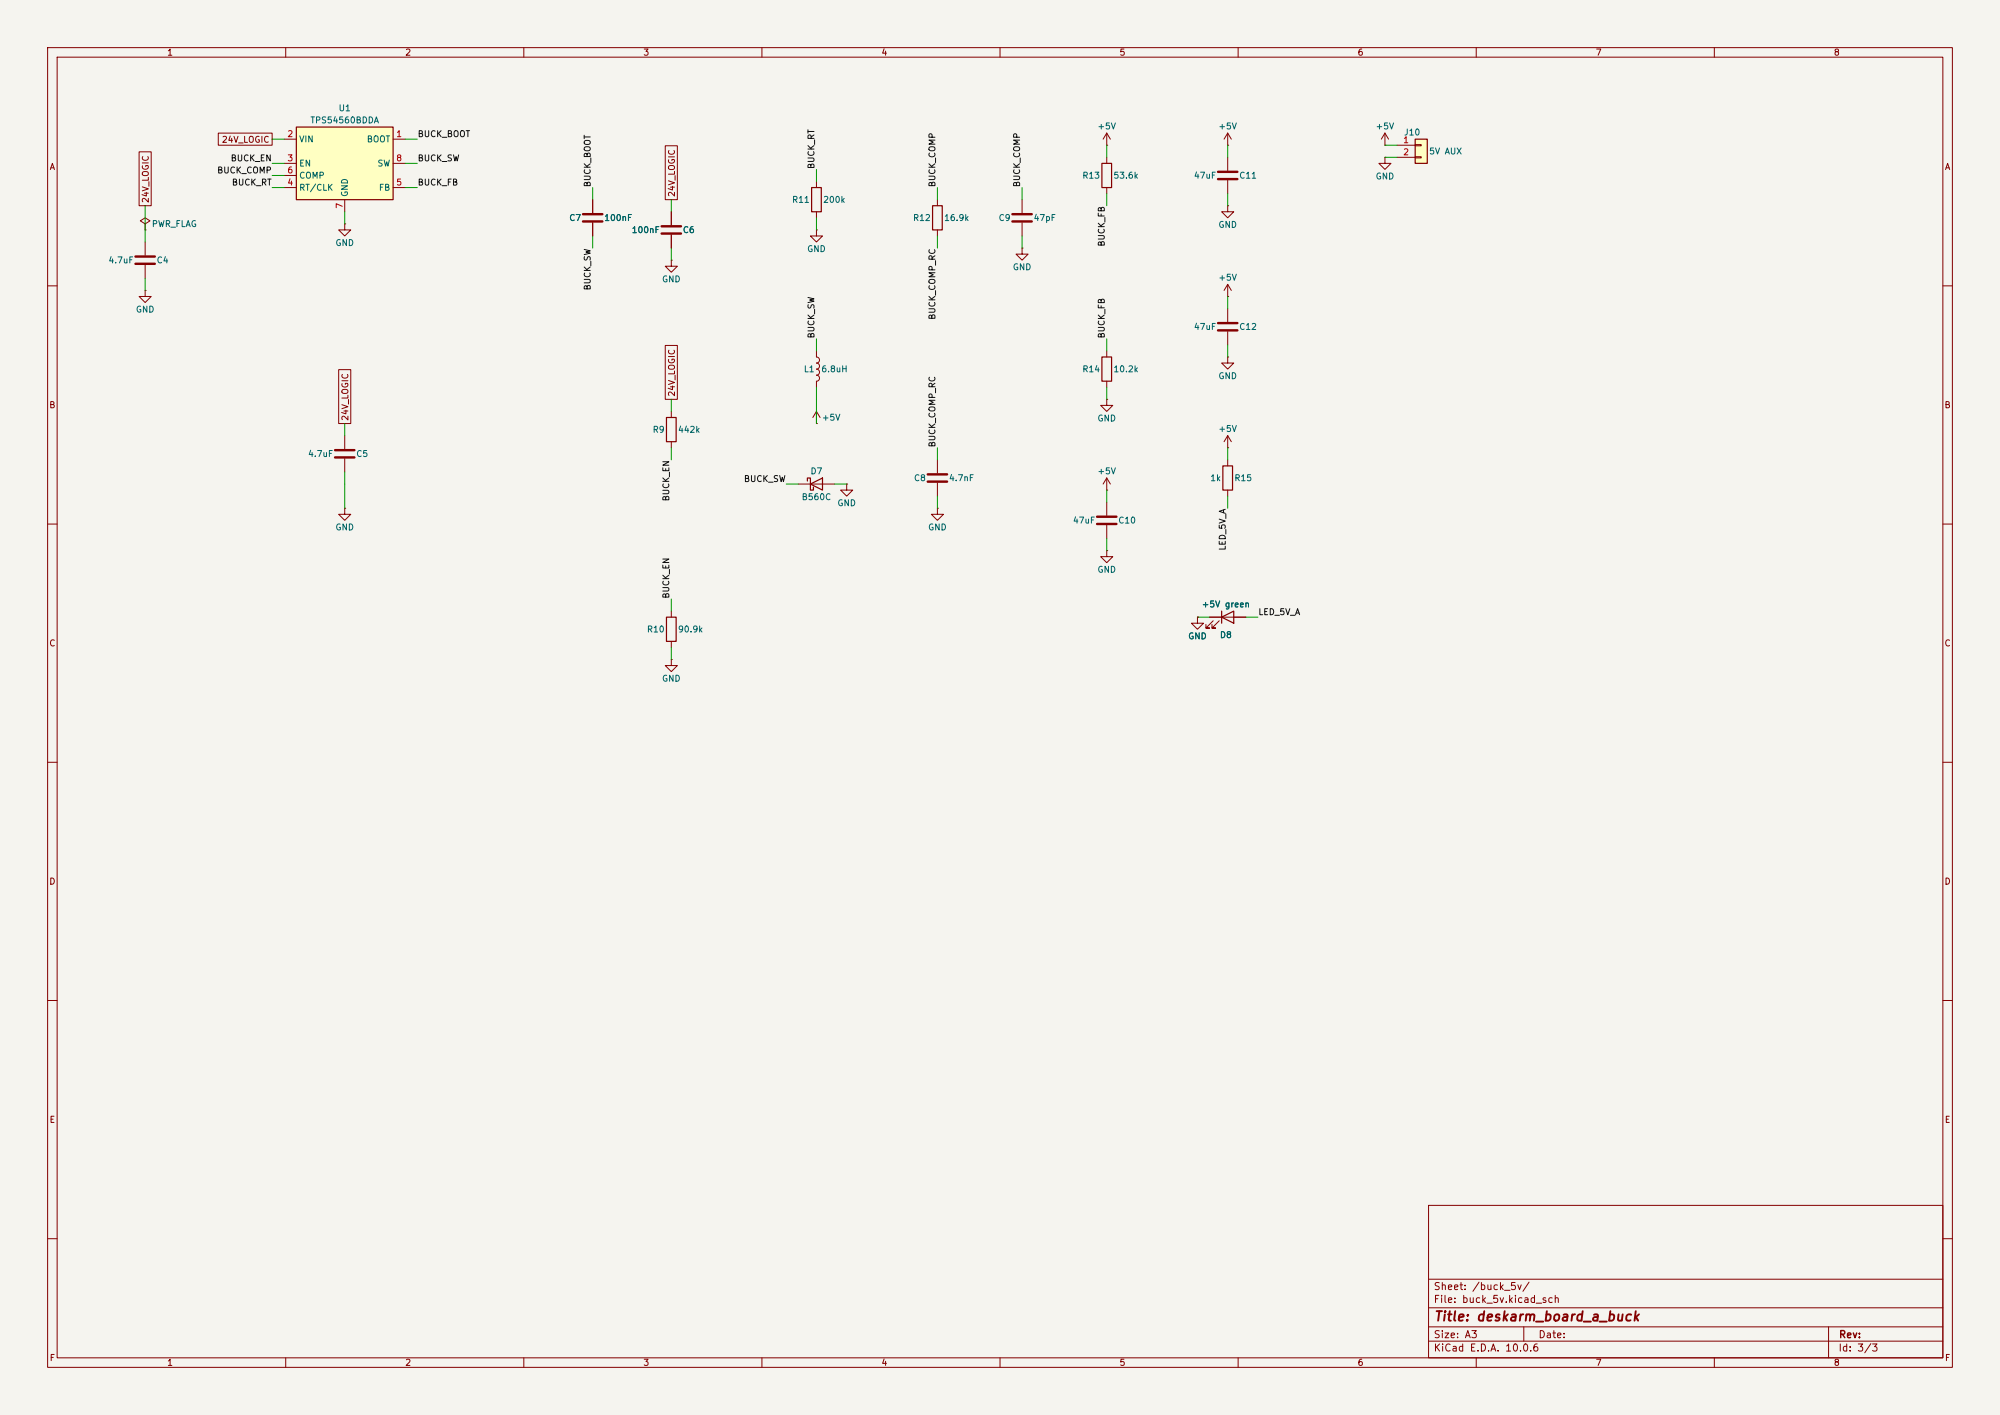
[picture p125: page 3]
