JoshChomps/7_DOF_Arm/hardware/renders/board_b.pdf

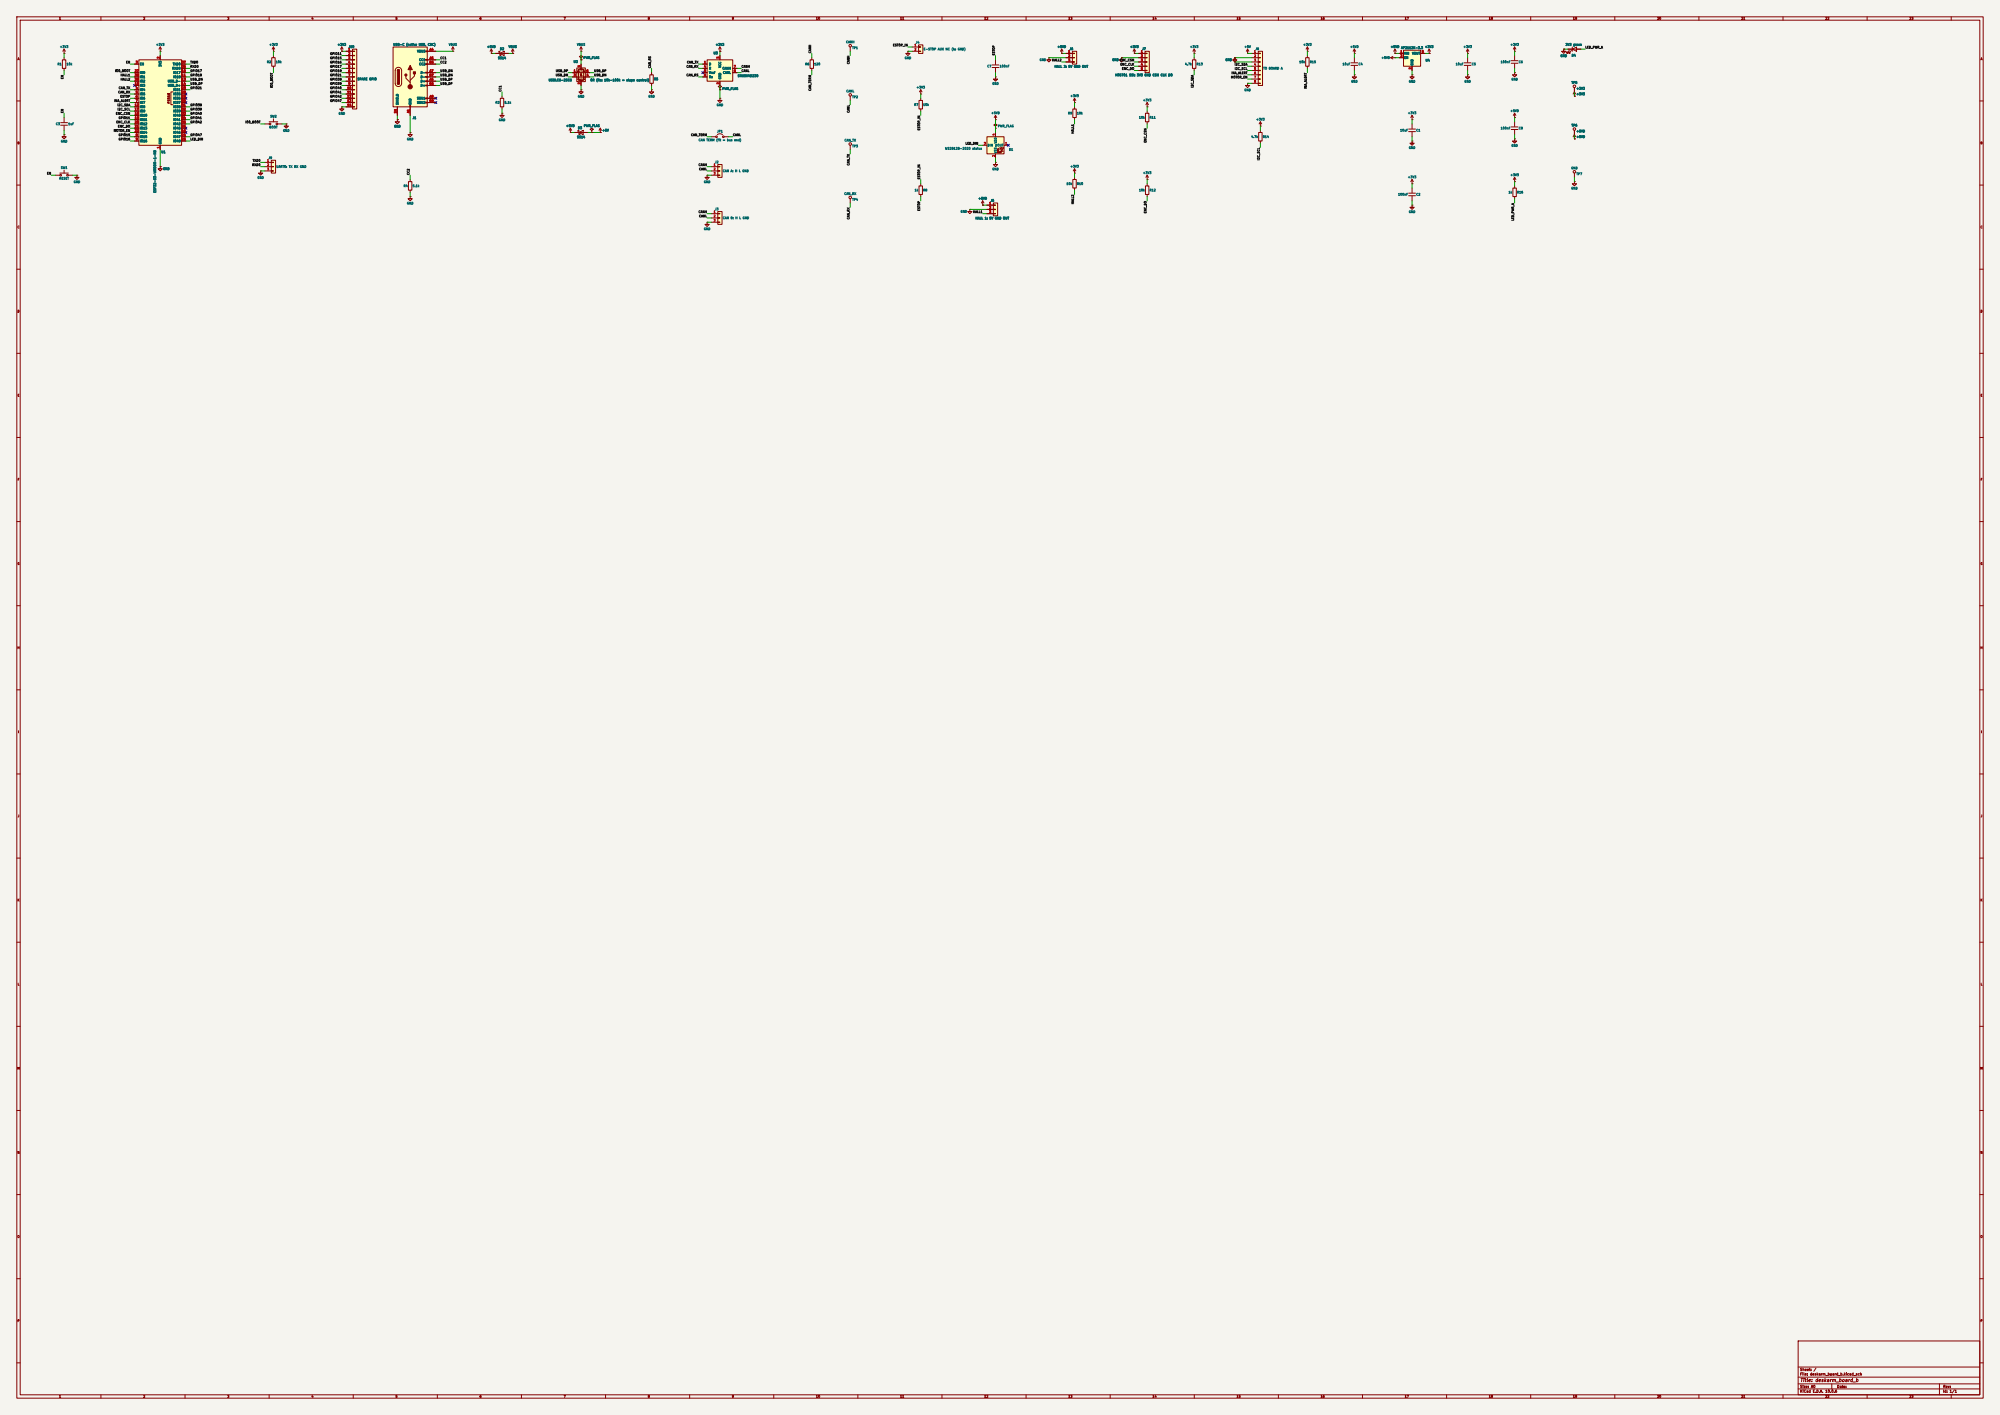
[picture p126: page 1]

J1 USB-C (native USB, CDC) GND

J1 USB-C (native USB, CDC) GND A1

J7 MT6701 SSI: 3V3 GND CSN CLK DO +3V3

J7 MT6701 SSI: 3V3 GND CSN CLK DO

JP1 CAN TERM (fit = bus end) GND

Size: A0 | Rev:
KiCad E.D.A. 10.0.6 | Id: 1/1
