JoshChomps/7_DOF_Arm/hardware/renders/board_c.pdf

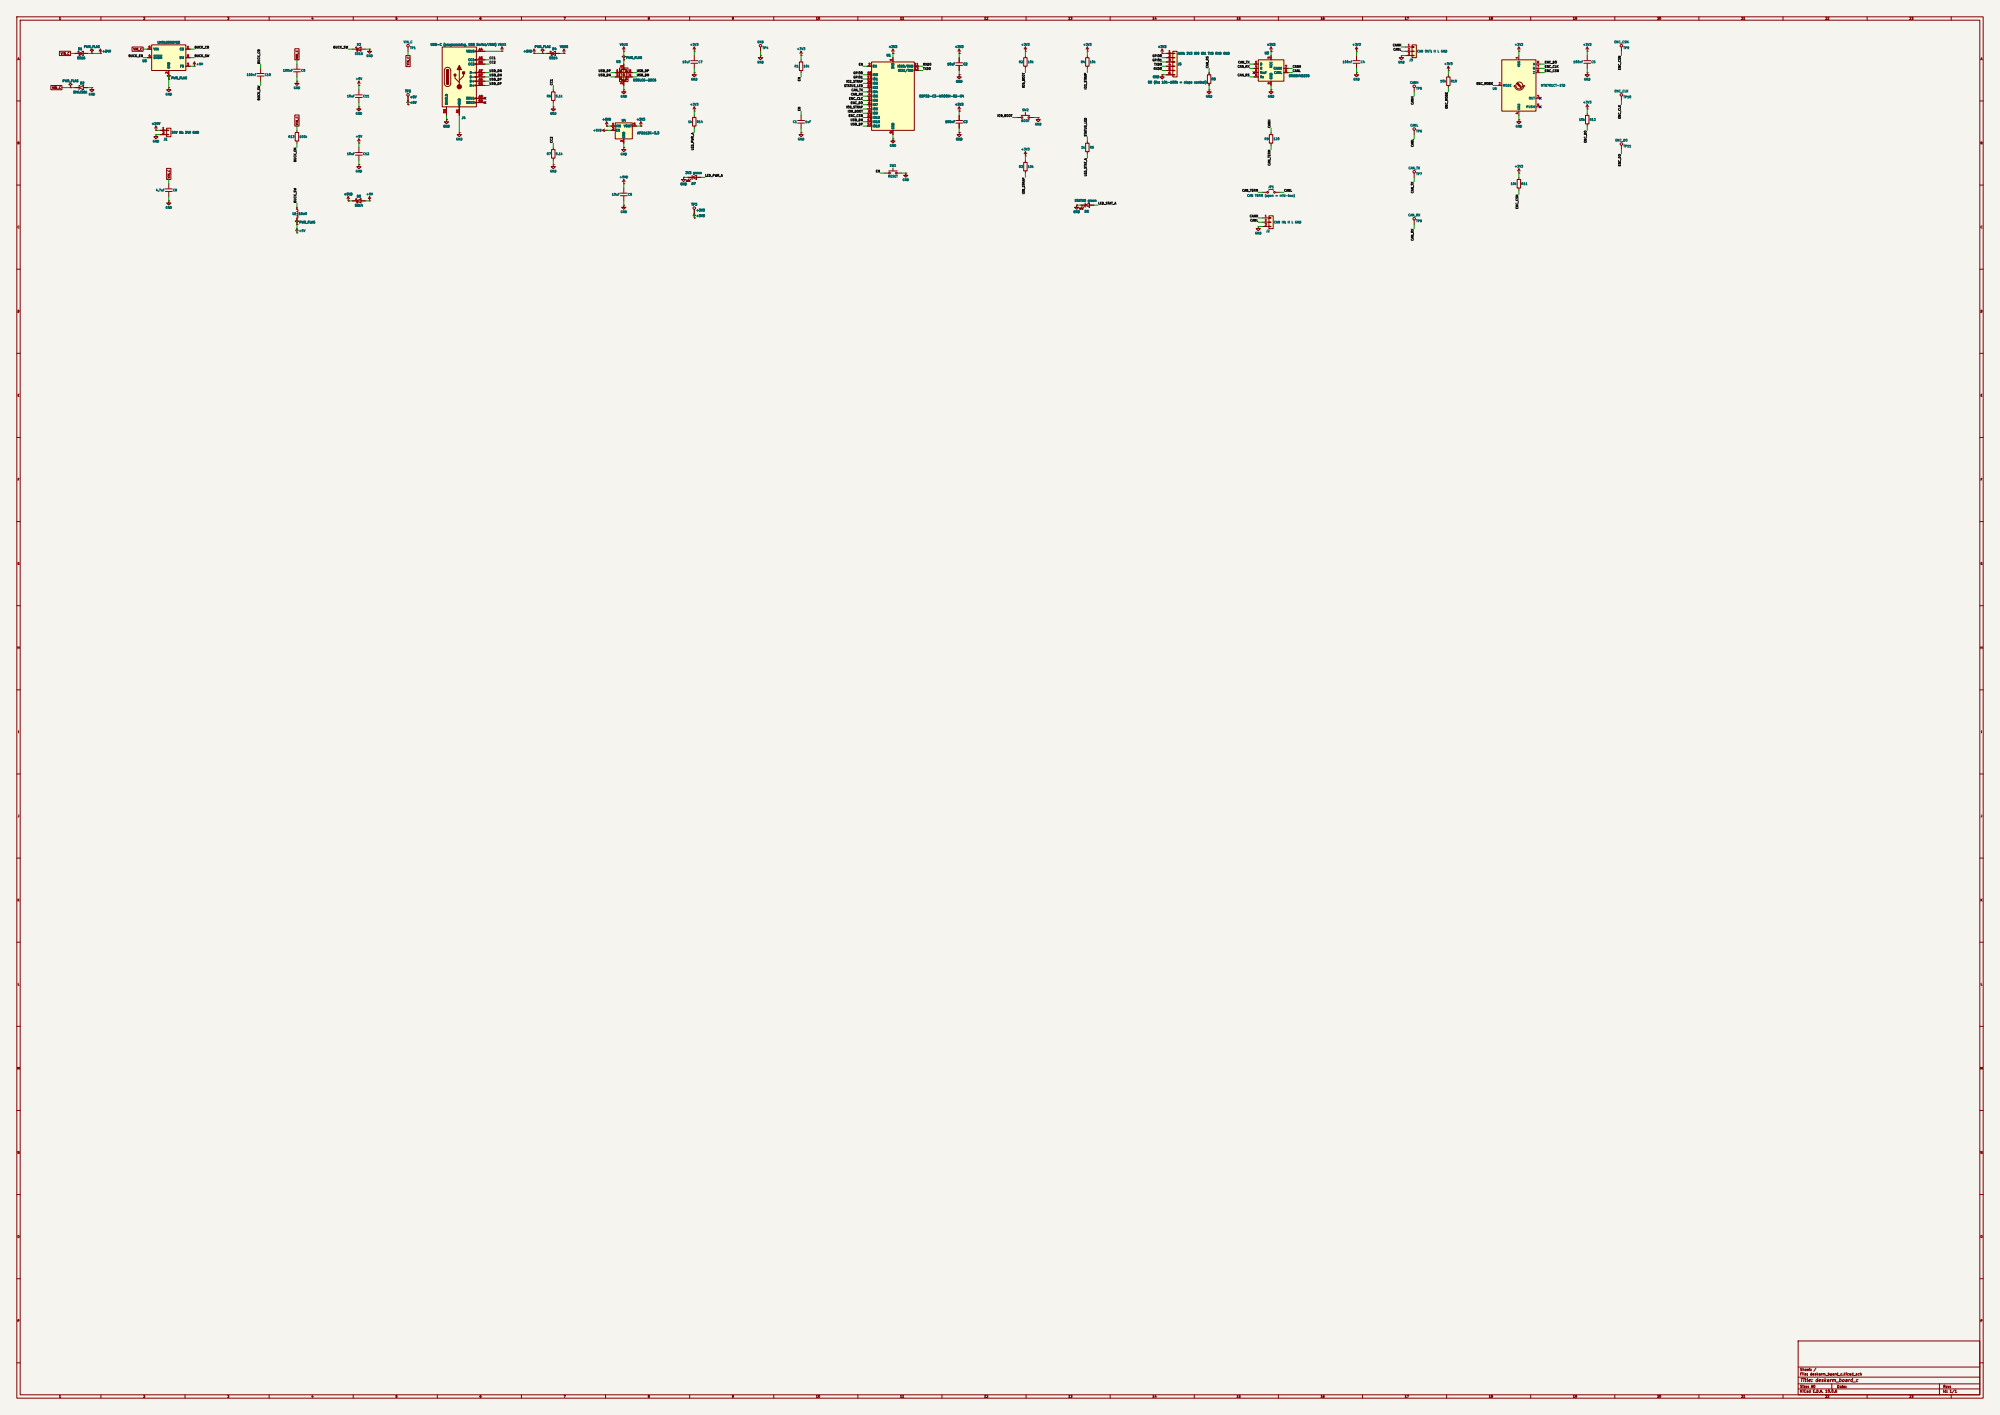
[picture p127: page 1]

J4 USB-C (programming, USB Serial/JTAG) GND A1

AUX: 3V3 IO0 IO1 TXD RXD GND +3V3

Size: A0 | Rev:
KiCad E.D.A. 10.0.6 | Id: 1/1
