JoshChomps/7_DOF_Arm/hardware/board_a/buck_5v.kicad_sch

## KiCad design hardware/board_a/buck_5v.kicad_sch (2026-10-28)

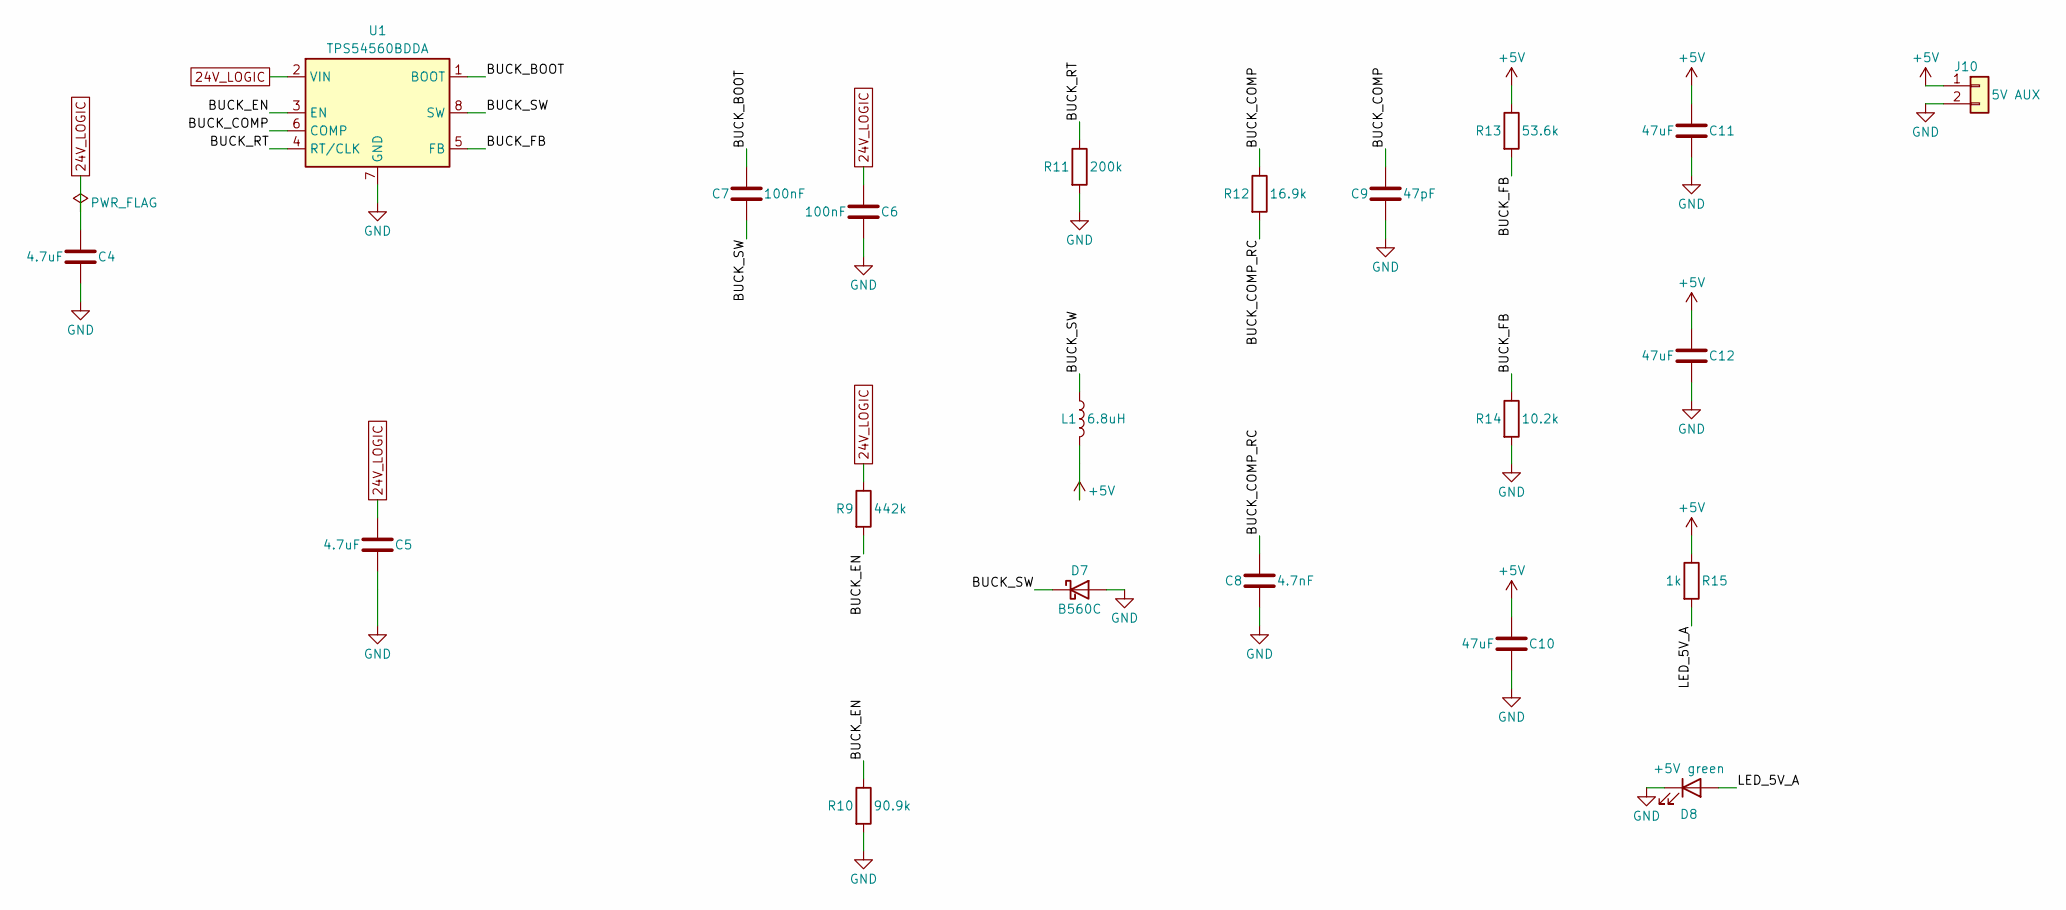
[picture p128: schematic buck_5v.kicad_sch]

Parts:
C4, C5: 4.7uF; C_1206_3216Metric
C6, C7: 100nF; C_0603_1608Metric
C8: 4.7nF; C_0603_1608Metric
C9: 47pF; C_0603_1608Metric
C10, C11, C12: 47uF; C_1210_3225Metric
D7: B560C; D_SMC
D8: +5V green; LED_0603_1608Metric
J10: 5V AUX; JST_XH_B2B-XH-A_1x02_P2.50mm_Vertical
L1: 6.8uH; L_7.3x7.3_H4.5
R9: 442k; R_0603_1608Metric
R10: 90.9k; R_0603_1608Metric
R11: 200k; R_0603_1608Metric
R12: 16.9k; R_0603_1608Metric
R13: 53.6k; R_0603_1608Metric
R14: 10.2k; R_0603_1608Metric
R15: 1k; R_0603_1608Metric
U1: TPS54560BDDA; Texas_R-PDSO-G8_EP2.95x4.9mm_Mask2.4x3.1mm_ThermalVias

Connections:
24V_LOGIC: C4.1, C5.1, C6.1, R9.1, U1.2 (VIN)
+5V: C10.1, C11.1, C12.1, J10.1, L1.2, R13.1, R15.1
BUCK_BOOT: C7.1, U1.1 (BOOT)
BUCK_COMP: C9.1, R12.1, U1.6 (COMP)
BUCK_COMP_RC: C8.1, R12.2
BUCK_EN: R9.2, R10.1, U1.3 (EN)
BUCK_FB: R13.2, R14.1, U1.5 (FB)
BUCK_RT: R11.1, U1.4 (RT/CLK)
BUCK_SW: C7.2, D7.1 (K), L1.1, U1.8 (SW)
GND: C4.2, C5.2, C6.2, C8.2, C9.2, C10.2, C11.2, C12.2, D7.2 (A), D8.1 (K), J10.2, R10.2, R11.2, R14.2, U1.7 (GND), U1.9 (GND)
LED_5V_A: D8.2 (A), R15.2
