JoshChomps/7_DOF_Arm/hardware/board_a/power_estop.kicad_sch

## KiCad design hardware/board_a/power_estop.kicad_sch (2026-10-28)

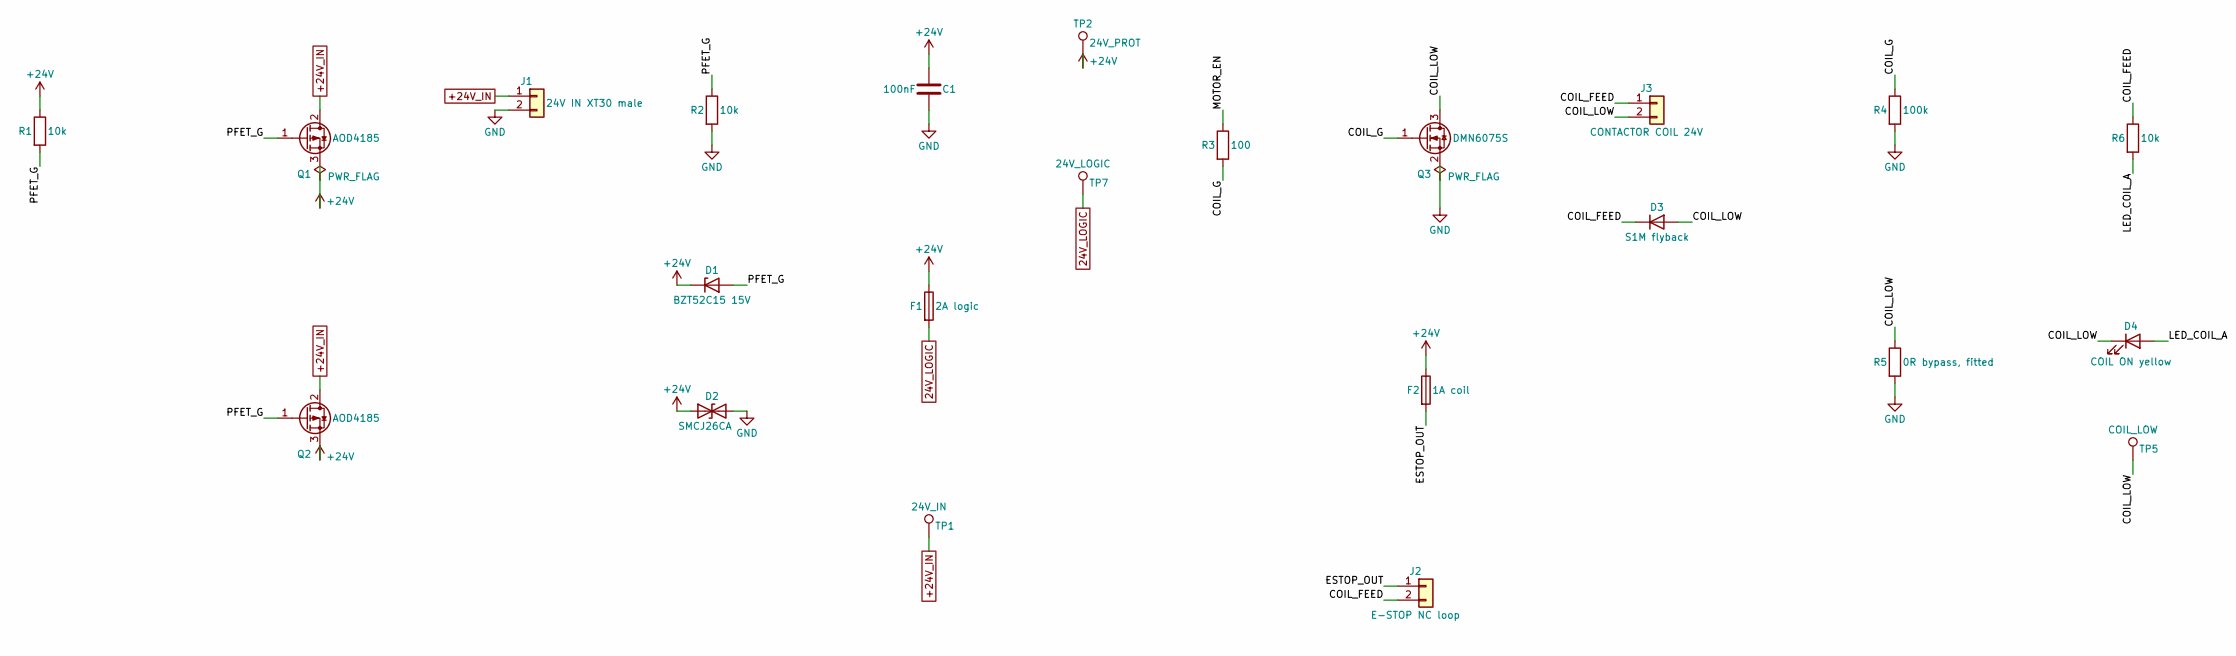
[picture p129: schematic power_estop.kicad_sch, part in row 1, column 1]

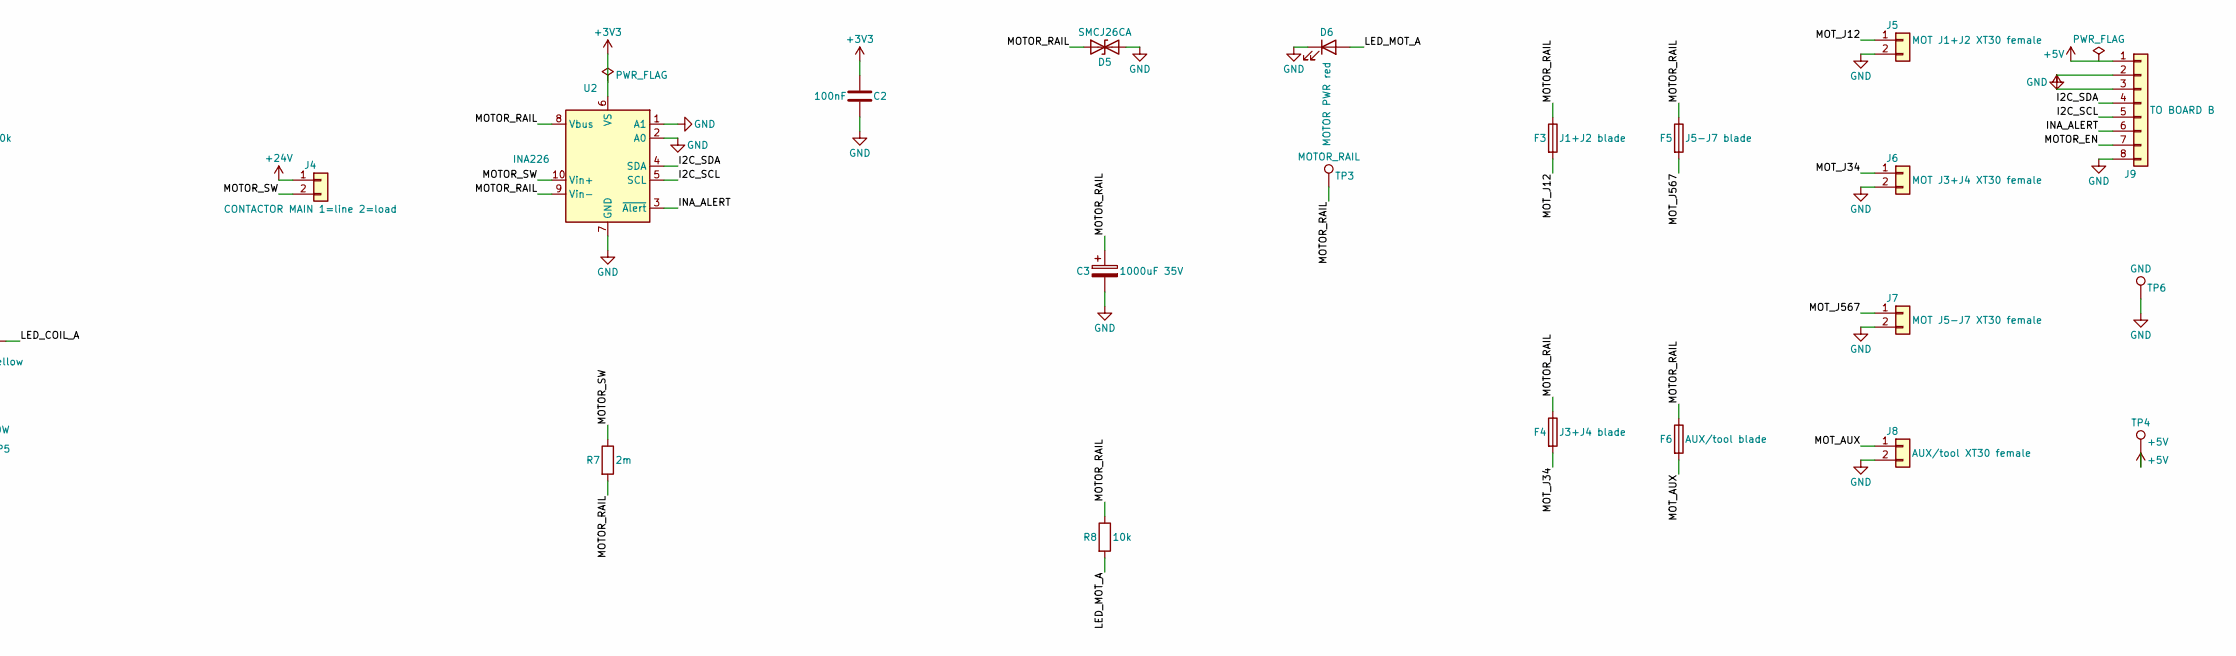
[picture p130: schematic power_estop.kicad_sch, part in row 1, column 2]

Parts:
C1, C2: 100nF; C_0603_1608Metric
C3: 1000uF 35V; CP_Radial_D12.5mm_P5.00mm
D1: BZT52C15 15V; D_SOD-123
D2, D5: SMCJ26CA; D_SMC
D3: S1M flyback; D_SMA
D4: COIL ON yellow; LED_0603_1608Metric
D6: MOTOR PWR red; LED_0603_1608Metric
F1: 2A logic; Fuse_1812_4532Metric
F2: 1A coil; Fuse_1206_3216Metric
F3: J1+J2 blade; Fuseholder_Blade_Mini_Keystone_3568
F4: J3+J4 blade; Fuseholder_Blade_Mini_Keystone_3568
F5: J5-J7 blade; Fuseholder_Blade_Mini_Keystone_3568
F6: AUX/tool blade; Fuseholder_Blade_Mini_Keystone_3568
J1: 24V IN XT30 male; AMASS_XT30UPB-M_1x02_P5.0mm_Vertical
J2: E-STOP NC loop; TerminalBlock_Phoenix_MKDS-1,5-2-5.08_1x02_P5.08mm_Horizont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
J3: CONTACTOR COIL 24V; TerminalBlock_Phoenix_MKDS-1,5-2-5.08_1x02_P5.08mm_Horizont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
J4: CONTACTOR MAIN 1=line 2=load; TerminalBlock_Phoenix_MKDS-3-2-5.08_1x02_P5.08mm_Horizontal
J5: MOT J1+J2 XT30 female; AMASS_XT30UPB-F_1x02_P5.0mm_Vertical
J6: MOT J3+J4 XT30 female; AMASS_XT30UPB-F_1x02_P5.0mm_Vertical
J7: MOT J5-J7 XT30 female; AMASS_XT30UPB-F_1x02_P5.0mm_Vertical
J8: AUX/tool XT30 female; AMASS_XT30UPB-F_1x02_P5.0mm_Vertical
J9: TO BOARD B; JST_XH_B8B-XH-A_1x08_P2.50mm_Vertical
Q1, Q2: AOD4185; TO-252-2
Q3: DMN6075S; SOT-23
R1, R2: 10k; R_0603_1608Metric
R3: 100; R_0603_1608Metric
R4: 100k; R_0603_1608Metric
R5: 0R bypass, fitted; R_1206_3216Metric
R6, R8: 10k; R_1206_3216Metric
R7: 2m; R_2512_6332Metric
TP1: 24V_IN; TestPoint_Pad_D1.5mm
TP2: 24V_PROT; TestPoint_Pad_D1.5mm
TP3: MOTOR_RAIL; TestPoint_Pad_D1.5mm
TP4: +5V; TestPoint_Pad_D1.5mm
TP5: COIL_LOW; TestPoint_Pad_D1.5mm
TP6: GND; TestPoint_Pad_D1.5mm
TP7: 24V_LOGIC; TestPoint_Pad_D1.5mm
U2: INA226; TSSOP-10_3x3mm_P0.5mm

Connections:
24V_LOGIC: F1.2, TP7.1
+3V3: C2.1, J9.3, U2.6 (VS)
+5V: J9.1, TP4.1
+24V: C1.1, D1.1 (K), D2.1 (A1), F1.1, F2.1, J4.1, Q1.3 (S), Q2.3 (S), R1.1, TP2.1
+24V_IN: J1.1, Q1.2 (D), Q2.2 (D), TP1.1
COIL_FEED: D3.1 (K), J2.2, J3.1, R6.1
COIL_G: Q3.1 (G), R3.2, R4.1
COIL_LOW: D3.2 (A), D4.1 (K), J3.2, Q3.3 (D), R5.1, TP5.1
ESTOP_OUT: F2.2, J2.1
GND: C1.2, C2.2, C3.2, D2.2 (A2), D5.2 (A2), D6.1 (K), J1.2, J5.2, J6.2, J7.2, J8.2, J9.2, J9.8, Q3.2 (S), R2.2, R4.2, R5.2, TP6.1, U2.1 (A1), U2.2 (A0), U2.7 (GND)
I2C_SCL: J9.5, U2.5 (SCL)
I2C_SDA: J9.4, U2.4 (SDA)
INA_ALERT: J9.6, U2.3 (~Alert)
LED_COIL_A: D4.2 (A), R6.2
LED_MOT_A: D6.2 (A), R8.2
MOTOR_EN: J9.7, R3.1
MOTOR_RAIL: C3.1, D5.1 (A1), F3.1, F4.1, F5.1, F6.1, R7.2, R8.1, TP3.1, U2.8 (Vbus), U2.9 (Vin-)
MOTOR_SW: J4.2, R7.1, U2.10 (Vin+)
MOT_AUX: F6.2, J8.1
MOT_J12: F3.2, J5.1
MOT_J34: F4.2, J6.1
MOT_J567: F5.2, J7.1
PFET_G: D1.2 (A), Q1.1 (G), Q2.1 (G), R1.2, R2.1
