JoshChomps/7_DOF_Arm/hardware/board_b/deskarm_board_b.kicad_sch

## KiCad design hardware/board_b/deskarm_board_b.kicad_sch (2026-10-28)

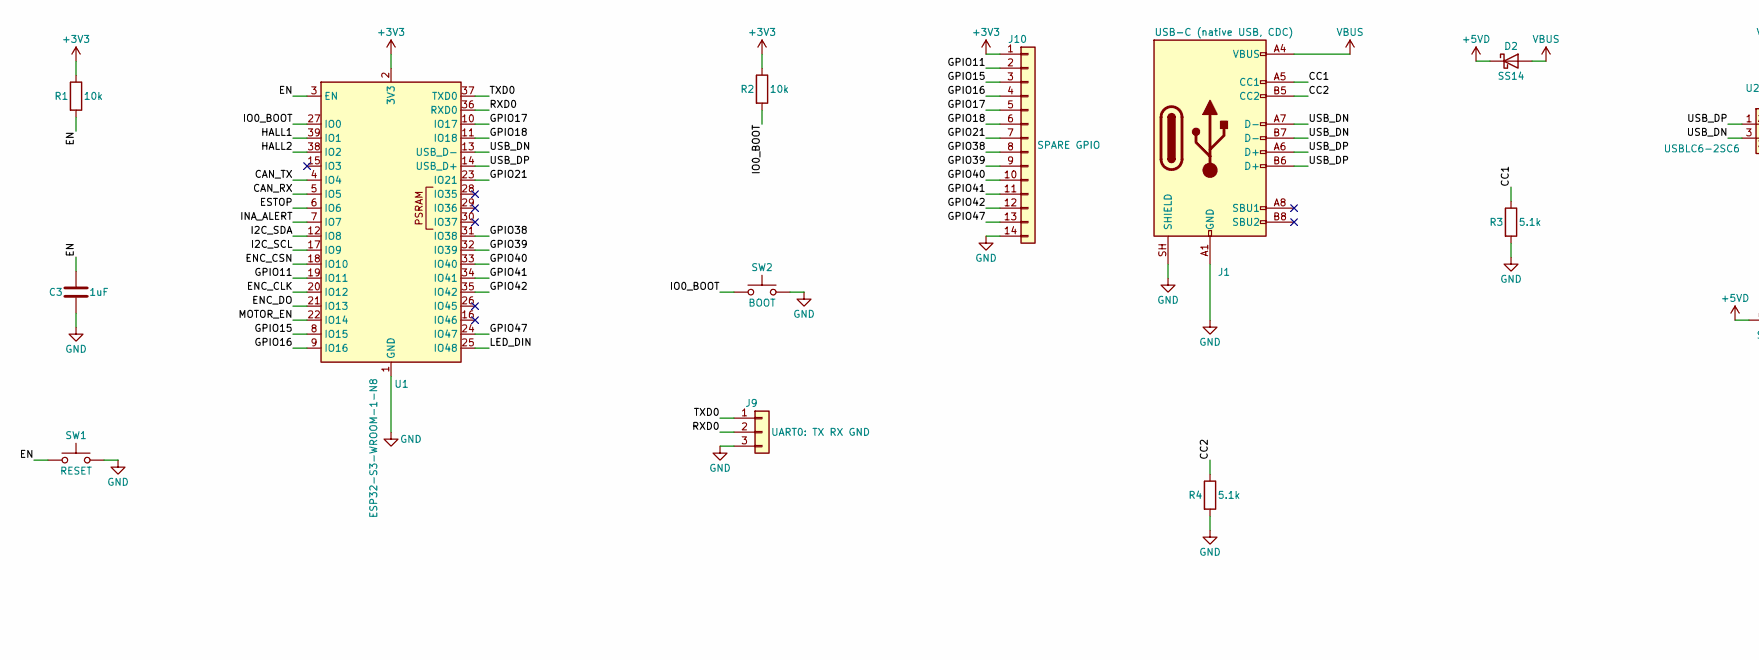
[picture p131: schematic deskarm_board_b.kicad_sch, part in row 1, column 1]

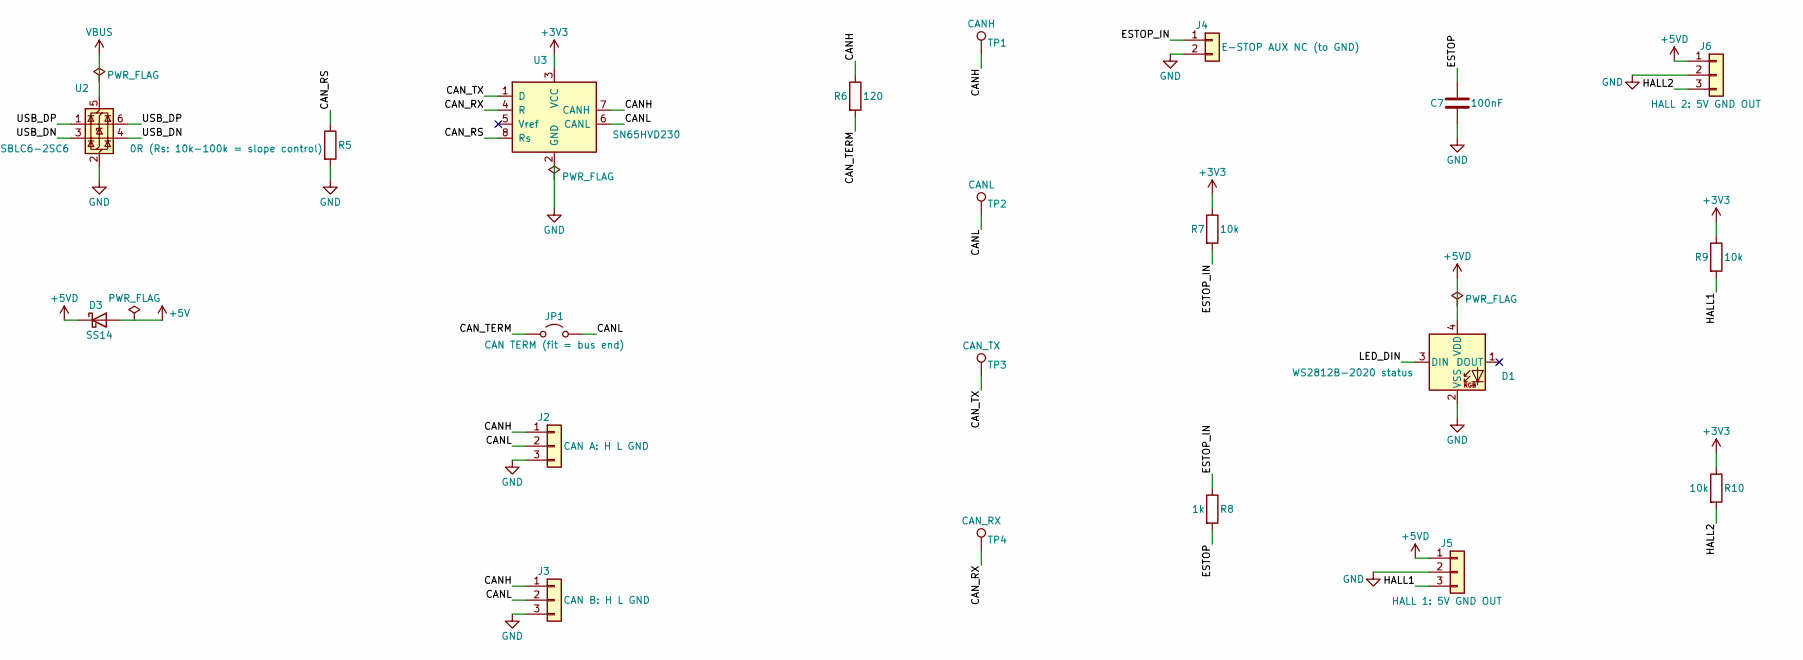
[picture p132: schematic deskarm_board_b.kicad_sch, part in row 1, column 2]

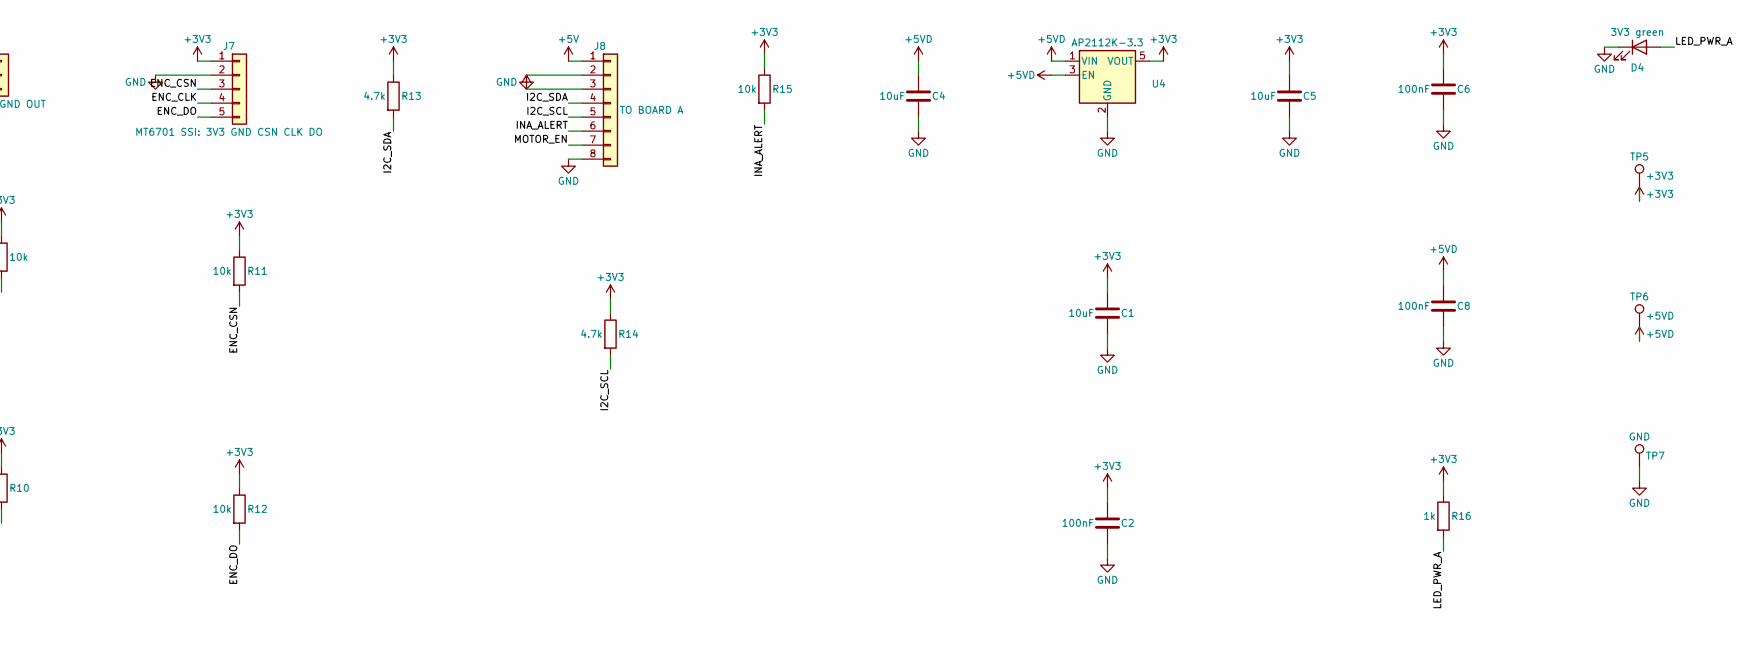
[picture p133: schematic deskarm_board_b.kicad_sch, part in row 1, column 3]

Parts:
C1, C4, C5: 10uF; C_0805_2012Metric
C2, C6, C7, C8: 100nF; C_0603_1608Metric
C3: 1uF; C_0603_1608Metric
D1: WS2812B-2020 status; LED_WS2812B-2020_PLCC4_2.0x2.0mm
D2, D3: SS14; D_SMA
D4: 3V3 green; LED_0603_1608Metric
J1: USB-C (native USB, CDC); USB_C_Receptacle_GCT_USB4105-xx-A_16P_TopMnt_Horizontal
J2: CAN A: H L GND; JST_XH_B3B-XH-A_1x03_P2.50mm_Vertical
J3: CAN B: H L GND; JST_XH_B3B-XH-A_1x03_P2.50mm_Vertical
J4: E-STOP AUX NC (to GND); JST_XH_B2B-XH-A_1x02_P2.50mm_Vertical
J5: HALL 1: 5V GND OUT; JST_XH_B3B-XH-A_1x03_P2.50mm_Vertical
J6: HALL 2: 5V GND OUT; JST_XH_B3B-XH-A_1x03_P2.50mm_Vertical
J7: MT6701 SSI: 3V3 GND CSN CLK DO; JST_XH_B5B-XH-A_1x05_P2.50mm_Vertical
J8: TO BOARD A; JST_XH_B8B-XH-A_1x08_P2.50mm_Vertical
J9: UART0: TX RX GND; PinHeader_1x03_P2.54mm_Vertical
J10: SPARE GPIO; PinHeader_1x14_P2.54mm_Vertical
JP1: CAN TERM (fit = bus end); PinHeader_1x02_P2.54mm_Vertical
R1, R2, R7, R9, R10, R11, R12, R15: 10k; R_0603_1608Metric
R3, R4: 5.1k; R_0603_1608Metric
R5: 0R (Rs: 10k-100k = slope control); R_0603_1608Metric
R6: 120; R_1206_3216Metric
R8, R16: 1k; R_0603_1608Metric
R13, R14: 4.7k; R_0603_1608Metric
SW1: RESET; SW_Push_1P1T_XKB_TS-1187A
SW2: BOOT; SW_Push_1P1T_XKB_TS-1187A
TP1: CANH; TestPoint_Pad_D1.5mm
TP2: CANL; TestPoint_Pad_D1.5mm
TP3: CAN_TX; TestPoint_Pad_D1.5mm
TP4: CAN_RX; TestPoint_Pad_D1.5mm
TP5: +3V3; TestPoint_Pad_D1.5mm
TP6: +5VD; TestPoint_Pad_D1.5mm
TP7: GND; TestPoint_Pad_D1.5mm
U1: ESP32-S3-WROOM-1-N8; ESP32-S3-WROOM-1
U2: USBLC6-2SC6; SOT-23-6
U3: SN65HVD230; SOIC-8_3.9x4.9mm_P1.27mm
U4: AP2112K-3.3; SOT-23-5

Connections:
+3V3: C1.1, C2.1, C5.1, C6.1, J7.1, J8.3, J10.1, R1.1, R2.1, R7.1, R9.1, R10.1, R11.1, R12.1, R13.1, R14.1, R15.1, R16.1, TP5.1, U1.2 (3V3), U3.3 (VCC), U4.5 (VOUT)
+5V: D3.2 (A), J8.1
+5VD: C4.1, C8.1, D1.4 (VDD), D2.1 (K), D3.1 (K), J5.1, J6.1, TP6.1, U4.1 (VIN), U4.3 (EN)
CANH: J2.1, J3.1, R6.1, TP1.1, U3.7 (CANH)
CANL: J2.2, J3.2, JP1.2 (B), TP2.1, U3.6 (CANL)
CAN_RS: R5.1, U3.8 (Rs)
CAN_RX: TP4.1, U1.5 (IO5), U3.4 (R)
CAN_TERM: JP1.1 (A), R6.2
CAN_TX: TP3.1, U1.4 (IO4), U3.1 (D)
CC1: J1.A5 (CC1), R3.1
CC2: J1.B5 (CC2), R4.1
EN: C3.1, R1.2, SW1.1, U1.3 (EN)
ENC_CLK: J7.4, U1.20 (IO12)
ENC_CSN: J7.3, R11.2, U1.18 (IO10)
ENC_DO: J7.5, R12.2, U1.21 (IO13)
ESTOP: C7.1, R8.2, U1.6 (IO6)
ESTOP_IN: J4.1, R7.2, R8.1
GND: C1.2, C2.2, C3.2, C4.2, C5.2, C6.2, C7.2, C8.2, D1.2 (VSS), D4.1 (K), J1.A1 (GND), J1.A12 (GND), J1.B1 (GND), J1.B12 (GND), J1.SH (SHIELD), J2.3, J3.3, J4.2, J5.2, J6.2, J7.2, J8.2, J8.8, J9.3, J10.14, R3.2, R4.2, R5.2, SW1.2, SW2.2, TP7.1, U1.1 (GND), U1.40 (GND), U1.41 (GND), U2.2 (GND), U3.2 (GND), U4.2 (GND)
GPIO11: J10.2, U1.19 (IO11)
GPIO15: J10.3, U1.8 (IO15)
GPIO16: J10.4, U1.9 (IO16)
GPIO17: J10.5, U1.10 (IO17)
GPIO18: J10.6, U1.11 (IO18)
GPIO21: J10.7, U1.23 (IO21)
GPIO38: J10.8, U1.31 (IO38)
GPIO39: J10.9, U1.32 (IO39)
GPIO40: J10.10, U1.33 (IO40)
GPIO41: J10.11, U1.34 (IO41)
GPIO42: J10.12, U1.35 (IO42)
GPIO47: J10.13, U1.24 (IO47)
HALL1: J5.3, R9.2, U1.39 (IO1)
HALL2: J6.3, R10.2, U1.38 (IO2)
I2C_SCL: J8.5, R14.2, U1.17 (IO9)
I2C_SDA: J8.4, R13.2, U1.12 (IO8)
INA_ALERT: J8.6, R15.2, U1.7 (IO7)
IO0_BOOT: R2.2, SW2.1, U1.27 (IO0)
LED_DIN: D1.3 (DIN), U1.25 (IO48)
LED_PWR_A: D4.2 (A), R16.2
MOTOR_EN: J8.7, U1.22 (IO14)
RXD0: J9.2, U1.36 (RXD0)
TXD0: J9.1, U1.37 (TXD0)
USB_DN: J1.A7 (D-), J1.B7 (D-), U1.13 (USB_D-), U2.3 (I/O2), U2.4 (I/O2)
USB_DP: J1.A6 (D+), J1.B6 (D+), U1.14 (USB_D+), U2.1 (I/O1), U2.6 (I/O1)
VBUS: D2.2 (A), J1.A4 (VBUS), J1.A9 (VBUS), J1.B4 (VBUS), J1.B9 (VBUS), U2.5 (VBUS)
