JoshChomps/7_DOF_Arm/hardware/board_c/deskarm_board_c.kicad_sch

## KiCad design hardware/board_c/deskarm_board_c.kicad_sch (2026-10-28)

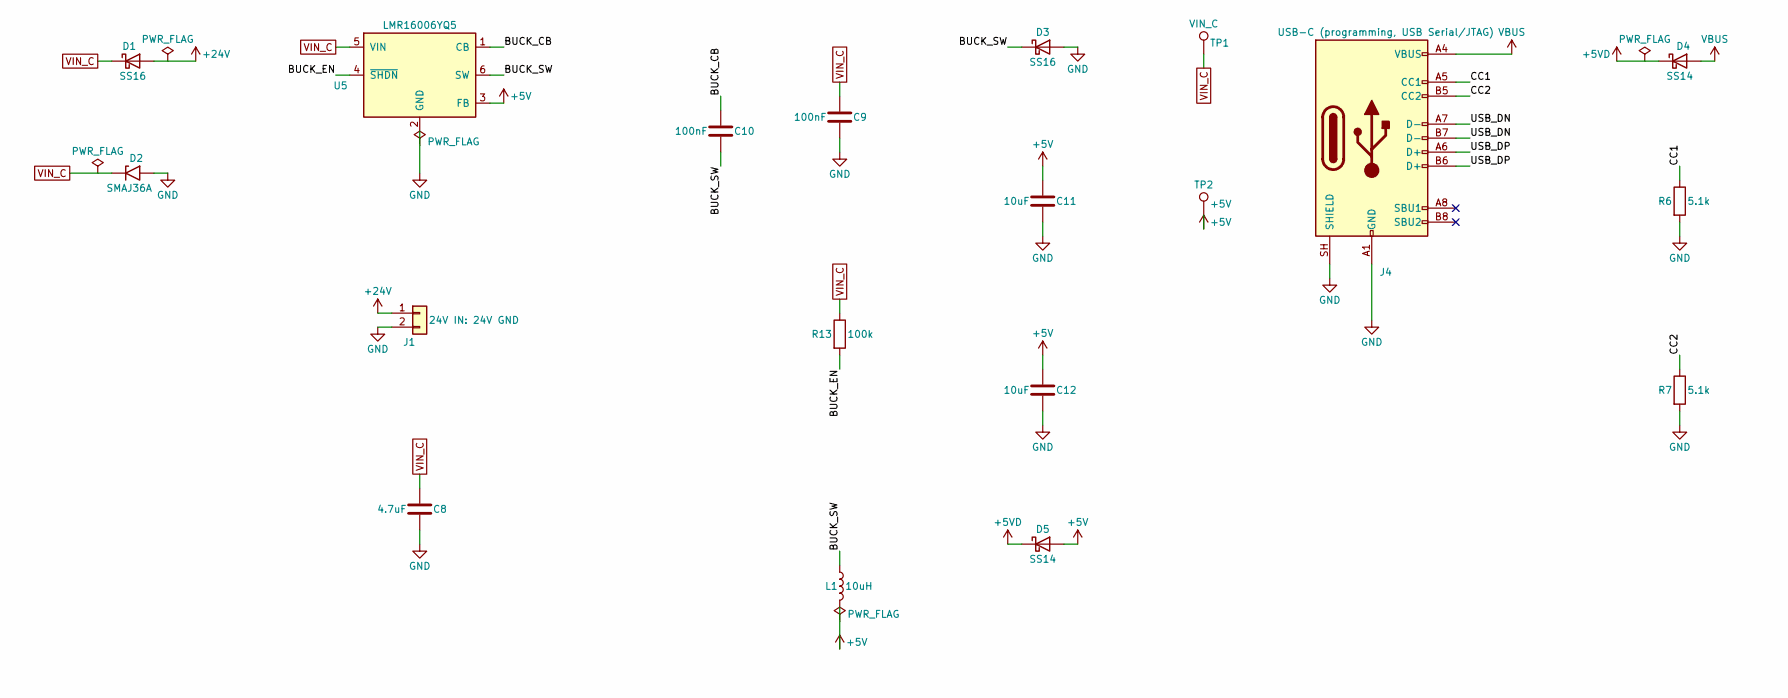
[picture p134: schematic deskarm_board_c.kicad_sch, part in row 1, column 1]

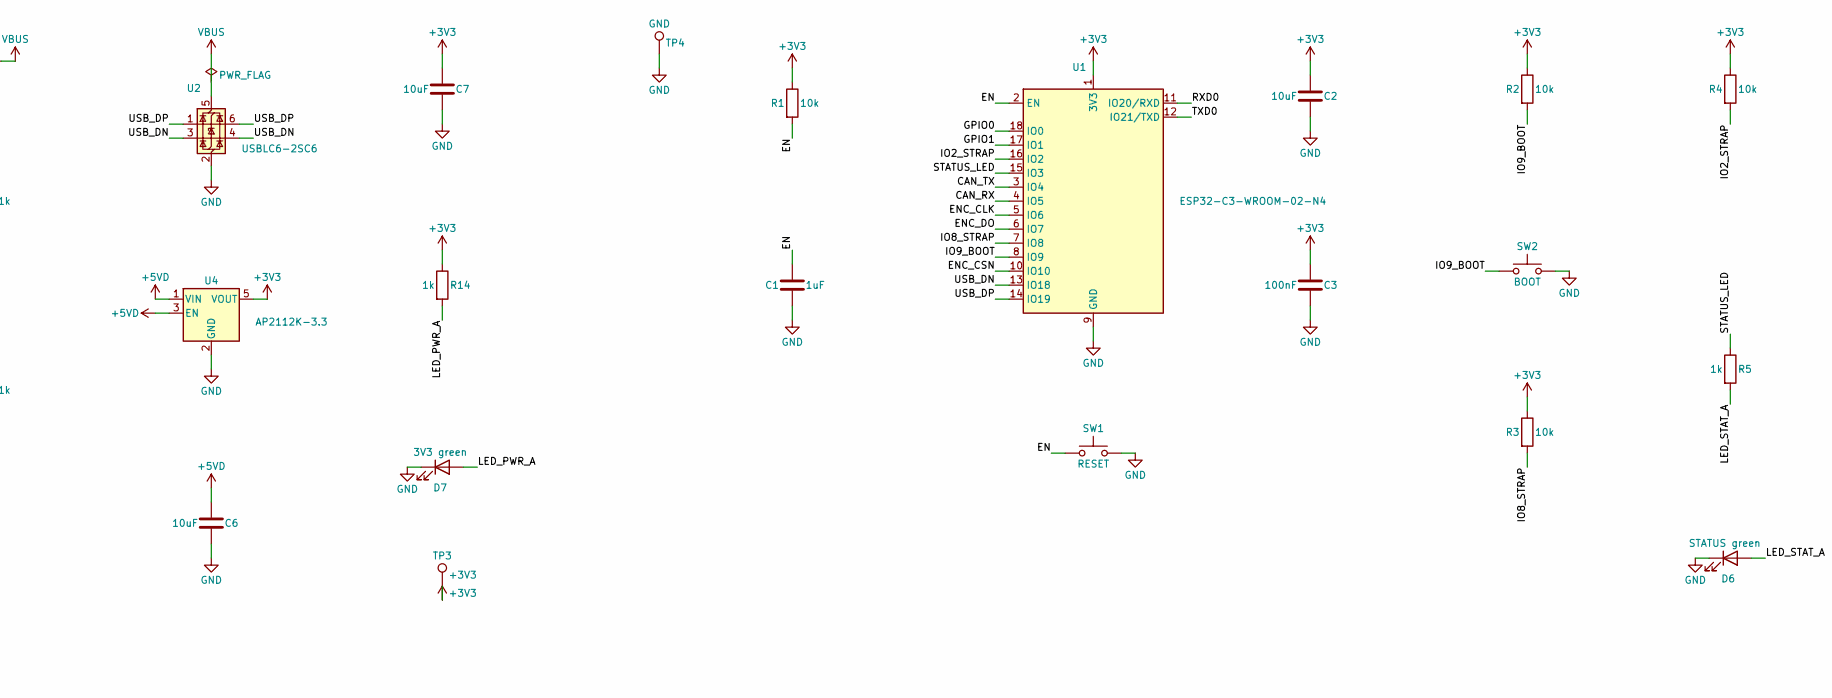
[picture p135: schematic deskarm_board_c.kicad_sch, part in row 1, column 2]

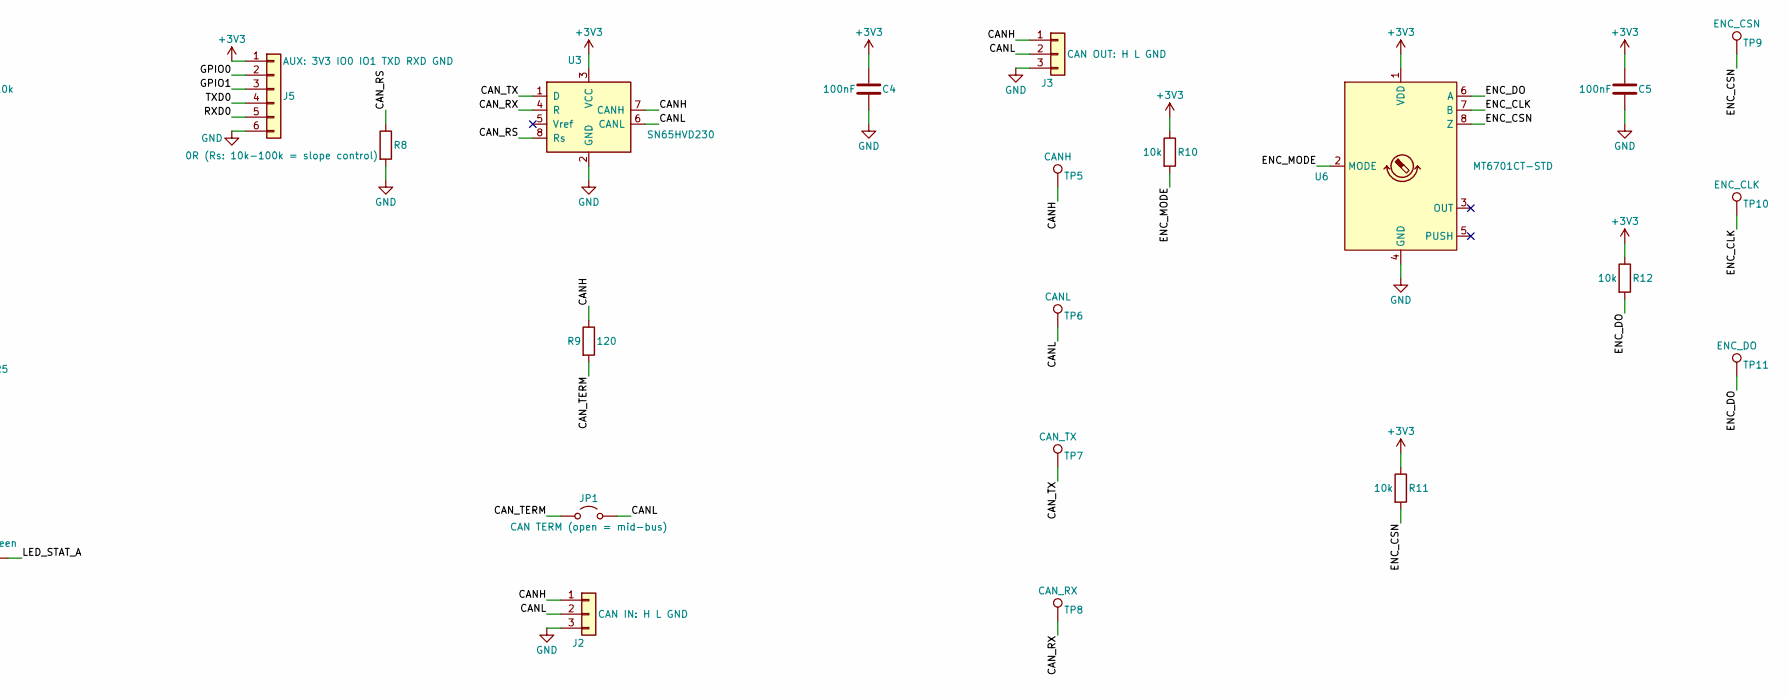
[picture p136: schematic deskarm_board_c.kicad_sch, part in row 1, column 3]

Parts:
C1: 1uF; C_0603_1608Metric
C2, C6, C7, C11, C12: 10uF; C_0805_2012Metric
C3, C4, C5, C9, C10: 100nF; C_0603_1608Metric
C8: 4.7uF; C_1206_3216Metric
D1, D3: SS16; D_SMA
D2: SMAJ36A; D_SMA
D4, D5: SS14; D_SMA
D6: STATUS green; LED_0603_1608Metric
D7: 3V3 green; LED_0603_1608Metric
J1: 24V IN: 24V GND; JST_XH_B2B-XH-A_1x02_P2.50mm_Vertical
J2: CAN IN: H L GND; JST_XH_B3B-XH-A_1x03_P2.50mm_Vertical
J3: CAN OUT: H L GND; JST_XH_B3B-XH-A_1x03_P2.50mm_Vertical
J4: USB-C (programming, USB Serial/JTAG); USB_C_Receptacle_GCT_USB4105-xx-A_16P_TopMnt_Horizontal
J5: AUX: 3V3 IO0 IO1 TXD RXD GND; PinHeader_1x06_P2.54mm_Vertical
JP1: CAN TERM (open = mid-bus); PinHeader_1x02_P2.54mm_Vertical
L1: 10uH; L_APV_ANR4030
R1, R2, R3, R4, R10, R11, R12: 10k; R_0603_1608Metric
R5, R14: 1k; R_0603_1608Metric
R6, R7: 5.1k; R_0603_1608Metric
R8: 0R (Rs: 10k-100k = slope control); R_0603_1608Metric
R9: 120; R_1206_3216Metric
R13: 100k; R_0603_1608Metric
SW1: RESET; SW_Push_1P1T_XKB_TS-1187A
SW2: BOOT; SW_Push_1P1T_XKB_TS-1187A
TP1: VIN_C; TestPoint_Pad_D1.5mm
TP2: +5V; TestPoint_Pad_D1.5mm
TP3: +3V3; TestPoint_Pad_D1.5mm
TP4: GND; TestPoint_Pad_D1.5mm
TP5: CANH; TestPoint_Pad_D1.5mm
TP6: CANL; TestPoint_Pad_D1.5mm
TP7: CAN_TX; TestPoint_Pad_D1.5mm
TP8: CAN_RX; TestPoint_Pad_D1.5mm
TP9: ENC_CSN; TestPoint_Pad_D1.5mm
TP10: ENC_CLK; TestPoint_Pad_D1.5mm
TP11: ENC_DO; TestPoint_Pad_D1.5mm
U1: ESP32-C3-WROOM-02-N4; ESP32-C3-WROOM-02
U2: USBLC6-2SC6; SOT-23-6
U3: SN65HVD230; SOIC-8_3.9x4.9mm_P1.27mm
U4: AP2112K-3.3; SOT-23-5
U5: LMR16006YQ5; TSOT-23-6
U6: MT6701CT-STD; SOIC-8_3.9x4.9mm_P1.27mm

Connections:
+3V3: C2.1, C3.1, C4.1, C5.1, C7.1, J5.1, R1.1, R2.1, R3.1, R4.1, R10.1, R11.1, R12.1, R14.1, TP3.1, U1.1 (3V3), U3.3 (VCC), U4.5 (VOUT), U6.1 (VDD)
+5V: C11.1, C12.1, D5.2 (A), L1.2, TP2.1, U5.3 (FB)
+5VD: C6.1, D4.1 (K), D5.1 (K), U4.1 (VIN), U4.3 (EN)
+24V: D1.2 (A), J1.1
BUCK_CB: C10.1, U5.1 (CB)
BUCK_EN: R13.2, U5.4 (~SHDN)
BUCK_SW: C10.2, D3.1 (K), L1.1, U5.6 (SW)
CANH: J2.1, J3.1, R9.1, TP5.1, U3.7 (CANH)
CANL: J2.2, J3.2, JP1.2 (B), TP6.1, U3.6 (CANL)
CAN_RS: R8.1, U3.8 (Rs)
CAN_RX: TP8.1, U1.4 (IO5), U3.4 (R)
CAN_TERM: JP1.1 (A), R9.2
CAN_TX: TP7.1, U1.3 (IO4), U3.1 (D)
CC1: J4.A5 (CC1), R6.1
CC2: J4.B5 (CC2), R7.1
EN: C1.1, R1.2, SW1.1, U1.2 (EN)
ENC_CLK: TP10.1, U1.5 (IO6), U6.7 (B)
ENC_CSN: R11.2, TP9.1, U1.10 (IO10), U6.8 (Z)
ENC_DO: R12.2, TP11.1, U1.6 (IO7), U6.6 (A)
ENC_MODE: R10.2, U6.2 (MODE)
GND: C1.2, C2.2, C3.2, C4.2, C5.2, C6.2, C7.2, C8.2, C9.2, C11.2, C12.2, D2.2 (A2), D3.2 (A), D6.1 (K), D7.1 (K), J1.2, J2.3, J3.3, J4.A1 (GND), J4.A12 (GND), J4.B1 (GND), J4.B12 (GND), J4.SH (SHIELD), J5.6, R6.2, R7.2, R8.2, SW1.2, SW2.2, TP4.1, U1.9 (GND), U1.19 (GND), U2.2 (GND), U3.2 (GND), U4.2 (GND), U5.2 (GND), U6.4 (GND)
GPIO0: J5.2, U1.18 (IO0)
GPIO1: J5.3, U1.17 (IO1)
IO2_STRAP: R4.2, U1.16 (IO2)
IO8_STRAP: R3.2, U1.7 (IO8)
IO9_BOOT: R2.2, SW2.1, U1.8 (IO9)
LED_PWR_A: D7.2 (A), R14.2
LED_STAT_A: D6.2 (A), R5.2
RXD0: J5.5, U1.11 (IO20/RXD)
STATUS_LED: R5.1, U1.15 (IO3)
TXD0: J5.4, U1.12 (IO21/TXD)
USB_DN: J4.A7 (D-), J4.B7 (D-), U1.13 (IO18), U2.3 (I/O2), U2.4 (I/O2)
USB_DP: J4.A6 (D+), J4.B6 (D+), U1.14 (IO19), U2.1 (I/O1), U2.6 (I/O1)
VBUS: D4.2 (A), J4.A4 (VBUS), J4.A9 (VBUS), J4.B4 (VBUS), J4.B9 (VBUS), U2.5 (VBUS)
VIN_C: C8.1, C9.1, D1.1 (K), D2.1 (A1), R13.1, TP1.1, U5.5 (VIN)
