JoshChomps/7_DOF_Arm/firmware/base_controller/base_controller.ino

// deskarm base controller: ESP32-S3 USB <-> CAN bridge (SLCAN) + E-stop monitor.
//
// This file is empty on purpose. The Arduino IDE compiles everything under src/ as part of this
// sketch: setup() and loop() are in src/main.cpp, the protocol core is in src/slcan.
// Board settings and flashing steps: README.md in this folder.
