JoshChomps/7_DOF_Arm/firmware/joint_encoder/joint_encoder.ino

// deskarm joint encoder node (board C): ESP32-C3 + MT6701 + CAN.
//
// This file is empty on purpose. The Arduino IDE compiles everything under src/ as part of this
// sketch: setup() and loop() are in src/main.cpp, pins and the joint id in src/config.h. The MT6701
// decoder is shared with the base controller (firmware/base_controller/src/mt6701) and is added as a
// library: see README.md in this folder.
