JoshChomps/7_DOF_Arm/tools/print_pack.py

#!/usr/bin/env python3
"""First prints, as Bambu Studio projects ready to open and send (docs/24).

    python tools/print_pack.py            # bench parts, motor-plate drawings, then every job below
    python tools/print_pack.py c2 bench   # only these jobs

Makes three things:
  stl/bench/C2_Stand.stl, C2_Lever.stl   a stand that holds the J2 module by its three tabs, output up, and a 105 mm
                                         lever on the output flange (pointer, hook hole for weights, Ø6 rod bore)
  stl/bench/<C2|C34>_motor_plate.dxf/.svg the 3 mm aluminium motor plate (D39), 1:1, for cutting or as a drill template
  stl/plates/<job>/plate_N.3mf           each job oriented, placed and sliced on the A1 mini (settings of
                                         slice_parts.py), with stl/plates/summary.json (hours and grams per plate)

The numbers come from tools/fusion_arm.py (imported with Fusion's API stubbed out), so the bench parts follow the CAD.
Orientation: coupons and bench parts print as modelled; the module parts use mesh_audit's least-overhang face,
except where a bearing seat would end up sideways (ORIENT).
"""
import json
import re
import subprocess
import sys
import tempfile
import zipfile
from pathlib import Path
from unittest import mock

import numpy as np
from manifold3d import CrossSection, Manifold, Mesh

for _k in ("adsk", "adsk.core", "adsk.fusion"):
    sys.modules.setdefault(_k, mock.MagicMock())
import fusion_arm as FA                                          # noqa: E402  (needs the stub above)
import slice_parts as SP                                         # noqa: E402
from cadio import write_dxf, write_stl                           # noqa: E402
from fusion_lib import circle_pts, polar, stadium                # noqa: E402
from mesh_audit import audit, load                               # noqa: E402

ROOT = Path(__file__).resolve().parent.parent
BENCH, PLATES = ROOT / "stl" / "bench", ROOT / "stl" / "plates"
C2 = [f"DA_C2_{n}" for n in ("Housing", "Cover", "Flange", "Carrier", "Disc", "Discb", "Spacers", "Shaft", "Pulley40",
                             "Enccap")]
JOBS = {   # job -> STLs (paths from the repo root); each is sliced on as few A1 mini plates as fit
    "coupons": ["stl/coupons/pins.stl", "stl/coupons/inserts.stl", "stl/coupons/pegs.stl", "stl/coupons/bearings.stl"],
    "rings": ["stl/coupons/rings_6810.stl", "stl/coupons/rings_6806.stl"],
    "c2": [f"stl/da/{n}.stl" for n in C2],
    "bench": ["stl/bench/C2_Stand.stl", "stl/bench/C2_Lever.stl"],
}
ORIENT = {"DA_C2_Enccap": "Z+"}    # least overhang lays it on its side, which turns the MR126 seat sideways (oval)
BED = 165.0                        # usable A1 mini bed, mm (slice_parts uses 170 for a single part)
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
